raghavvs/Autonomous-Landing-of-Model-Rockets/README.md

# Autonomous-Landing-of-Model-Rockets
In this this project we attempt to land a model rocket propulsively. It is a work in progress and we'll keep this repo updated.
