raghavvs/Autonomous-Landing-of-Model-Rockets/Rocket Design/Properties.pdf

Rocket_Assembly_New_3 v8

Component Instances (1)
Area 6.253E+05 mm^2
Density 8.742E-04 g / mm^3 Mass 764.61 g
Volume | 8.746E+05 mm^3
Physical Material | (Various)

Bounding Box
Length | 234.60 mm
Width 863.863 mm
Height 234.60 mm
World X,Y,Z 0.00 mm, 0.00 mm, 0.00 mm
Center of Mass 0.092 mm, 325.495 mm, 0.056 mm

Moment of Inertia at Center of Mass (g mm^2)
Ixx = 4.811E+07
Ixy = 1.613E+04
Ixz = 311.913
Iyx = 1.613E+04
Iyy = 1.595E+06
Iyz = 6569.055
Izx = 311.913
Izy = 6569.055
Izz = 4.814E+07

Moment of Inertia at Origin (g mm^2) Ixx = 1.291E+08
Ixy = -6726.793
Ixz = 307.956
Iyx = -6726.793
Iyy = 1.595E+06
Iyz = -7452.45
Izx = 307.956
Izy = -7452.45
Izz = 1.291E+08
