raghavvs/Autonomous-Landing-of-Model-Rockets/Autonomous Precision Landing of Model Rockets_Final_compressed_final.pdf

## DAYANANDA SAGAR COLLEGE OF ENGINEERING DEPARTMENT OF MECHANICAL ENGINEERING

(Accredited by NBA)
Accredited by National Assessment & Accreditation Council (NAAC) with ‘A’ Grade AICTE Approved, an Autonomous Institute Affiliated to VTU, Belagavi Shavige Malleshwara Hills, Kumaraswamy Layout, Bengaluru-560078

## A Project Report on

# AUTONOMOUS PRECISION LANDING OF MODEL ROCKETS

## Submitted in partial fulfillment for the award of degree of

## BACHELOR OF ENGINEERING

IN

## MECHANICAL ENGINEERING

## Submitted by

## 1DS17ME093 Raghavendra N S 1DS17ME124 Sohail Nadaf 1DS17ME131 Tushar V Kulkarni 1DS17ME145 Vivek S Srinivas

### Under the guidance of

# Sanketh S

## Assistant Professor Department of Mechanical Engineering Dayananda Sagar College of Engineering, Bengaluru S M Hills, Kumaraswamy Layout, Bengaluru 560078

2020-21

Autonomous Precision Landing of Model Rockets

# DAYANANDA SAGAR COLLEGE OF ENGINEERING

## DEPARTMENT OF MECHANICAL ENGINEERING

(Accredited by NBA)
Accredited by National Assessment & Accreditation Council (NAAC) with ‘A’ Grade
AICTE Approved, an Autonomous Institute Affiliated to VTU, Belagavi) Shavige Malleshwara Hills, Kumaraswamy Layout, Bengaluru-560078

# Certificate

Certified that the project report entitled ‘Autonomous Precision Landing of Model Rockets’ is a bonafide work carried out by Raghavendra N S, Sohail Nadaf, Tushar V Kulkarni, Vivek S Srinivas, bearing USN: 1DS17ME093, 1DS17ME124, 1DS17ME131,

### 1DS17ME145, under the guidance of Prof. Sanketh S, Assistant Professor, Department of

### Mechanical Engineering, Dayananda Sagar College of Engineering, Bengaluru, in partial

### fulfilment for the award of Bachelor of Engineering in Mechanical Engineering of the

Visvesvaraya Technological University, Belagavi.

Sanketh S | Dr. R. Keshavamurthy
Assistant Professor Dayananda Sagar College of Engineering Bengaluru | Professor & Head, Dept. of Mech. Engg
| Dayananda Sagar College of Engineering
| Bengaluru

### Dr. C.P.S. Prakash

### Principal

### Dayananda Sagar College of Engineering

### Bengaluru

### External Viva-Voce

Sl. No. | Name of the Examiner | Signature with date
1
2
Department of Mechanical Engineering | ii | Dayananda Sagar College of Engineering

# DECLARATION

### We, Raghavendra N S (1DS17ME093), Sohail Nadaf (1DS17ME124), Tushar V Kulkarni

### (1DS17ME131), Vivek S Srinivas (1DS17ME145) hereby declare that the entire work

### embodied in the project report entitled ‘Autonomous Precision Landing of Model Rockets’

has been independently carried out by Batch 48 under the guidance of Prof. Sanketh S,

### Assistant Professor, Department of Mechanical Engineering, Dayananda Sagar College of

Engineering, Bengaluru, in partial fulfilment of the requirements for the award of Bachelor Degree in Mechanical Engineering of Visvesvaraya Technological University, Belagavi.

I further declare that I have not submitted this report either in part or in full to any other university for the award of any degree.

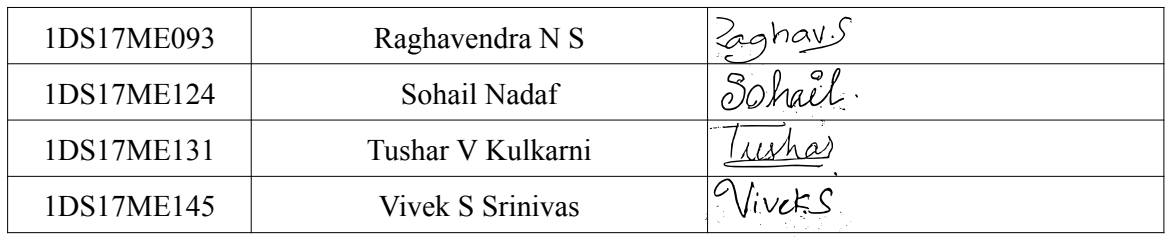
[picture p1: figure]
Raghavendra N S; Sohail Nadaf; Tushar V Kulkarni; Vivek S Srinivas

### Place: Bengaluru

### Date: 10-May-2021

Department of Mechanical Engineering | iii | Dayananda Sagar College of Engineering

# ABSTRACT

### This project aims to build a model rocket that can land vertically. By establishing an

automatic control system, we contrive to pull out any perturbations and disturbances ensuring active control. Thrust Vector Control (TVC) is the technique used for attitude (pitch and yaw) control, this gimbal mount allows the rocket to be actively stabilized and is the key component to allow the rocket to land vertically.

A closedloop feedback control system consisting of a Proportional Integral Derivative (PID)

### controller is employed to maneuver the rocket, additional components such as the Kalman

### Filter will be used to eliminate noise and disturbances from sensory feedback. A flight

computer is utilized to monitor the rocket, this includes data logging, stabilization, prediction,

### and state indication. The rocket is powered by a solid propellant motor serving as the

propulsion system.

### The rocket body and its components are designed considering the principles of Design for

### Assembly (DFA) and Design for Manufacturing (DFM), using Computer-Aided Design

### (CAD) software and analyzed using Finite Element Method (FEM) solvers. Computational

### Fluid Dynamics (CFD) is applied to visualize the flow around the rocket airframe and to

evaluate the design of passive fins.

Department of Mechanical Engineering | iv | Dayananda Sagar College of Engineering

# ACKNOWLEDGEMENT

We have taken efforts in this work. However, it would not have been possible without the kind support and help of many individuals and organizations. We would like to extend my sincere thanks to all of them.

### We express our deep sense of gratitude and indebtedness to Prof. Sanketh S, Assistant

### Professor, Department of Mechanical Engineering, for his valuable guidance, continuous

assistance in the critical appraisal of the thesis.

### We express our sincere thanks to Dr. R. Keshavamurthy, Professor and HOD, Department of

Mechanical Engineering, for providing the facilities required for the completion of this project work.

It is with great pleasure, we extend our gratitude and thanks to Dr. C P S Prakash, Principal, Dayananda Sagar College of Engineering, for his encouragement throughout the project.

Department of Mechanical Engineering | v | Dayananda Sagar College of Engineering

## Contents

List of Tables | x
List of Figures | x
List of Acronyms | x
1 Executive Summary | 1
2 Management Summary | 3
3 Conceptual Design | 6
4 Airframe | 8
5 Propulsion | 25
Department of Mechanical Engineering | vi | Dayananda Sagar College of Engineering

6 Dynamic Flight Analysis | 27
7 Thrust Vector Control | 41
8 Dynamics | 43
Department of Mechanical Engineering | vii | Dayananda Sagar College of Engineering

9 Modelling and Simulation | 61
10 Flight Computer | 65
11 Manufacturing | 75
12 Conclusions | 79
13 References | 81
14 Appendix | 83
Department of Mechanical Engineering | viii | Dayananda Sagar College of Engineering

15 ANNEXURE | 109
Department of Mechanical Engineering | ix | Dayananda Sagar College of Engineering

## List of Tables

1 | Cost breakdown | | 5
2 | Chemical Propulsion Vs Electric Propulsion | | 8
3 | Solid Propellant Vs Liquid Propellant | | 8
4 | Cardboard Material Properties | | 9
5 | Airframe Specifications | 10
6 | Polyactic Acid (PLA) Material Properties | 11
7 | Landing Leg Specifications | 11
8 | Landing Leg Strut Specifications | 12
9 | Landing Leg Circular Frame Specifications | 12
10 Fins Specifications | 13
11 Weight Distribution | 15
12 Overall Specifications | 15
13 Airframe Structural Analysis Results | 17
14 Modal Frequencies of Airframe | 19
15 Fins Structural Analysis Results | 21
16 Landing Leg Structural Analysis Results | 23
17 Landing Leg Strut Structural Analysis Results | 24
18 Bulkhead Structural Analysis Results | 25
19 F-15 Motor Specications | 26
20 Moment Table | 28
21 Flight Dynamics Parameters | 32
22 Input Parameters for Drag Analysis | 37
23 Drag Analysis Results | 38
24 Design I Specifications | 43
25 Design II Specifications | 43
26 Properties used in simulation | 61
27 Components Specifications | 70
Department of Mechanical Engineering | x | Dayananda Sagar College of Engineering

## List of Figures

1 | Team Organization | | 3
2 | Gantt Chart | | 4
3 | Risk Identification | | 5
4 | Cost Distribution | | 6
5 | Methodology: Design Phase | | 6
6 | Methodology: Manufacturing Phase | | 7
7 | Rocket Airframe | | 9
8 | Landing Legs Assembly Closed Form | 10
9 | Landing Legs Assembly Open Form | 10
10 Landing Legs Assembly Side View | 11
11 Fins Assembly Render | 13
12 Rocket Part Description | 14
13 Rocket Assembly Render | 14
14 Airframe von Mises Stress | 16
15 Airframe Displacement | 16
16 Airframe Mode 1 Shape | 17
17 Airframe Mode 2 Shape | 18
18 Airframe Mode 3 Shape | 18
19 Fins von Mises Stress | 19
20 Fins Displacement | 20
21 Fins Strain | 20
22 Fins Mode 8 Shape | 21
23 Landing Leg von Mises Stress | 22
24 Landing Leg Displacement | 22
25 Landing Leg Strut von Mises Stress | 23
26 Landing Leg Strut Displacement | 23
27 Bulkhead von Mises Stress | 24
28 Bulkhead Displacement | 24
29 F-15 Motor Thrust Curve | 26
30 OpenRocket: Simulation | 27
31 Forces on Rocket | 27
32 OpenRocket: Centre of Pressure | 29
33 C.G and C.P Mark | 29
34 Rocket Axis Orientation | 30
35 Aerodynamic Drag Representation | 33
Department of Mechanical Engineering | xi | Dayananda Sagar College of Engineering

36 Cf Vs Velocity | 33
37 Cfc Vs Velocity | 33
38 CDLT Vs Velocity | 34
39 CDBT Vs Velocity | 34
40 CDfT Vs Velocity | 34

41 CDt

T Vs Velocity | 34
42 CDTT Vs Velocity | 34
43 CDBP Vs Velocity | 35
44 CDBB Vs Velocity | 35
45 CfB Vs Velocity | 35
46 CDTB Vs Velocity | 35
47 CD Vs Velocity | 36
48 CD Vs Reynolds Number | 36
49 Component Drag Vs Velocity | 36
50 Component Drag Distribution | 36
51 Velocity Field | 40
52 Pressure Field | 40
53 Gimbaled TVC | 41
54 Design I | 42
55 Design II | 42
56 Inner Product | 44
57 Vector Product | 45
58 P! being expressed in Fr and F1 | 46
59 Rodrigues’ Rotation | 47
60 Fv to F1 | 48
61 F1 to F2 | 49
62 F2 to Fb | 49
63 Quaternions | 54
64 Rigid body hurtling through space | 55
65 Rotation and Translation | 56
66 Simulink Blocks | 60
67 Basic Flight Simulation | 62
68 Results | 62
69 3 DOF Flight Simulation | 63
70 Actuator Subsystem | 63
71 Trajectory | 64
72 Acceleration | 64
Department of Mechanical Engineering | xii | Dayananda Sagar College of Engineering

73 Microcontroller: Teensy 3.2 | 65
74 IMU: MPU6050 Module | 66
75 Altimeter: BMP180 Module | 66
76 nRF24l01+ Transceiver module | 67
77 Voltage Regulator | 67
78 Trigger Channels | 68
79 Metal Gear Servo Motor | 68
80 LiPO Battery | 69
81 Flight Computer 1 | 69
82 Flight Computer 2 | 70
83 Schematics | 71
84 Printed Circuit Board | 72
85 Block Diagram | 73
86 Flow Chart | 74
87 Processing via Python | 75
88 FDM Printer: Ender 3 | 76
89 Airframe | 77
90 Fins | 78
91 Landing Leg Assembly Closed Form | 78
92 Landing Leg Assembly Open Form | 79
93 Thrust Vector Control | 79
Department of Mechanical Engineering | xiii | Dayananda Sagar College of Engineering

## List of Acronyms

α | Angle of Attack
ρ | Density
c | Chord
Cl | Sectional Lift Coefficient
CD | Coefficient of Drag
CFD | Computational Fluid Dynamics
M∞ | Freestream Mach Number

D Drag

L Lift

rle | Leading Edge Radius
DOF | Degrees of Freedom
CG | Center of Gravity
TVC | Thrust Vector Control
NED | North-East-Down
FEM | Finite Element Method
FVM | Finite Volume Method
RANS | Reynolds Averages Navier Stokes
LES | Large Eddy Simulation
DNS | Direct Numerical Simulation
FFF | Fused Filament Fabrication
FDM | Fused Deposition Modelling
PLA | Polylactic Acid
ABS | Acrylonitrile Butadiene Styrene
PETG | Polyethylene Terephthalate Glycol
TPU | Thermoplastic Polyurethane
DFA | Design for Assembly
DFM | Design for Manufacturing
CAD | Computer-Aided Design
FEM | Finite Element Method
CFD | Computational Fluid Dynamics
IMU | Inertial Measurement Unit
AHRS | Attitude Heading Reference System
Department of Mechanical Engineering | xiv | Dayananda Sagar College of Engineering

## 1 Executive Summary

Traditionally, payloads have been delivered into space using rockets, upon running out of fuel these rocket boosters

are expended and either burn up in the atmosphere or crash into the ocean. This is extremely wasteful and is

economically unviable. Reusing launch vehicles just like airplanes will lead to a reduction of the cost of access to

space by as much as a factor of a hundred. In the past few years, companies like SpaceX and Blue Origin have

successfully reused a launch vehicle.

Our project proposes to bridge this gap and contribute to the increasing need for small scale launch vehicles. The

goal of this project is to build a fully reusable and autonomously landing model rocket. This involves developing

the hardware, software, simulations, and procedures necessary to propulsively land a small scale rocket with the

capability of reuse.

Another hurdle we plan to tackle is to propulsively land using a solid propellant motor that doesn’t possess throttle

control, unlike largescale rockets that use a liquid propellant engine that could use throttle control. Our project

analysis indicates that the successful development of this system shows significant potential to save costs for

smaller launch vehicles by enabling them to propulsively land and be reused. For report writing, the team used

LaTeX software.

### 1.1 Objectives

- Building an aerodynamic rocket body and fins to achieve maximum passive stability.
- Developing a Thrust Vector Control (TVC) system for active attitude control.
- Integrating a Flight computer for Data logging and various other operations.
- Developing Landing legs to withstand the impact and ensuring the safety of components.
- Modelling and Simulation of rocket dynamics using MATLAB & Simulink.
- Testing and validation of designed components.

### 1.2 Literature Review

The concept of retrieving a launch vehicle/rocket after successful execution of its launching stages is an

inherently challenging task owing to the large number of uncertainties in the upper atmosphere. These

uncertainties coupled with the scale of costs involved with space missions necessitate the implementation of

model rockets to realize the behaviour of control systems which are used in precision landing of the rocket. In

this report we present an autonomous precision landing control system, along with the necessary dynamics and

simulations required to support this claim. As this project involves application of different domains like control

systems, spacecraft dynamics and controls, aerodynamic stability, MEMS, the literature survey conducted is

modular, with an emphasis on control systems and dynamics.

Department of Mechanical Engineering | 1 | Dayananda Sagar College of Engineering

- M. Haw, A8-3 Model rocket impulse measurement, Science One Research Projects (Undergraduate Science

Program), University of British Columbia, British Columbia, Canada, May 2009.

This paper depicts the measurement of thrust from the model rocket engine in the form of impulse. It

also gives an emphasis on the measurement of impulse from the rocket engine as it will majorly affect the

trajectory of the descending model rocket. The methodology includes the measurement of thrust as a function

of time and extracting impulse readings using finite difference approximations.

- R. Ferrante, A Robust Control Approach for Rocket Landing, M.S. thesis, Artificial Intelligence, School of

Informatics, University of Edinburgh, Scotland, 2017.

This M.S. thesis provides a concise description of control techniques and simulation environments for

modelling a rocket. Although the thesis involves actual scale, it does very well apply to model rockets with

suitable assumptions.

- L. Blackmore Autonomous precision landing of space rockets, Frontiers of Engineering: Reports on Leading-

Edge Engineering from the Symposium 2016.

The paper discusses the importance of reusing space rockets and its challenges.

- F. Kehl, A. M. Mehta, K. S. J. Pister, An Attitude Controller for Small Scale Rockets, Springer Tracts in

Advanced Robotics, Jan 2015.

In this paper, the hardware testing and experimental tests were conducted along with a depiction of

implementation of PID control techniques.

- Penn, Kim & Slaton, William, Measuring Model Rocket Engine Thrust Curves, The Physics Teacher, 2010.

The paper provides a methodology for solid propellant model rocket engine thrust curves which is used to

determine the engine ignition altitude.

- Aliyu Bhar Kisabo and Aliyu Funmilayo Adebimpe,State-Space Modeling of a Rocket for Optimal Control

System Design, Centre for Space Transport and Propulsion (CSTP), 2010.

This paper delineates the basic equations defining the airframe dynamics of a typical six degrees of freedom

(6DoFs) are nonlinear and coupled. It also presents a novelapproach to linearization of 6DoF equations in

a general form.

- Florian Kehl, Ankur M. Mehta and Kristofer S. J. Pister An Attitude Controller for Small Scale Rockets,

Springer Tracts in Advanced Robotics, 2015.

This paper comprises of minirocket design, adaptation for minirocket design, guidance control system,

hardware testing and experimental results such as, sensor validation and attitude control validation.

- Mark D. Stevenson and Jeffrey V. Zweber, Multidisciplinary Conceptual Vehicle Modelling, American

Institute for Aeronautics and Astronautics (AIAA), 2001.

This paper narrates the discipline interaction, vehicle geometry, rocket engine design code, weight

analysis, aerodynamic analysis, trajectory analysis, trade studies and thrusttoweight optimization.

Department of Mechanical Engineering | 2 | Dayananda Sagar College of Engineering

- B. Stevens and F. Lewis, Aircraft Control and Simulation. Wiley, 2003.

This textbook covers flight control systems, flight dynamics, aircraft modeling, and flight simulation from

both classical design and modern perspectives, as well as two new chapters on the modeling, simulation,

and adaptive control of unmanned aerial vehicles.

- S. Niskanen, “Openrocket technical documentation,” Development of an Open Source model rocket

simulation software.

The thesis is used as the basis of this technical documentation, which is updated to account for later

development in the software. Discussed the development and documentation for relatively easy, yet

reasonably accurate methods for the calculation of the fundamental aerodynamic properties of model.

Implementation of a crossplatform, open source model rocket design and simulation software.

- P. Kuentzmann, “Introduction to Solid Rocket Propulsion,” Office National d’Etudes et de Recherches

Aérospatiales, 2000.

This paper describes the fundamentals of solid rocket propulsion (SRM) from the elementary analysis of

rocket operation. It also contains a short review of internal aerodynamics of SRM and the basic formula to

predict the steadystate operation pressure.

## 2 Management Summary

### 2.1 Team Organization

The team comprised of four members and the responsibilities were equally distributed.

- Airframe & Propulsion Research, Sizing, Design, CFD & Optimization, Selection of Propulsion System
- Modelling & Simulation Research, Dynamics & Control, Analysis using MATLAB & Simulink
- Thrust Vector Control Research, Fabrication, Testing & Optimization
- Flight Computer Research, Flight Computer Design, PCB Design, Testing

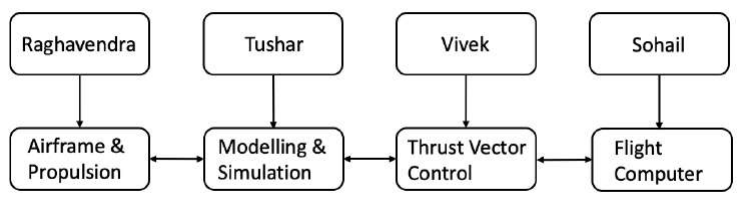
[picture p2: figure]

Figure 1: Team Organization

Department of Mechanical Engineering | 3 | Dayananda Sagar College of Engineering

### 2.2 Milestone Chart

The Gantt chart was implemented to plan the workflow and to keep a track of progress. The blue bar shows the

planned days and the grey bar shows the actual days. From the chart it is evident that testing and procurement of

materials took longer than anticipated.

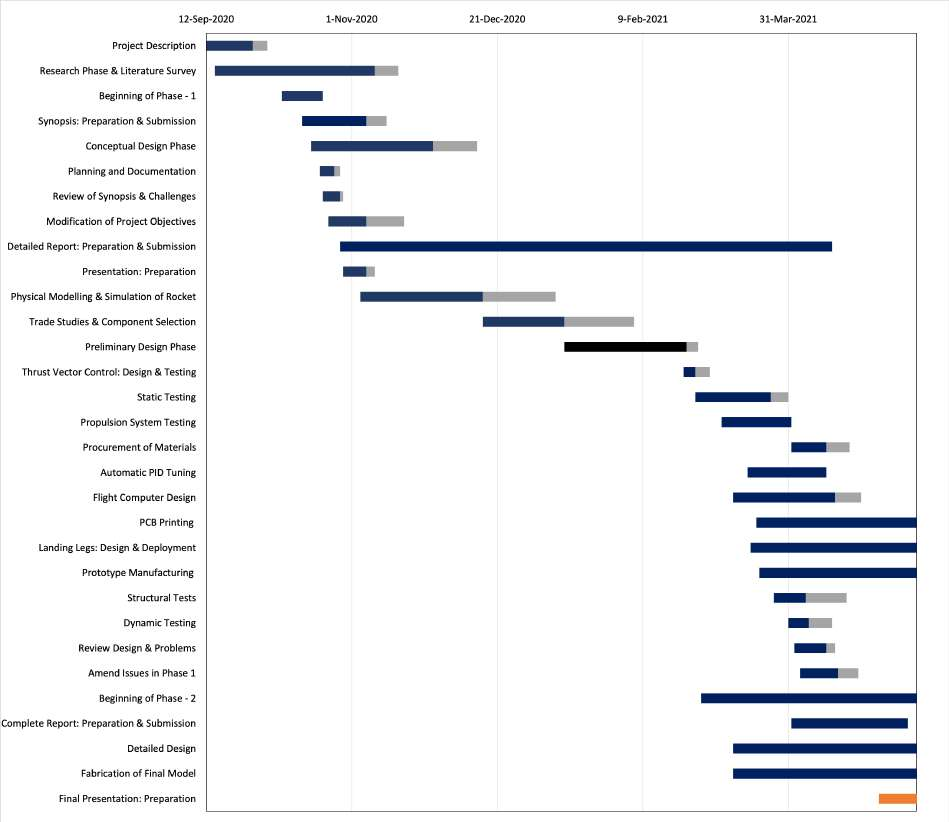
[picture p3: figure]

Figure 2: Gantt Chart

### 2.3 Risk Analysis

A risk assessment chart is depicted below and it helps in understanding and managing the risks involved. It is

apparent from the chart that both the likelihood and consequences of tipping over during landing is likely and the

consequences are high.

Department of Mechanical Engineering | 4 | Dayananda Sagar College of Engineering

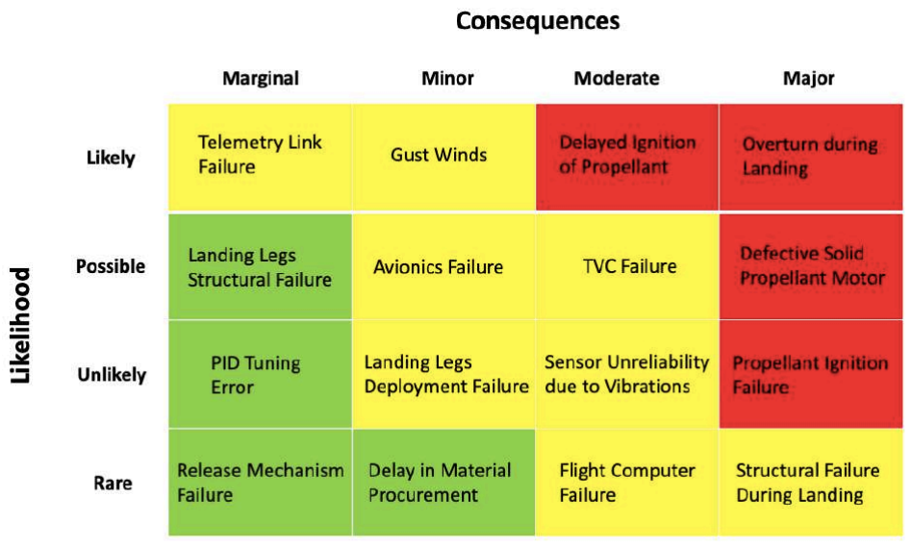
[picture p4: figure]

Figure 3: Risk Identification

### 2.4 Budget Details

The team had a budget of Rs. 25,000 for the entire project. We managed to stay under budget, the team’s total

expenses came up to be Rs. 21,200. Expenditure towards avionics accounted for majority of team’s total budget.

Sl. No. | Description | Cost (in Rs.)
1 | Avionics | 9700
2 | PLA Material | 1200
3 | Testing Equipment | 5200
4 | Body | 600
5 | Miscellaneous | 4500
6 | Total | 21200

Table 1: Cost breakdown

Department of Mechanical Engineering | 5 | Dayananda Sagar College of Engineering

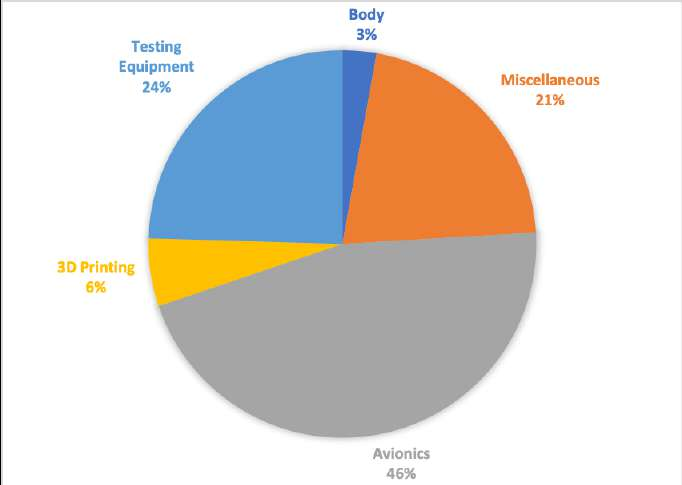
[picture p5: figure]

Figure 4: Cost Distribution

## 3 Conceptual Design

### 3.1 Overall Methodology

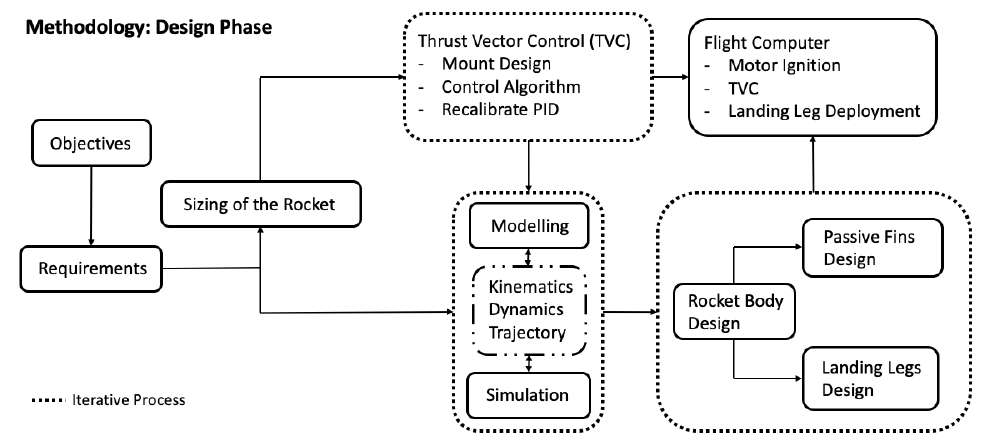
[picture p6: figure]

Figure 5: Methodology: Design Phase

We began by clearly defining the project’s core objectives, which was followed by the description of requirements,

which led to the rocket’s sizing. TVC mount was created with the help of computeraided design (CAD) software.

Iterations were carried out until the desired product was achieved. Simultaneously, MATLAB and Simulink were

used to model and simulate the rocket dynamics and trajectory. The rocket body, fins, and landing legs were then

designed. The shape of fins was analysed using computational fluid dynamics (CFD). Various tasks, such as TVC,

motor ignition, and landing leg deployment, were programmed into the flight computer. Lastly, the rocket’s flight

Department of Mechanical Engineering | 6 | Dayananda Sagar College of Engineering

was simulated to ascertain PID gains.

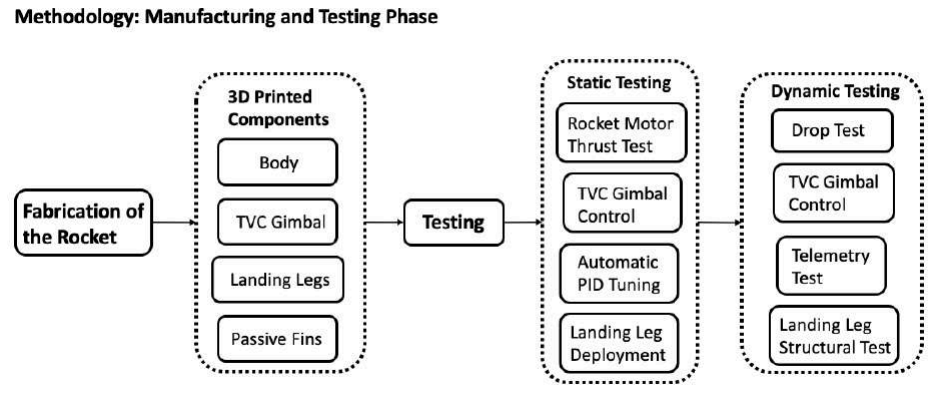
[picture p7: figure]

Figure 6: Methodology: Manufacturing Phase

The manufacturing and testing phase were carried out after conducting all the necessary computer simulations,

design finalization and CFD analyses. 3D printing was used to fabricate the landing legs, fins and thrust vector

control. The necessary components for testing as well as some internal parts for the rocket body were printed using

a 3D printer. The manufacturing phase was followed by the testing phase, which began with static tests. First, a

static thrust test of the rocket motor, a TVC gimbal test, and a landing leg deployment test. Then we moved on to

dynamic testing, where we performed a drop test, a telemetry test, and an impact test on the landing legs.

### 3.1.1 Trade Studies

We used a Pugh Matrix method for selection of propulsion system, beginning with choosing the type of propulsion

i.e., chemical propulsion and electric propulsion. This method of selection helped us objectively choose the kind

of propulsion while having numerous subjective and arbitrary parameters. The weightage for the parameters were

given as per the team’s objectives and priorities, and accordingly weight and cost were given the utmost importance

considering the design restriction. The reason behind considering electric propulsion in the first place was to have

more control over the throttle and have capacity to conduct frequent and a number of tests without worrying about

the flight time i.e., the endurance. This table below shows that the chemical propulsion is relatively more desirable

for our project.

Department of Mechanical Engineering | 7 | Dayananda Sagar College of Engineering

Parameters | Weight | Chemical Propulsion | Electric Propulsion
Weight | 5 | 5 | 1
Complexity | 3 | 3 | 3
Reusability | 3 | 1 | 5
Feasibility | 4 | 3 | 3
Cost | 4 | 4 | 2
Total | | 65 | 49

Table 2: Chemical Propulsion Vs Electric Propulsion

As per the kind of propellant, we considered both solid propellant and liquid propellant. The weightage for the

parameters were given as per the team’s objectives and priorities, and accordingly ability to throttle and cost were

given the utmost importance. From this table below we concluded to go with solid propellant.

Parameters | Weight | Solid Propellant | Liquid Propellant
Throttleable | 3 | 1 | 5
Complexity | 3 | 4 | 2
Reusability | 3 | 1 | 4
Feasibility | 4 | 5 | 3
Cost | 4 | 5 | 1
Total | | 58 | 49

Table 3: Solid Propellant Vs Liquid Propellant

## 4 Airframe

### 4.1 Methodology

The airframe design was dictated by two parameters, namely weight and lower bending moment to reduce the

chances of the rocket tipping over upon landing and this is imperative in achieving the team’s objectives.

For the airframe, we considered cardboard as the choice of material since it had desirable properties such as high

strength to weight ratio, low density which translates lower weight, easy to work with and economical.

The airframe diameter and length were decided upon iterative process. Parametric analysis was carried out using

fineness ratio (length to diameter ratio) and this helped us in determining the optimum ratio. The range of fineness

ratio is generally 10:1 to 20:1 [1][2][3]. The parameters that are affected by fineness ratio are:

- Skin friction drag
- Pressure drag
Department of Mechanical Engineering | 8 | Dayananda Sagar College of Engineering

- Bending moment

The chosen ratio is 10:1 which is the lowest fineness ratio since this aids in maintaining a lower overall weight

and also assists in keeping the bending moments to a minimum. The skin friction drag is reduced mainly due

to relatively lower wetted are and the pressure drag is slightly increased this is because the pressure distribution

around a body which has low fineness ratio is not ideal and this causes the increase in pressure drag. The airframe

houses the propulsion system, thrust vector control system and electronics. Externally, the fins and landing legs

are attached to the airframe as well.

### 4.1.1 Airframe Mechanical Design

The airframe design and modelling was accomplished on Autodesk Fusion 360. As for the design approach, the

team was limited in terms of varying the shell thickness of the airframe due to unavailability of cardboard tubes

which was the material of choice for the airframe. The airframe’s diameter was chosen based on the propellent’s

diameter and thrust vector control system’s outer gimbal diameter apart from fineness ratio. Consequently the

length was determined.

Figure 7: Rocket Airframe

The material properties of rocket airframe tube i.e., cardboard is presented in the table below. A noteworthy

property of cardboard is its endurance, high strength to weight ratio, low impact on sudden impulsive forces and

also substantially economical.

Sl. No. | Description | Value
1 | Density | 195 kg/m³
2 | Poisson’s Ratio | 0.34
3 | Elasticity Modulus | 2194 MPa
4 | Shear Modulus | 565 MPa

Table 4: Cardboard Material Properties

Department of Mechanical Engineering | 9 | Dayananda Sagar College of Engineering

Sl. No. | Parameters | Values
1 | Length | 0.762m
2 | Outer Diameter | 0.076m
3 | Inner Diameter | 0.073m
4 | Thickness | 0.003m
5 | Fineness Ratio | 10

Table 5: Airframe Specifications

### 4.2 Landing Legs

### 4.2.1 Design

The landing leg design was mainly inspired from SpaceX’s Falcon 9 Rocket. The team used a open source design

from K-9 landing leg system as a basis and we further modified the design to optimize for weight and strength. The

derived design helped the team to accelerate the process and arrive at the final design with minimum iterations.

The choice of material for this subsystem was Polyactic Acid (PLA) largely since the team had an easy access to

a 3D printer and it was economical too. The landing leg subsystem consists of four landing legs, four struts to

support the legs upon landing and a circular frame which houses all these. This circular frame is directly attached

to the airframe with the help of screws. The figures below show both the open and closed form of the landing legs.

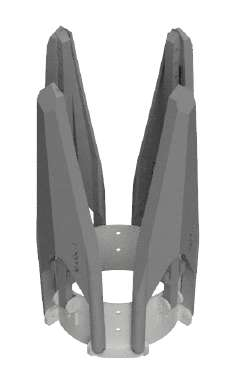
[picture p8: figure]

Figure 8: Landing Legs Assembly Closed Form

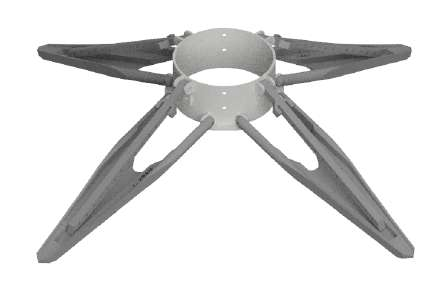
[picture p9: figure]

Figure 9: Landing Legs Assembly Open Form

In the figure below, the side view of the landing leg is shown, the landing legs are in open configuration and the opening angle for the leg is 109.4o and for the strut it is 115.4o.

Department of Mechanical Engineering | 10 | Dayananda Sagar College of Engineering

Figure 10: Landing Legs Assembly Side View

The choice of materials as previously mentioned is dictated by strength, weight and cost. Hence the team

decided to move forward with PLA. PLA has significantly better elasticity and it is not as brittle as other alternatives

such as ABS. Flexural strength of the material is also high which helps upon on impact on landing. The material

properties of PLA are presented in the table below.

Sl. No. | Description | Value
1 | Density | 1250 kg/m³
2 | Poisson’s Ratio | 0.34
3 | Elasticity Modulus | 3500 MPa
4 | Shear Modulus | 1287 MPa
1 | Melting Temperature | 170oC
2 | Injection Molding Temperature | 240oC
3 | Tensile Strength | 66 MPa
4 | Flexural Strength | 110 MPa

Table 6: Polyactic Acid (PLA) Material Properties

Sl. No. | Parameters | Values
1 | Length | 0.195m
2 | Root Width | 0.45m
3 | Tip Width | 0.015m
4 | Thickness | 0.01m
5 | Taper Ratio | 30
6 | Opening Angle | 109.4o

Table 7: Landing Leg Specifications

Department of Mechanical Engineering | 11 | Dayananda Sagar College of Engineering

Sl. No. | Parameters | Values
1 | Length | 0.165m
2 | Root Width | 0.009m
3 | Tip Width | 0.005m
4 | Thickness | 0.01m
6 | Opening Angle | 115.4o

Table 8: Landing Leg Strut Specifications

Sl. No. | Parameters | Values
1 | Length | 0.4m
2 | Outer Diameter | 0.079m
3 | Inner Diameter | 0.076m
4 | Thickness | 0.003m

Table 9: Landing Leg Circular Frame Specifications

### 4.3 Passive Fins

The stability and control of the rocket is determined by the fins’s reference area, wetted area, airfoil, thickness,

number of fins and position of the fins. Usually rocket’s fins are usually placed in the bottom of the body around the

propulsion system whereas in our project we only focused on landing the rocket and hence the fins were positioned

at the top of the rocket and this helps to head the TVC and propulsion system into the wind. These fins have a

passive control during the descent of the rocket and the team decided not to go with active control of the fins as

this could increase the complexity of control system design as well as the dynamics of flight.

### 4.3.1 Design

For the design of fins the team went for a flat plate design and discarded the use of any airfoils for the sake of

simplicity and also upon analysis it deemed unnecessary. The ratio of fin chord to diameter ratio and fin span to

diameter ratio is 2:1 and 1:1 respectively [1]. This was considered as a design criteria and we modelled the fins

using Autodesk Fusion 360 software. The team again chose to use PLA as the material for fins but the weight of

the fins went beyond the restricted limit, so weight reduction was carried out and it was layered with MonoKote

to cover the cutouts. The fins were attached with a circular ring and the circular ring is attached to the airframe with screws. The range for sweep angle is between 45 to 70 degrees [1], the sweep angle the team chose was 45o

as the flight was in subsonic region.

Department of Mechanical Engineering | 12 | Dayananda Sagar College of Engineering

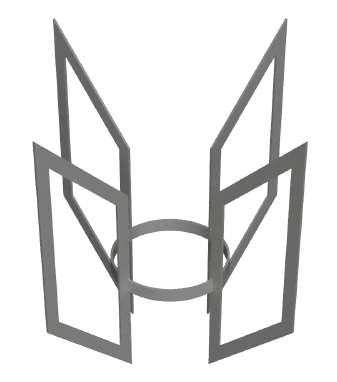
[picture p10: figure]

Figure 11: Fins Assembly Render

Sl. No. | Parameters | Values
1 | Chord | 0.152m
2 | Span | 0.076m
3 | Thickness | 0.003m
4 | Sweep Angle | 45o
5 | Chord to Diameter Ratio | 2:1
6 | Span to Diameter Ratio | 1:1
6 | Number of Fins | 4

Table 10: Fins Specifications

### 4.4 Assembly

The rocket’s main parts include fins, bulkheads, flight computer, airframe, landing legs, firewall, propellant and

thrust vector control. The picture below depicts all the components and a render of the assembled rocket. For the

rocket’s assembly the team decided to use temporary joints instead of permanent joints so as to increase modularity

and ease of replacement of parts in case of damage. For assembly, screws were used for attaching fins, TVC,

bulkheads and landing legs.

Department of Mechanical Engineering | 13 | Dayananda Sagar College of Engineering

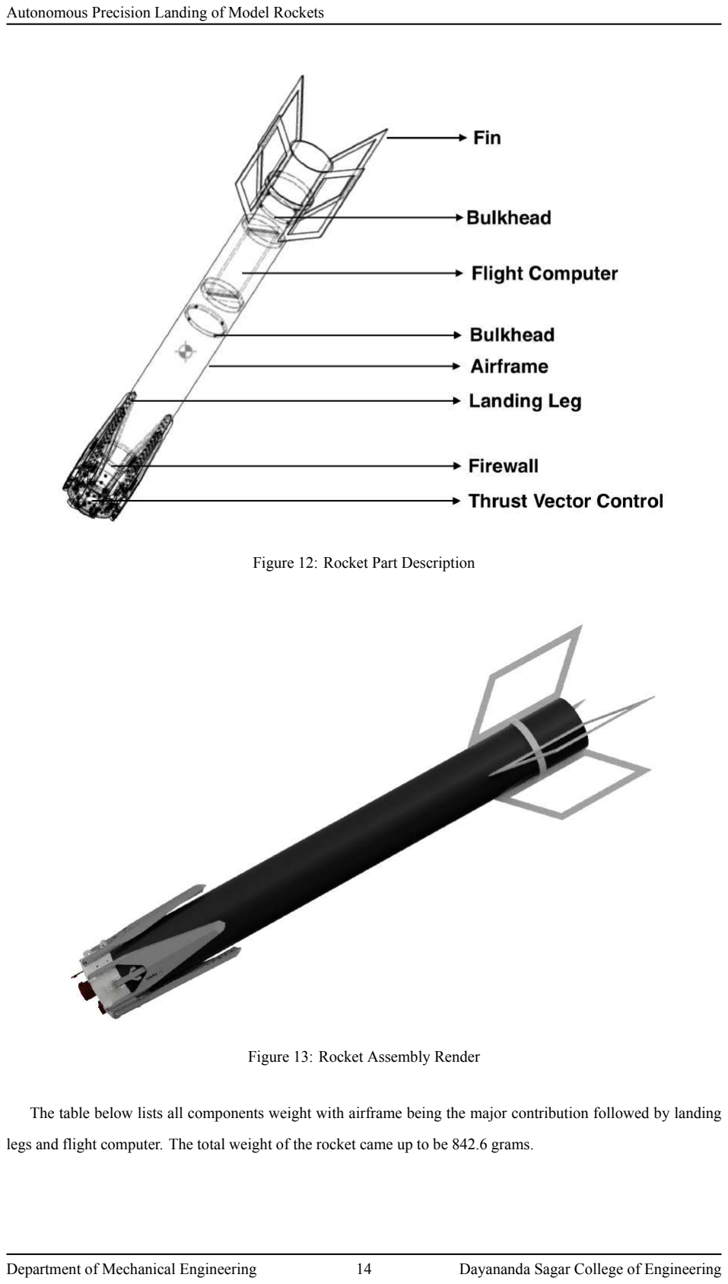
[picture p11: page 28]

Figure 12: Rocket Part Description

Figure 13: Rocket Assembly Render

The table below lists all components weight with airframe being the major contribution followed by landing

legs and flight computer. The total weight of the rocket came up to be 842.6 grams.

Department of Mechanical Engineering | 14 | Dayananda Sagar College of Engineering

Sl. No. | Components | Values (in grams)
1 | Airframe | 370
2 | Fins | 55.6
3 | Landing Legs | 214.5
4 | Propulsion | 50
5 | Thrust Vector Control | 52.5
6 | Flight Computer | 100
7 | Total Weight | 842.6

Table 11: Weight Distribution

Sl. No. | Parameters | Values
1 | Length | 0.835m
2 | Width | 0.381m
3 | Weight | 842.6g

Table 12: Overall Specifications

### 4.5 Analysis

### 4.5.1 Airframe Structural Analysis

The airframe takes in notable amount of stress during descent phase, apart from the force due to its weight a landing

impact load of five times its weight is applied on the airframe. The stresses on the airframe also includes upward

thrust force from the propulsion system which is transferred through the thrust vector control system. Autodesk

Fusion 360 software was used for both modelling and analysis using finite element method. In the Figure 14 below

von Mises stress analysis is carried out and the results are tabulated. The applied force is 50N on the rim of the

airframe which is a point force, the stresses and the displacement due to stress is minimal and within the factor of

safety and this does not lead to bending or yielding of airframe.

Department of Mechanical Engineering | 15 | Dayananda Sagar College of Engineering

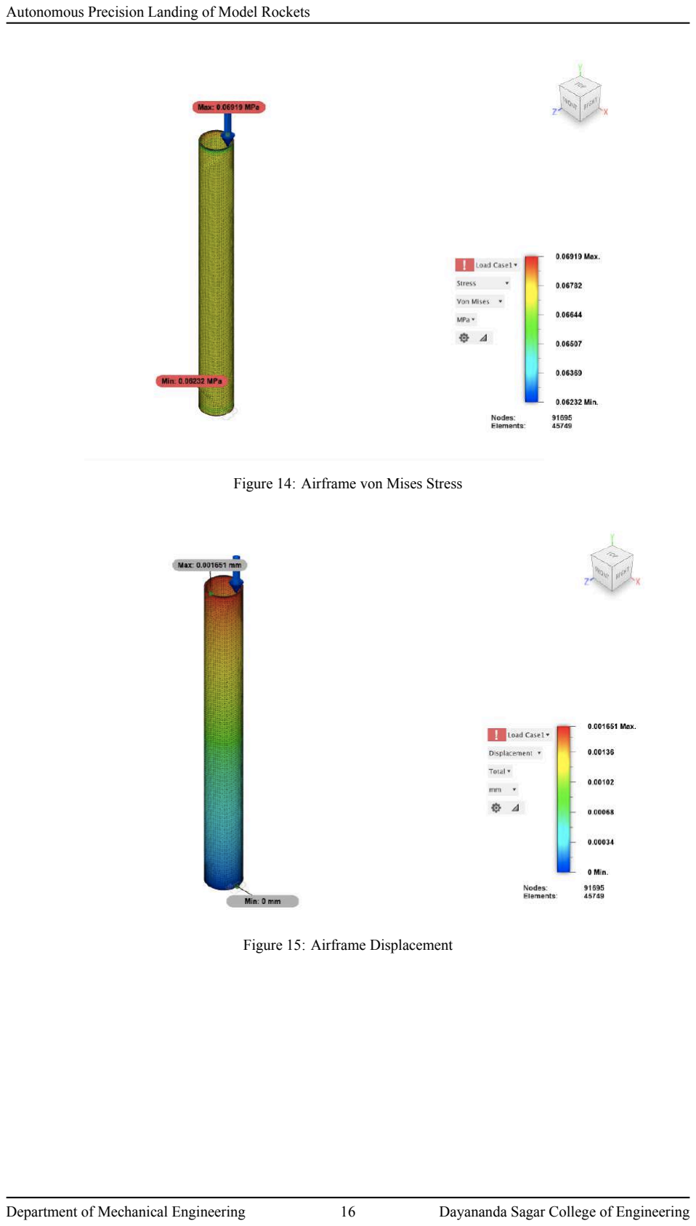
[picture p12: page 30]

Figure 14: Airframe von Mises Stress

Figure 15: Airframe Displacement

Department of Mechanical Engineering | 16 | Dayananda Sagar College of Engineering

Sl. No. | Parameters | Values
1 | Applied Force | 50N
2 | Maximum Stress | 0.069MPa
3 | Minimum Stress | 0.063MPa
4 | Maximum Displacement | 0.002mm
5 | Minimum Displacement | 0mm
6 | Mesh Size | 1mm
7 | Nodes | 91695
8 | Elements | 45749

Table 13: Airframe Structural Analysis Results

### 4.5.2 Airframe Modal Frequency Analysis

Modal frequency analysis was conducted to determine the natural frequency of the airframe. This was considered

paramount since we aimed to increase the natural frequency of the airframe to minimize flutter by preventing

the occurrence of resonance. The potential of resonance can lead to colossal damage to the airframe, hence this

analysis was helpful in determining the eigenfrequencies and its respective eigenmodes. The natural frequencies

and the mode shapes are tabulated.

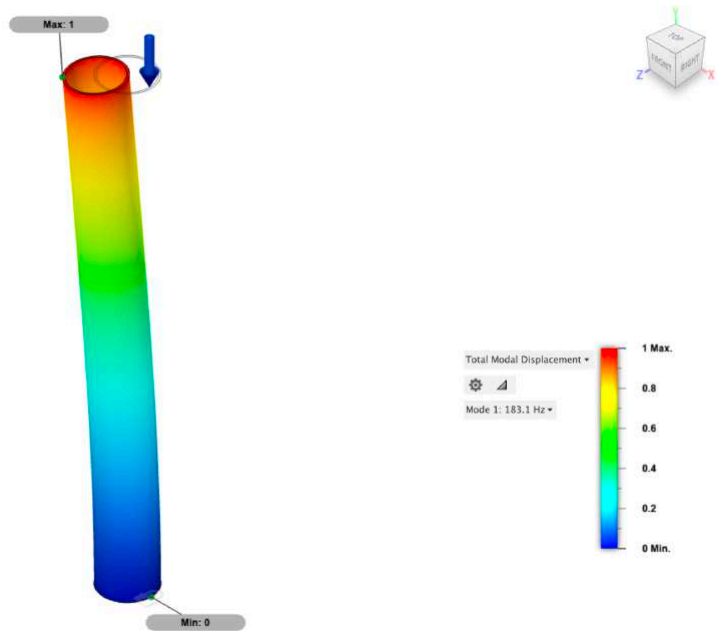
[picture p13: figure]

Figure 16: Airframe Mode 1 Shape

Department of Mechanical Engineering | 17 | Dayananda Sagar College of Engineering

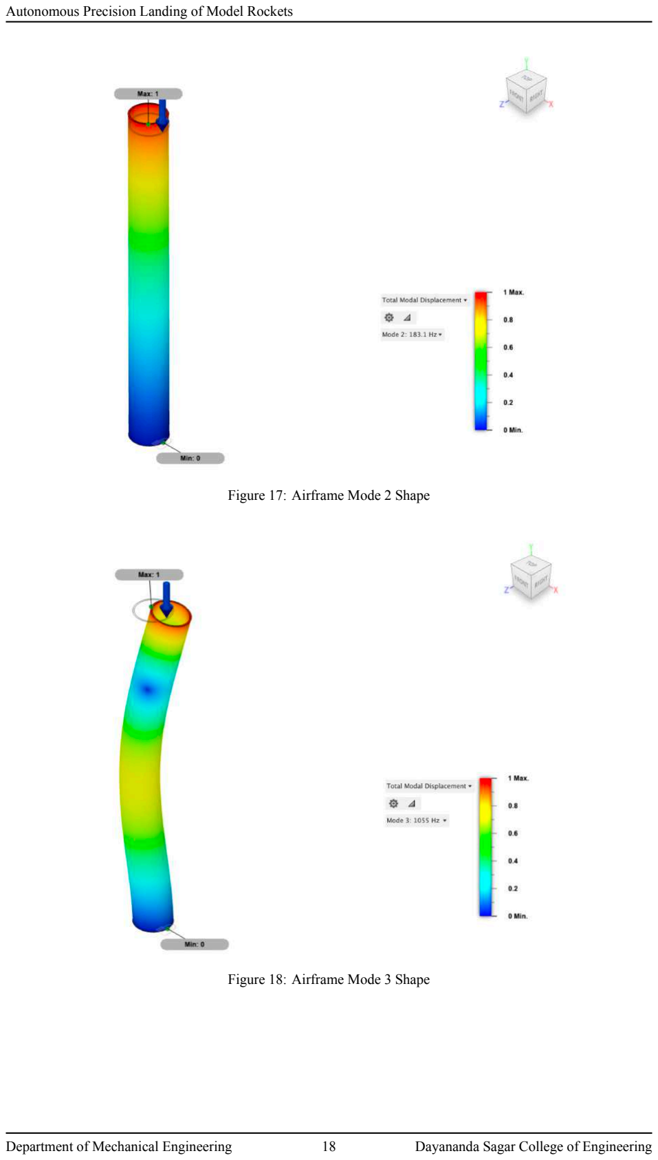
[picture p14: page 32]

Figure 17: Airframe Mode 2 Shape

Figure 18: Airframe Mode 3 Shape

Department of Mechanical Engineering | 18 | Dayananda Sagar College of Engineering

Sl. No. | Mode Shape | Natural Frequency (in Hz)
1 | Mode 1 | 183.1
2 | Mode 2 | 645.7
3 | Mode 3 | 1055

Table 14: Modal Frequencies of Airframe

### 4.5.3 Fins Structural Analysis

The fins undergo immense flutter during descent phase and since they play a crucial role in enabling passive

stability so as to maintain upright position, following through with static structural analysis was integral. The

joints strength, flutter analysis, deformation, maximum and minimum stresses and strain, and the displacement

due to stress were the parameters that were evaluated. A uniformly applied force of 10N was applied on the each

of the four fins and from the von Misses stress analysis it is evident that the stress was mostly concentrated at the

joint of fin ring and the fins while the displacement of the fins was at the far end of the fin. All the parameters and

their are tabulated below.

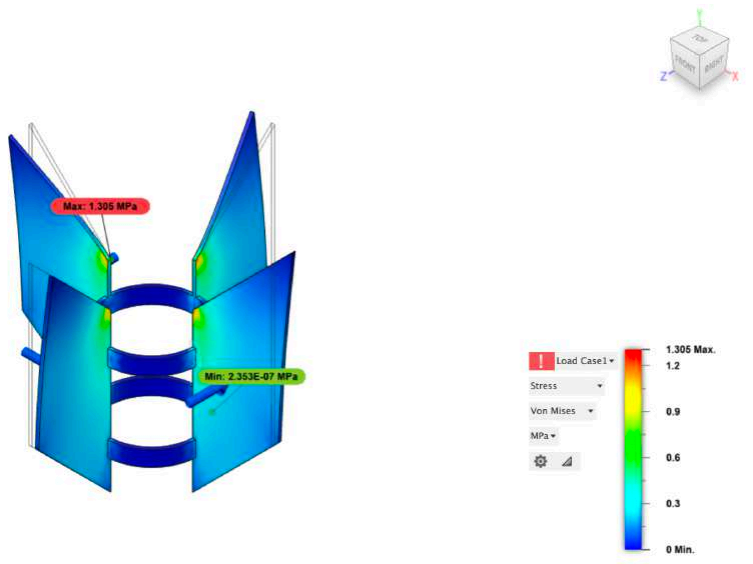
[picture p15: figure]

Figure 19: Fins von Mises Stress

Department of Mechanical Engineering | 19 | Dayananda Sagar College of Engineering

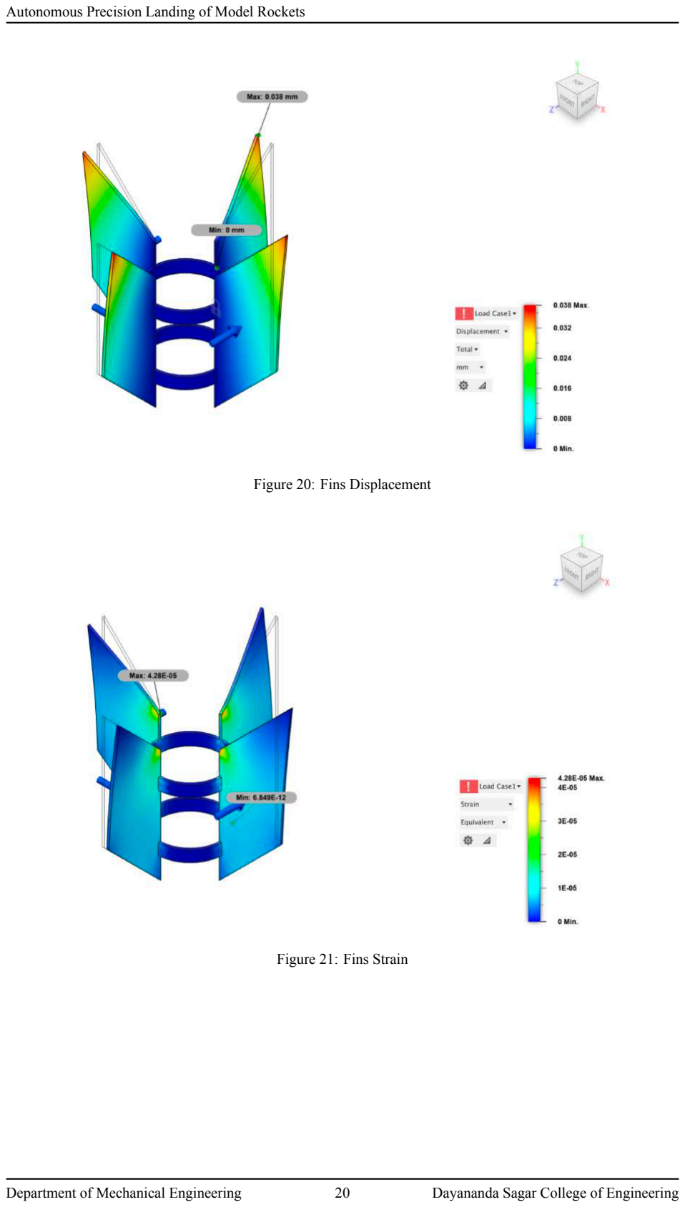
[picture p16: page 34]

Figure 20: Fins Displacement

Figure 21: Fins Strain

Department of Mechanical Engineering | 20 | Dayananda Sagar College of Engineering

Sl. No. | Parameters | Values
1 | Applied Force | 10N
2 | Maximum Stress | 1.305MPa
3 | Minimum Stress | 2.35e-07MPa
4 | Maximum Displacement | 0.038mm
5 | Minimum Displacement | 0mm
6 | Maximum Strain | 4.28e-05
7 | Minimum Strain | 6.84e-12
8 | Mesh Size | 1mm

Table 15: Fins Structural Analysis Results

### 4.5.4 Fins Modal Frequency Analysis

Modal frequency analysis was conducted to determine the natural frequency of the fins. This was considered

paramount since we aimed to increase the natural frequency of the fins to minimize flutter by preventing the

occurrence of resonance. The potential of resonance can lead to colossal damage to the fins and fins play a huge

role in maintaining the stability of the flight during descent, hence this analysis was helpful in determining the

eigenfrequencies and its respective eigenmodes. The natural frequency of fins in mode 8 is 1216Hz.

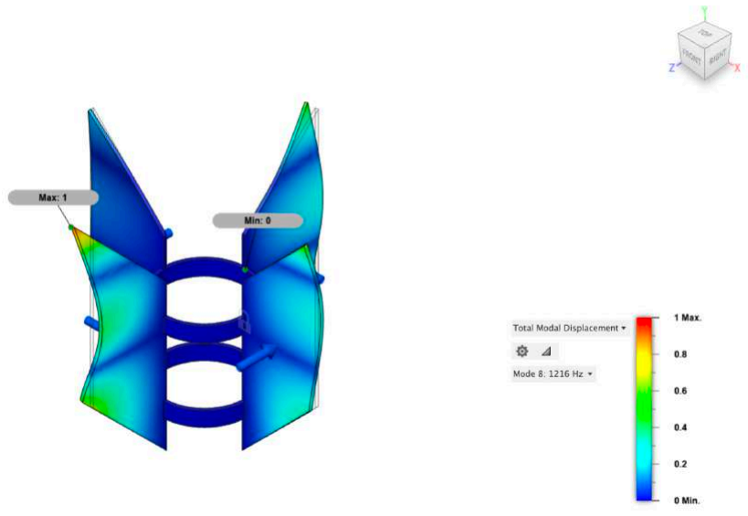
[picture p17: figure]

Figure 22: Fins Mode 8 Shape

Department of Mechanical Engineering | 21 | Dayananda Sagar College of Engineering

### 4.5.5 Landing Legs Structural Analysis

The landing legs is the only component that is going to experience imminent stress from the impact due to landing.

The stresses from landing legs is transferred to the struts which help them stay in that position. The stresses from

the struts are transmitted to the circular frame and then to the airframe. The analysis of von Mises stress on landing

legs showed significant stress at the joint of landing leg to the circular frame and minimum stress at the point of

contact with the ground. For this analysis an impact force of 50N was applied which is five times the weight of the

entire rocket and upon analysis, the landing legs can sustain the stresses without leading to breaking or yielding of

the material. The results from the analysis are tabulated below.

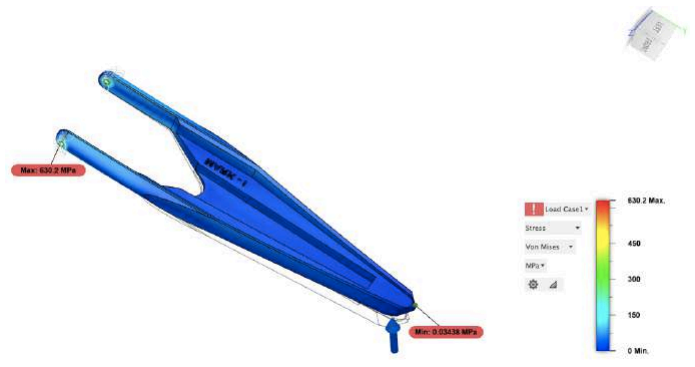
[picture p18: figure]

Figure 23: Landing Leg von Mises Stress

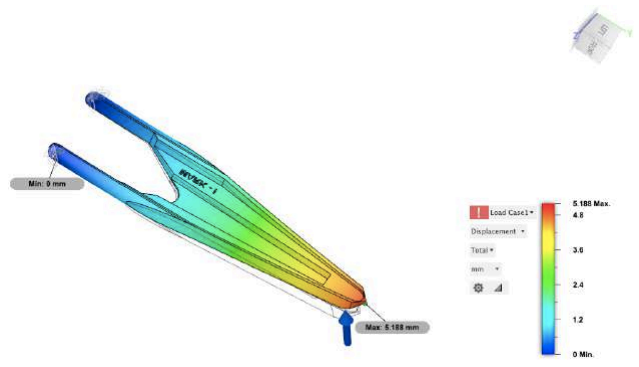
[picture p19: figure]

Figure 24: Landing Leg Displacement

Department of Mechanical Engineering | 22 | Dayananda Sagar College of Engineering

Sl. No. | Parameters | Values
1 | Applied Force | 50N
2 | Maximum Stress | 630.2MPa
3 | Minimum Stress | 0.034MPa
4 | Maximum Displacement | 5.188mm
5 | Minimum Displacement | 0mm
6 | Mesh Size | 1mm

Table 16: Landing Leg Structural Analysis Results

Similar to landing legs static structural analysis, we carried out a structural analysis on the landing leg strut

and the results too were quite similar. The applied force was 50N at the contact point and maximum stress was

experienced at the joint of the strut with the circular frame. The results from the analysis are tabulated below.

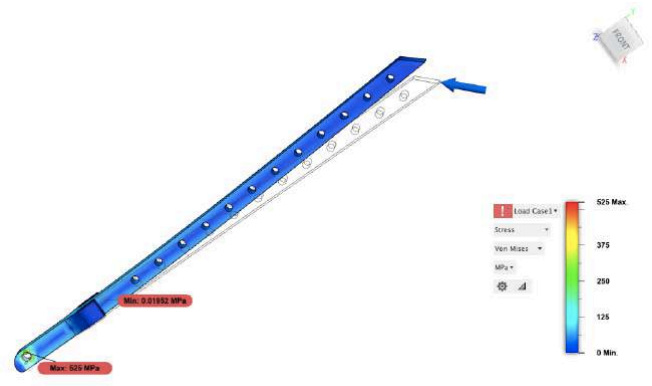
[picture p20: figure]

Figure 25: Landing Leg Strut von Mises Stress

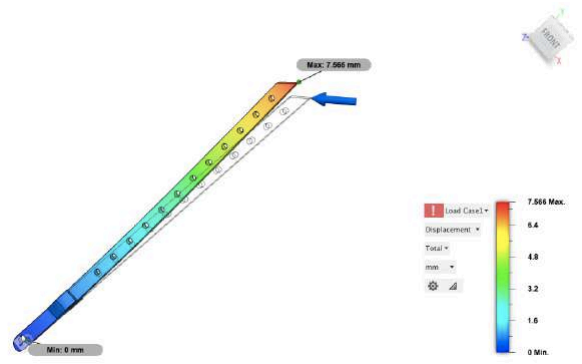
[picture p21: figure]

Figure 26: Landing Leg Strut Displacement

Department of Mechanical Engineering | 23 | Dayananda Sagar College of Engineering

Sl. No. | Parameters | Values
1 | Applied Force | 50N
2 | Maximum Stress | 525MPa
3 | Minimum Stress | 0.019MPa
4 | Maximum Displacement | 7.566mm
5 | Minimum Displacement | 0mm
6 | Mesh Size | 1mm

Table 17: Landing Leg Strut Structural Analysis Results

### 4.5.6 Bulkhead Structural Analysis

The bulkhead analysis was conducted to make sure that PLA material could withstand the forces due to impact from

landing. The bulkhead is also used a firewall as it is placed right above the propulsion and the TVC system. An

uniformly distributed force of 10N is applied to the circumference of the bulkhead. The results from the analysis

are tabulated below.

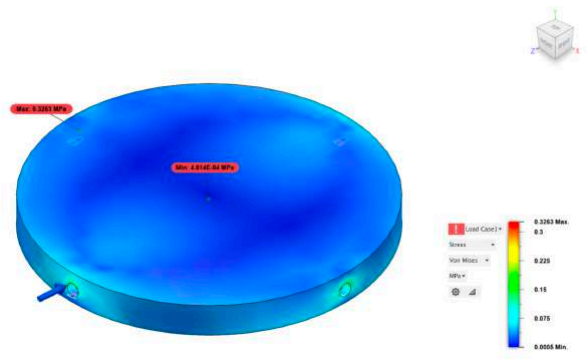
[picture p22: figure]

Figure 27: Bulkhead von Mises Stress

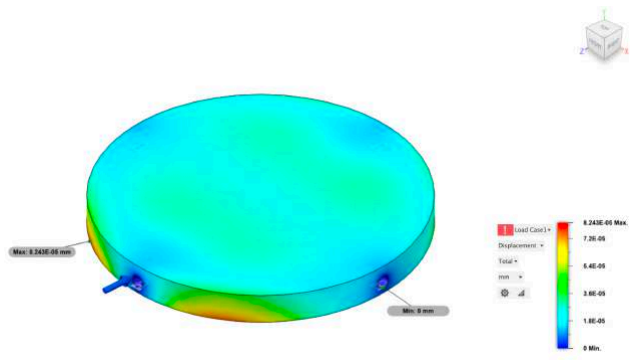
[picture p23: figure]

Figure 28: Bulkhead Displacement

Department of Mechanical Engineering | 24 | Dayananda Sagar College of Engineering

Sl. No. | Parameters | Values
1 | Applied Force | 10N
2 | Maximum Stress | 0.326MPa
3 | Minimum Stress | 4.81e-07MPa
4 | Maximum Displacement | 8.24e-05mm
5 | Minimum Displacement | 0mm
6 | Mesh Size | 1mm

Table 18: Bulkhead Structural Analysis Results

## 5 Propulsion

### 5.1 Methodology

The propulsion system was decided upon conducting trade study analysis and solid propellant was chosen. The

primary purpose of propulsion system with respect to our project objectives is to reduce the velocity and

acceleration during descent phase of the rocket, especially the velocity of the rocket right before touch down

should be decreased to almost zero. To achieve this, the team decided to look through numerous classes of solid

propellent and we chose class F motor i.e., F-15. This was decided after running various simulations on

OpenRocket and Simulink to test if the average thrust, maximum thrust and the burn time is sufficient to reach

the almost zero velocity at touch down. This is required for a successful and smooth landing without tipping

over. Further, the propellant’s thrust curve is studied and analyzed to understand its characteristics, and this is

imperative to figure out the altitude for reigniting the motor.

### 5.1.1 Solid Rocket Motor Specifications

The solid rocket motors were compared on Estes and on National Rocketry Association website and the

specification are tabulated below [4].

Department of Mechanical Engineering | 25 | Dayananda Sagar College of Engineering

Sl. No. | Parameters | Values
1 | Length | 114mm
2 | Diameter | 29mm
3 | Estimated Weight | 101.8g
4 | Total Impulse | 46.61N
5 | Time Delay | 4 seconds
6 | Maximum Thrust | 25.26N
7 | Average Thrust | 14.5N
8 | Initial Thrust | 14.3N
9 | Thrust Duration | 3.45 seconds
10 | Initial Weight | 101.5g
11 | Propellant Weight | 60g
12 | Burn Time | 3.5 seconds
13 | Propellant | Black Powder
14 | Manufacturer | Estes Industries

Table 19: F-15 Motor Specications

### 5.1.2 Motor Performance Analysis

The solid rocket motors were compared on Estes and on National Rocketry Association website and the thrust

curve of the chosen motor and its simulation on OpenRocket is shown below [5].

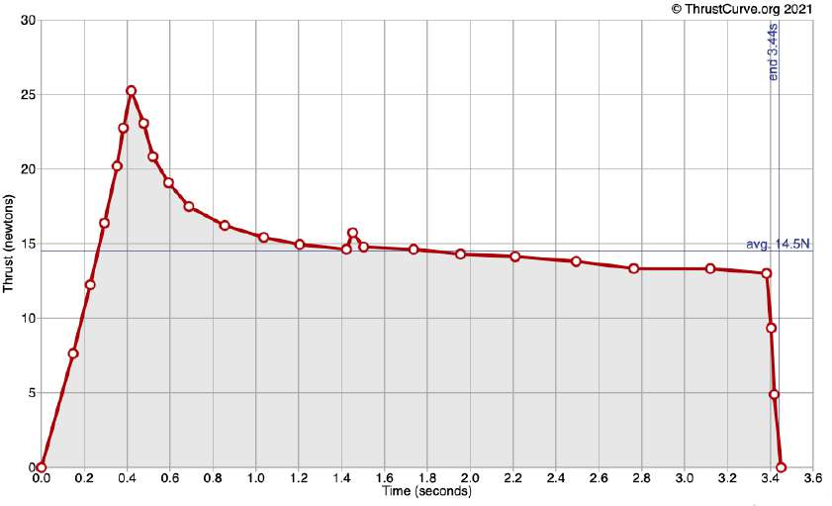
[picture p24: figure]

Figure 29: F-15 Motor Thrust Curve

Department of Mechanical Engineering | 26 | Dayananda Sagar College of Engineering

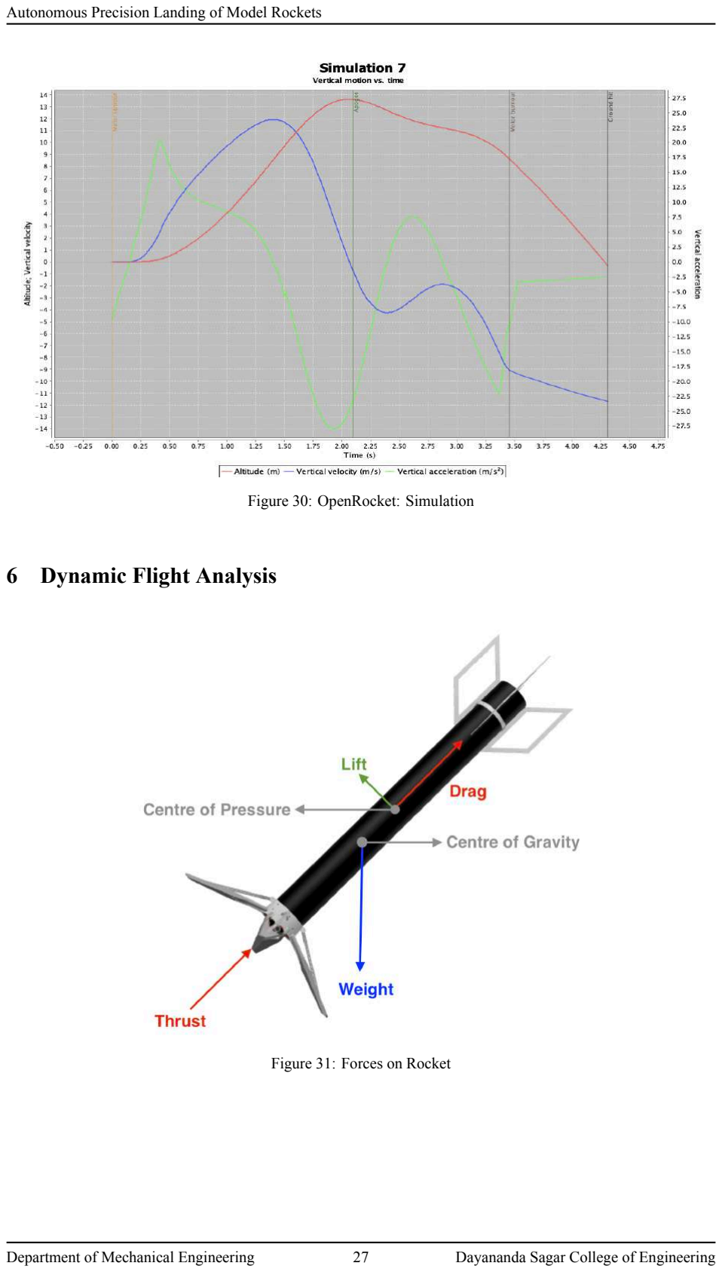
[picture p25: page 41]

Figure 30: OpenRocket: Simulation

## 6 Dynamic Flight Analysis

Figure 31: Forces on Rocket

Department of Mechanical Engineering | 27 | Dayananda Sagar College of Engineering

### 6.1 Stability Characteristics

The stability characteristics of the rocket is determined mainly by the location of centre of gravity and centre of

pressure. The location of the centre of gravity of the rocket is governed by the weight and the arm length of each

and every component that the rocket houses. The location of the centre of pressure of the rocket is dictated by the

each component’s reference area and the location the component from a reference line, here the reference line is

assumed to be the end of thrust vector control system. The location of the centre of gravity of the rocket is evaluated

by both analytical and through the help of CAD modelling using Autodesk Fusion 360 software. The location of

the centre of pressure of the rocket is estimated by both analytical and through the help of an open source software

known an OpenRocket. Since we are dealing with model rockets, the team decided to use approximated equation

for determining the centre of pressure for analytical calculation which considered landing legs whilst with the

software the landing legs area could not accurately represented due limitations of the software. The table below

provides a detailed breakdown of individual component weight and its respective arm length. The equations used

for determining the centre of gravity and centre of pressure are mentioned below [6][7].

cgW = dnwn + drwr + dbwb + dewe + dfwf | (1)
cpA = dnan + dbab + df af | (2)
Component | Weight (in grams) | Arm Length (in metres)
Airframe | 370 | 0.381
Fins | 55.6 | 0.735
Landing Legs | 214.5 | 0.115
Propulsion | 50 | 0.038
Thrust Vector Control | 52.5 | 0.038
Flight Computer | 100 | 0.723
X_CG | 842.6 | 0.297

Table 20: Moment Table

Department of Mechanical Engineering | 28 | Dayananda Sagar College of Engineering

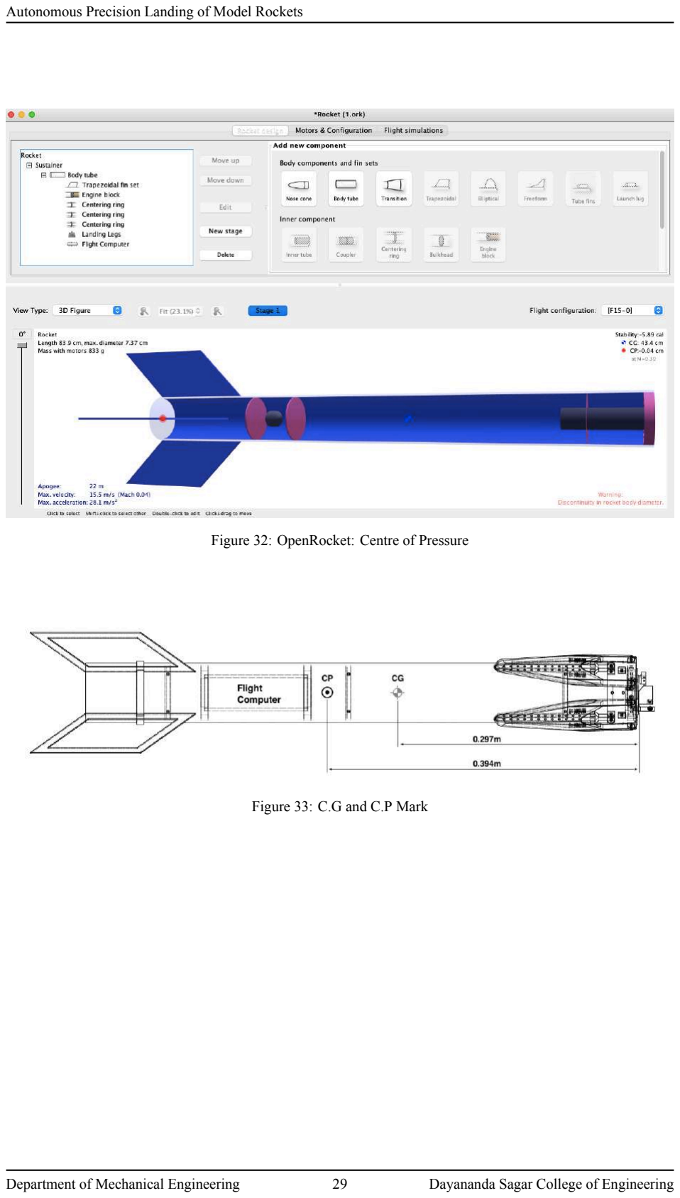
[picture p26: page 43]

Figure 32: OpenRocket: Centre of Pressure

Figure 33: C.G and C.P Mark

Department of Mechanical Engineering | 29 | Dayananda Sagar College of Engineering

### 6.2 Dynamic Analysis

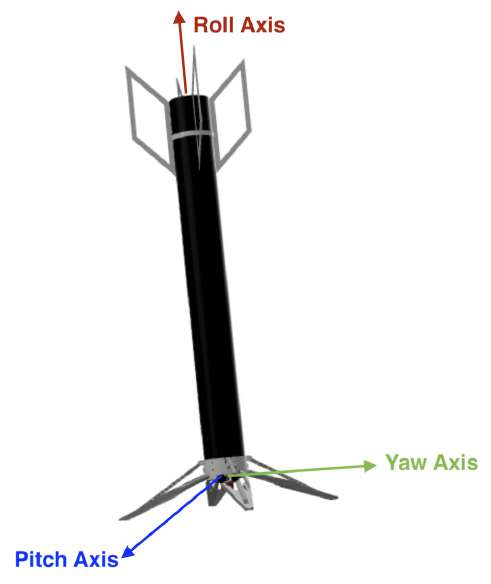
[picture p27: figure]

Figure 34: Rocket Axis Orientation

### 6.2.1 Corrective Moment Coefficient

Corrective moment coefficient is used to determine the corrective force that the rocket creates in response to a

disturbance in flight. The larger the value, the more force the rocket creates and the quicker it will react to a

disturbance. The corrective moment coefficient is used to determine how quickly and with how much force the

rocket reacts to a disturbance in flight. A high corrective moment coefficient value means that the rocket will

produce forces to counter the disturbing force, such as a gust of wind [1][8]. The team’s main objective being to

land the rocket vertically, making sure that the rocket maintains vertical orientation at all times is salient. The value

of corrective moment coefficient depends on the area of fin, stability margin and velocity. Hence, we decided to

maximize the fin area and stability margin. The value for normal force coefficient is obtained from the open source

software called OpenRocket. The equation used to determine the corrective moment coefficient is mentioned below

[9].

C1 = 1
2
ρv²ArCNα[CG − CP] | (3)

where,

C1 Corrective Moment Coefficient

Ar Reference area (maximum frontal area)

CNα Normal Force Coefficient

Department of Mechanical Engineering | 30 | Dayananda Sagar College of Engineering

### 6.2.2 Damping Moment Coefficient

The damping moment coefficient is what determines how far the rocket will be deflected, and how fast the

oscillations die down to zero. The damping moment coefficient is made up of two components, one of which is

aerodynamic in origin, and the other is propulsive. They are simply added together to get the total damping

moment coefficient. The propulsive damping moment coefficient is the gases coming out of the nozzle seem to

make the whole rocket harder to turn. This is similar to increasing the moment of inertia of the rocket. Each

external component of the rocket such as fins, landing legs and airframe add to the overall damping of the rocket.

And like the moment of inertia and corrective moment coefficient, the location of each of these parts in relation

to the CG affects their values. But when compared to the aerodynamic damping moment coefficient the

propulsive damping moment coefficient is relatively insignificant especially when it comes to scaleddown

rockets. The equation used to determine the damping moment coefficient is mentioned below [1][10].

C2 = C2A + C2R | (4)

where,

C2 = Damping Moment Coefficient

A2A = Aerodynamic Damping Moment Coefficient

C2R = Propulsive Damping Moment Coefficient

C2R = m˙ [Lne − CG]

2 | (5)

where,

C2 = Propulsive Damping Moment Coefficient

m˙ = rate of mass expulsion from the nozzle, grams/second

Lne = Distance the nozzle is from the tip of the nose cone

C2 A = ρVAr
2

!"
CNαcomponent [CPcomponent − CG]

2

(6)

where,

C2A = Aerodynamic Damping Moment Coefficient

Ar = Reference Area

CNα(component) = Normal Force coefficient of the individual component

CPcomponent = Distance from the nose tip to the CP of the component

Department of Mechanical Engineering | 31 | Dayananda Sagar College of Engineering

### 6.2.3 Damping Ratio

The damping ratio is a dimensionless number, and it is independent of the speed of the rocket. The damping

ratio is computed after we have found the longitudinal moment of inertia, corrective moment coefficient, and the

damping moment coefficient. The system is found to be underdamped as desired. Since the damping ratio is less

than i.e., underdamped the rocket oscillates back and forth and the frequency of the vibration dies out slowly. The

parameters that affects the damping ratio are fin area, moving the fin away from centre of gravity, sweep aft fins,

the rocket’s weight and length. The equation used to determine the damping ratio is mentioned below [1][11].

ζ = C2
2
| √C1lL

(7)

where,

C1 = Corrective Moment Coefficient

C2 = Damping Moment Coefficient

IL = Longitudinal Moment of Inertia

IR = Radial Moment of Inertia

ω = Natural Frequency

ζ = Damping Ratio

Sl. No. | Parameters | Values
1 | Centre of Gravity | 0.297m
2 | Centre of Pressure | 0.394m
3 | Static Margin | 1.27
4 | Normal Force Coefficient | 10.3
5 | Corrective Moment Coefficient | 0.145
6 | Damping Moment Coefficient | 9.87 x 10⁴
6 | Damping Ratio | 0.004
7 | Natural Frequency | 1.288 Hz
8 | Longitudinal Moment of Inertia | 0.09 kgm²

Table 21: Flight Dynamics Parameters

### 6.3 Aerodynamic Drag Analysis

Aerodynamic modelling and analysis is imperative to understand the effects on the dynamics of the rocket. The

team approached the aerodynamics analysis in an unconventional manner, instead of optimizing the design for

reducing the drag force, we focused on increasing the drag force whilst keeping weight and other parameters in

check. The figure below represents the different types of drag on the rocket including body drag, tail drag, fin drag

Department of Mechanical Engineering | 32 | Dayananda Sagar College of Engineering

and base drag. The pressure drag generated by the body is almost nonexistent, nevertheless the team evaluated its

value. The total drag coefficient is the sum of base drag coefficient and pressure drag coefficient [12].

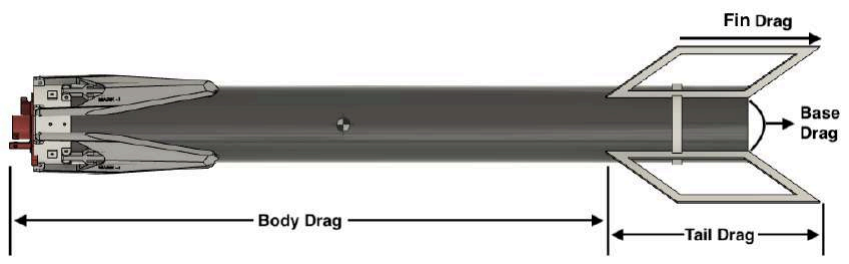
[picture p28: figure]

Figure 35: Aerodynamic Drag Representation

Figure 36 shows the variation of incompressible skin friction drag coefficient with respect to velocity. The

value of incompressible skin friction drag coefficient is primarily dependent on the Reynolds number. The

maximum value of incompressible skin friction drag coefficient is when velocity is zero, as shown in the graph.

Figure 37 shows the variation in compressible skin friction drag coefficient with respect to velocity. The value of

compressible skin friction drag coefficient is contingent on both incompressible skin friction drag coefficient and

mach number and its value is maximum when velocity is zero, as shown in the graph.

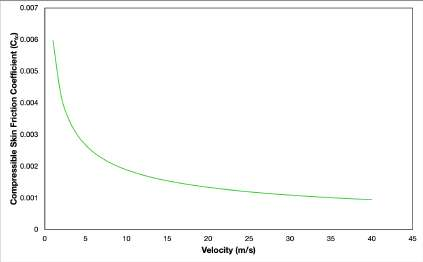
[picture p29: figure]
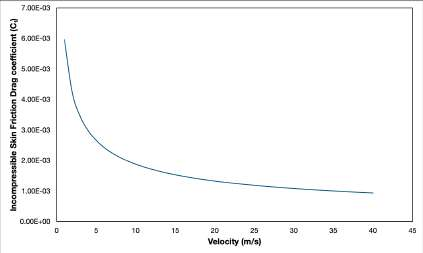
[picture p30: figure]

Figure 36: Cf Vs Velocity | Figure 37: Cfc Vs Velocity

Figure 38 shows the variation of tail leading edge drag coefficient with respect to velocity. The value of tail

leading edge drag coefficient is primarily dependent on the reference area of the fin and the number of fins, and its

maximum value is when velocity is maximum, as shown in the graph. Figure 39 shows the variation of tail trailing

edge drag coefficient with respect to velocity. The value of tail trailing edge drag coefficient is primarily dependent

on the reference area of the fin and the number of fins, and its maximum value is when velocity is maximum, as

shown in the graph.

Department of Mechanical Engineering | 33 | Dayananda Sagar College of Engineering

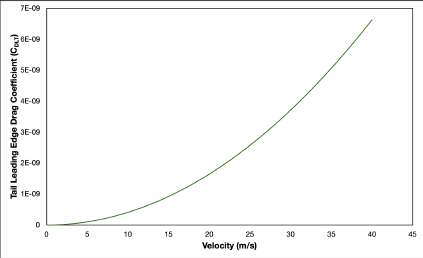
[picture p31: figure]
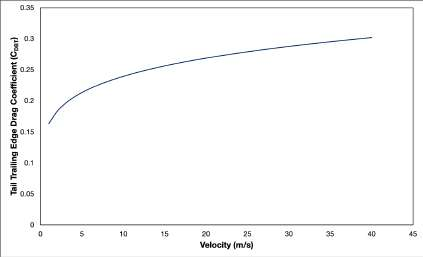
[picture p32: figure]

Figure 38: CDLT Vs Velocity | Figure 39: CDBT Vs Velocity

Figure 40 shows the variation of tail skin friction drag coefficient with respect to velocity. The value of tail

skin friction drag coefficient is primarily dependent on the reference area of the fin and the number of fins, and its

maximum value is when velocity is zero, as shown in the graph. Figure 41 shows the variation in tail thickness

drag coefficient with respect to velocity. The value of tail thickness drag coefficient is primarily dependent on the

reference area of the fin and the number of fins. In our passive fins design, the thickness is considerably low and

the its contribution to overall drag is relatively less.

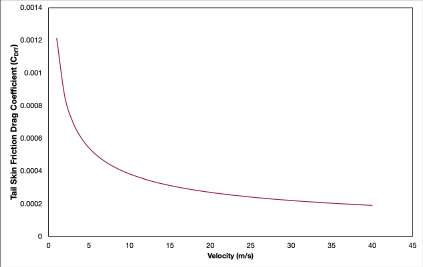
[picture p33: figure]
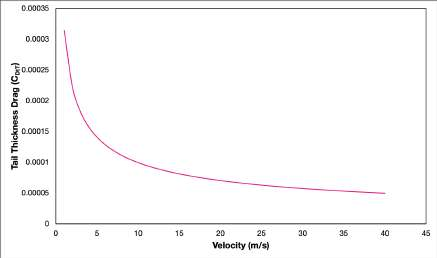
[picture p34: figure]

Figure 40: CDfT Vs Velocity | Figure 41: CDt T Vs Velocity

In Figure 42 the variation in tail drag coefficient with respect to velocity is observed. The value of tail drag

coefficient is contingent on the above component drag i.e., leading edge, trailing edge and thickness of tail, and its

value is maximum when velocity is maximum, as shown in the graph.

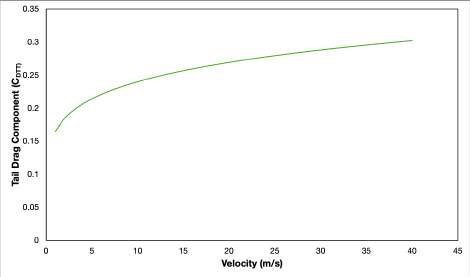
[picture p35: figure]

Figure 42: CDTT Vs Velocity

Figure 43 shows the variation of body

pressure drag coefficient with respect to

velocity. The value of body pressure

drag coefficient is primarily dependent on

the total wetted area and its maximum

value is when velocity is zero, as shown

in the graph. Figure 44 shows the

variation in body base drag coefficient

with respect to velocity. The value of

body base drag coefficient is contingent

on both incompressible skin friction drag

Department of Mechanical Engineering | 34 | Dayananda Sagar College of Engineering

coefficient and mach number and its value is maximum when velocity is maximum, as shown in the graph. The

base drag component is significantly more than pressure drag component of the body.

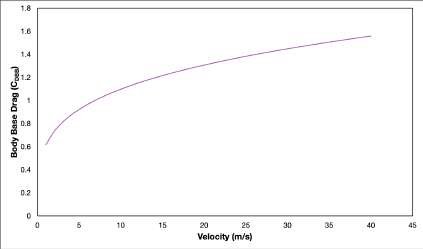
[picture p36: figure]
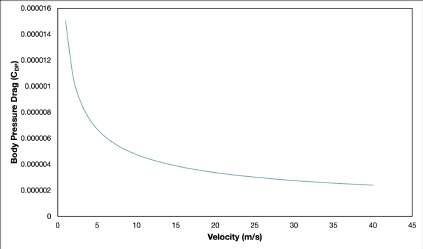
[picture p37: figure]

Figure 43: CDBP Vs Velocity | Figure 44: CDBB Vs Velocity

Figure 45 shows the variation of body incompressible skin friction drag coefficient with respect to velocity.

The value of body incompressible skin friction drag coefficient is primarily dependent on the ratio of fin root chord

to root fin trailing edge thickness and its maximum value is when velocity is zero, as shown in the graph. Figure 46

shows the variation in body component drag coefficient with respect to velocity. The value of body component

drag coefficient is contingent on both the pressure drag and base drag of the body and its value is maximum when

velocity is maximum, as shown in the graph.

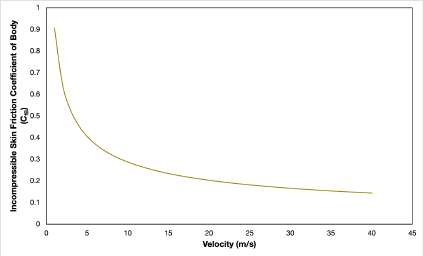
[picture p38: figure]
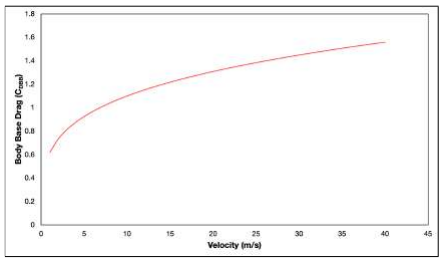
[picture p39: figure]

Figure 45: CfB Vs Velocity | Figure 46: CDTB Vs Velocity

Figure 47 shows the variation of drag coefficient with respect to velocity. The value of drag coefficient is the

sum of tail drag component and body drag component and its maximum value is when velocity is maximum i.e.,

1.86, as shown in the graph. Figure 48 shows the variation in drag coefficient with respect to Reynolds number.

The range of Reynolds number is 0 to 1.98 million during the descent phase of the rocket, the Reynolds number

progressively increases and then starts to decrease once the propellant is ignited.

Department of Mechanical Engineering | 35 | Dayananda Sagar College of Engineering

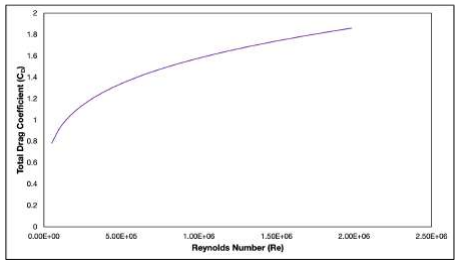
[picture p40: figure]
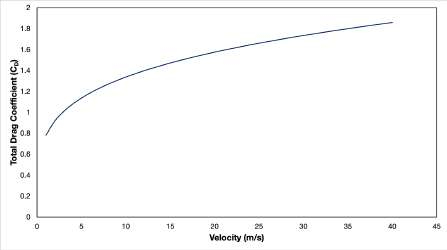
[picture p41: figure]

Figure 47: CD Vs Velocity | Figure 48: CD Vs Reynolds Number

Figure 49 shows the variation of component drag coefficient with respect to velocity. It is evident from the

graph below that the majority of drag is contributed from the body component of the rocket and followed by the

tail component. Figure 50 shows a pie chart of the distribution of the component drag.

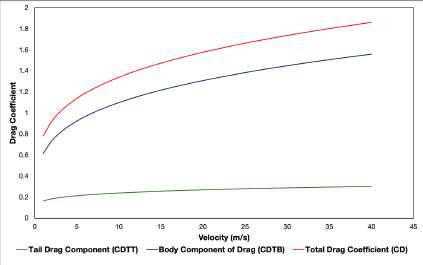
[picture p42: figure]
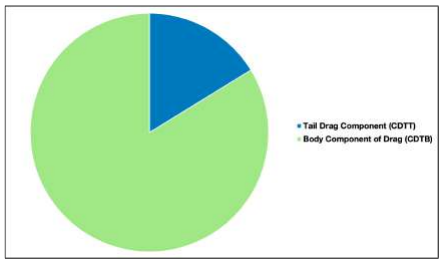
[picture p43: figure]

Figure 49: Component Drag Vs Velocity | Figure 50: Component Drag Distribution

The table below is a list of all the user inputs that is used for analytical evaluation of the aerodynamics of the

rocket body and the results from this drag analysis.

Department of Mechanical Engineering | 36 | Dayananda Sagar College of Engineering

Sl. No. | Parameters | Values
1 | Length | 0.762m
2 | Diameter | 0.076m
3 | Fin Span | 0.076m
4 | Fin Chord | 0.152m
5 | AT | 0.011m²
6 | Ar | 0.455m²
6 | AB | 0.011m²
7 | AWB | 0.191m²
8 | AW | 0.284m²
10 | Af | 0.023m²
11 | fB | 10
12 | c | 343ms-1
13 | M | 0.116
14 | N | 4
15 | AR | 0.011
16 | ρ | 1.204kgm³
17 | µ | 1.85e-05kgm-1s-1
18 | CG | 0.297m
19 | CP | 0.394m
20 | B | 0.997
21 | ΓL | 0.785
22 | cr | 0.152
23 | tr | 0.002
24 | hr | 0.002
25 | rL | 2.89e-05
26 | K1 | 11.69
27 | Kp | 1.001
28 | K2 | 4.391

Table 22: Input Parameters for Drag Analysis

Department of Mechanical Engineering | 37 | Dayananda Sagar College of Engineering

Sl. No. | Parameters | Values at 40ms-1
1 | Cf | 9.43e-04
2 | Cfc | 9.41e-04
3 | CDLT | 6.62e-09
4 | CDBT | 0.301
5 | CDfT | 1.91e-04
6 | CDt
| T | 4.95e-05
6 | CDTT | 0.302
7 | CDBP | 2.39e-06
8 | CDBB | 1.558
9 | CfB | 0.143
10 | CDTB | 1.559
11 | CD | 1.86
12 | Reynolds Number | 1.98e+6

Table 23: Drag Analysis Results

### 6.4 Computational Fluid Dynamic Analysis

Computational fluid dynamic analysis was executed on a open source software, OpenFOAM (Open Field Operation

and Manipulation). The team chose to use this software because of high degree of freedom, versatility and complete

control over the source code including but not limited to governing equations, solver and several utilities. This

software also uses finite volume method (FVM) instead of finite element method (FEM). A motorBike tutorial

from the OpenFOAM website was used as reference [13]. BlockMesh is used for defining the domain around the

airframe model. Since this is a 3D model, snappyHexMesh was used for meshing. The preprocessing part of this

includes:

- blockMesh
- snappyHexMesh
- OpenFOAM Utilities

Some of the solvers are:

- Incompressible
- Compressible
- Multiphase
- laplacianFoam
Department of Mechanical Engineering | 38 | Dayananda Sagar College of Engineering

- potentialFoam

Solvers for incompressible flow are:

- icoFOAM
- simpleFoam
- pisoFoam

The team performed a turbulent flow analysis to obtain the pressure field and velocity field of the rocket. To

run this analysis, we used Reynolds-Averaged Navier Stokes (RANS) turbulent model instead of Large Eddy

Simulation (LES) or Direct Numerical Simulation (DNS) as both of these were computationally expensive. We

used the simpleFoam solver as our analysis includes turbulent flow study. Apart from this potentialFoam solver

was used to approximate for irrotational flows. Finally the results are viewed on paraFoam.

The steps for analysis that are entered in the terminal are:

- cd $FOAM_RUN
- cd AirFrame
- blockMesh
- surfaceFeatures
- snappyHexMesh overwrite
- potentialFoam
- simpleFoam
- paraFoam
Department of Mechanical Engineering | 39 | Dayananda Sagar College of Engineering

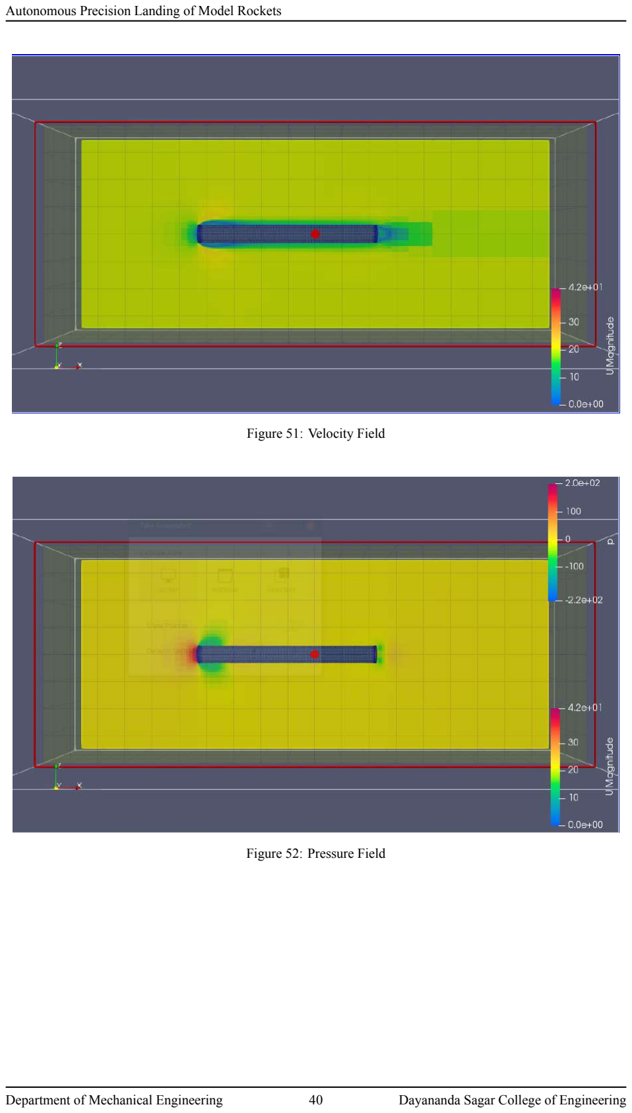
[picture p44: page 54]

Figure 51: Velocity Field

Figure 52: Pressure Field

Department of Mechanical Engineering | 40 | Dayananda Sagar College of Engineering

## 7 Thrust Vector Control

### 7.1 Thrust Vectoring

Thrust Vectoring or Thrust Vector Control (TVC) can be defined as the ability of vehicles such as rockets and

aircrafts to manipulate the direction of thrust from its motor or engine to control attitude or angular velocity. This

can be seen in rockets and ballistic missiles which achieve thrust vectoring through four basic means:

- Gimbaled Engine(s) or Nozzle(s)
- Propellant Injection
- Vernier Thrusters
- Exhaust Vanes

### 7.1.1 Gimbaled Thrust Vectoring

Gimbaled Thrust Vectoring allows for movement in two directions or axes, namely the pitch and yaw axes, thus

ensuring adequate attitude and angular velocity control. Figure 53 shows the working of this concept. The angle

between the rocket center line and the thrust line is called gimbal angle. In the first case, the thrust line and center

of gravity (CG) are aligned and we arrive at a straight line or normal configuration, with the gimbal angle being

zero. In the second case, the nozzle is titled towards the left, making a gimbal angle a with respect to the rocket

center line. As a result of this, a torque is generated about the CG which causes the rocket nose to tilt towards the

left. Lastly, when the rocket nozzle moves right, the rocket nose tilts right due to the generation of torque about

the CG.

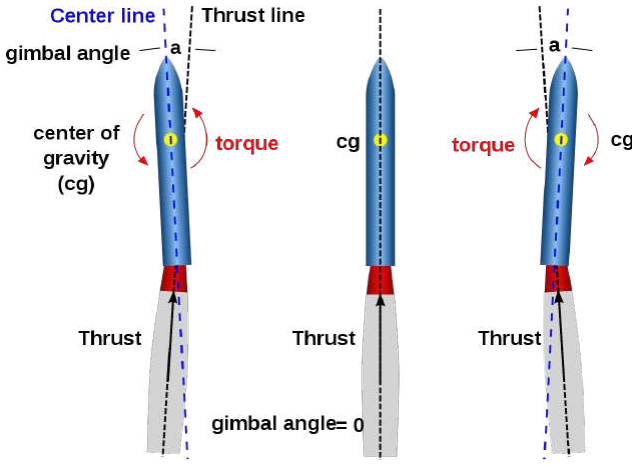
[picture p45: figure]

Figure 53: Gimbaled TVC
[14]
Department of Mechanical Engineering | 41 | Dayananda Sagar College of Engineering

### 7.2 Thrust Vector Control Design

The main objective of the TVC for the model rocket is to achieve accurate movement in the pitch and yaw axes.

After selecting the motor and airframe diameters which are 22mm and 76.2mm respectively, two TVC designs

were developed. These designs consist of three main parts namely:

- Motor Mount
- Inner Gimbal
- Outer Gimbal

To enable movement in the pitch and yaw directions, the designs incorporate the usage of servos. Both the

designs are connected to SG92r servos to check for accuracy and response in movement.

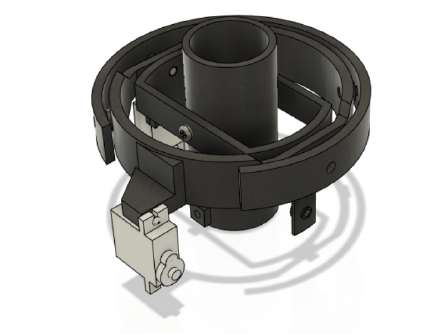
[picture p46: figure]

Figure 54: Design I

Design I [Figure 54] is a four part assembly as opposed to Design II [Figure 55] which is a three part assembly.

The only difference between the two designs is that Design I has an outer holder which serves as an attachment to

the rocket airframe.

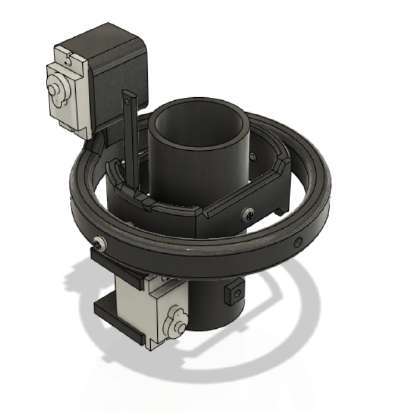
[picture p47: figure]

Figure 55: Design II

Department of Mechanical Engineering | 42 | Dayananda Sagar College of Engineering

### 7.3 TVC Dimensions

### 7.3.1 Design I:

Sl. No. | Part | Inner Diameter (mm) | Outer Diameter (mm)
1 | Motor Mount | 22.5 | 28
2 | Inner Gimbal | 45 | 50
3 | Outer Gimbal | 54 | 60
4 | Holder | 67 | 73

Table 24: Design I Specifications

### 7.3.2 Design II:

Sl. No. | Part | Inner Diameter (mm) | Outer Diameter (mm)
1 | Motor Mount | 22.5 | 28
2 | Inner Gimbal | 45 | 52
3 | Outer Gimbal | 61 | 73

Table 25: Design II Specifications

Both designs make use of M3 screws. Platforms to accommodate the servos were designed after thorough

measurement of the SG92r servos. The servo arms with the push rods are to be aligned with the linkage stoppers

present in the motor mount and inner gimbal. This will allow smooth gimbal movement and the design is made

accordingly.

## 8 Dynamics

Dynamics is a subdivision of mechanics dealing with the motion of materials or objects in time, in relation to the

physical factors that affect this motion like force, momentum, mass, and energy. Dynamics is further subdivided

into kinematics, where motion is considered (with respect to position, velocity and acceleration) without regard to

its causes, and kinetics which deals with the effects of forces and torques on the motion of a moving body.

Before we delve into the dynamics behind the working of a model rocket, we will first introduce the concepts of

scalar and vector products.

### 8.1 Scalar Products

Also known as dot product, it gives the length of projection of vector !a, onto another vector !b, multiplied by the

length of !b, as shown in Figure 56.

Department of Mechanical Engineering | 43 | Dayananda Sagar College of Engineering

!a ·!b = |!a|·|!b| cos θ | (8)

Where, θ is the angle between the two vectors !a and !b .

### 8.1.1 Inner Products Properties

!a ·!b = !b · !a | (9)

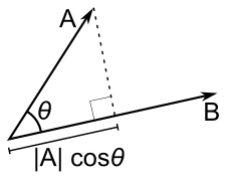
[picture p48: figure]

Figure 56: Inner Product

!c(!a +!b)=(!c · !a)+(!c ·!b) | (10)

From equations 9 and 10, we can conclude that scalar products and both commutative and distributive

respectively.

### 8.2 Vector Products

A cross product or vector product is a mathematical operation in which two vectors belonging to a three dimensional

space yields a new vector in a direction perpendicular to both the vectors. This is illustrated in Figure 57.

!a ×!b = |!a$!b|sin θ · nˆ | (11)

Here, the new vector formed as a result of the cross product between !a and !b is along the direction of nˆ.

!a = a1

î + a2ĵ + a3ˆ
k
!b = b1

î + b2ĵ + b3ˆ
k

î, ĵ, ˆ
k, are unit vectors in the x, y,z directions respectively.

### 8.2.1 Cross Product Properties

Vector products are anticommutative:

!b × !a = −!a ×!b | (12)
Department of Mechanical Engineering | 44 | Dayananda Sagar College of Engineering

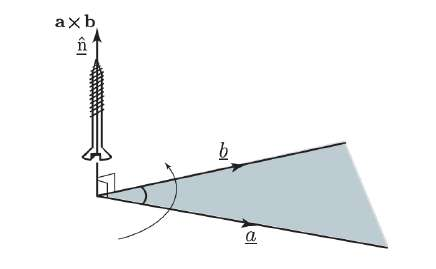
[picture p49: figure]

Figure 57: Vector Product
[15]

They are distributive over addition:

!a × (!b + !c)= !a ×!b + !a × !c | (13)

Two vectors in the same direction give a cross product of zero:

!a ×!b = !0 | (14)

Additional properties:

!a · (!b × !c)= !b(!c × !a)= !c(!a ×!b) | (15)
!a × (!b × !c)= !b(!c · !a) − !c(!a ·!b) | (16)

### 8.3 Expressing Vectors In Different Frames

Vectors can be oriented differently when seen from different perspectives. Let us consider a reference frame (Fr), which consists of P! . This P! can be expressed in terms of Fr by using !a, !b and !c along the xˆ, yˆ, zˆ directions

respectively. !a, !b and !c have magnitudes of α, β and γ respectively.

Notation: P! r, when P! is expressed in Fr.

P! r = !ar +!br + !cr | (17)

!ar =

α

0

0

!br =

0

β

0

Department of Mechanical Engineering | 45 | Dayananda Sagar College of Engineering

!cr =

0

0

γ

Therefore,

P! r =

α

β

γ

(18)

Let Fr be rotated through an angle of ψ along the z axis, such that a new frame (F1) is produced as shown in the figure below. The objective now is to express P! in F1.

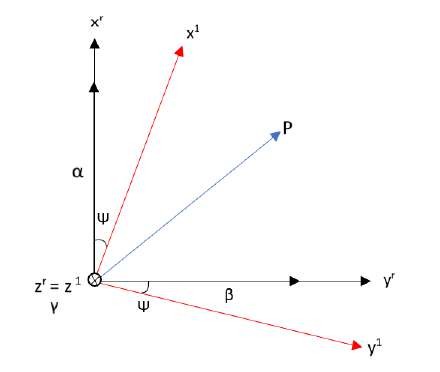
[picture p50: figure]

Figure 58: P! being expressed in Fr and F1

Notation: P! 1, where 1 is used to denote F1.

P! ¹ = !a¹ +!b¹ + !c¹ | (19)

!a1 =

α cos ψ

−α sin ψ

0

!b¹ =

β sin ψ

β cos ψ

0

!cr =

0

0

γ

Department of Mechanical Engineering | 46 | Dayananda Sagar College of Engineering

Therefore,

P! ¹ =

cos ψ sin ψ 0

− sin ψ cos ψ 0

0 | 0 | 0

α

β

γ

From equation 18,

P! ¹ =

cos ψ sin ψ 0

− sin ψ cos ψ 0

0 | 0 | 0

*
P! r

+
(20)
P! ¹ = C1/r.P! r | (21)

C1/r is the rotation/representation of P! from Fr to F1, which is called Direction Cosine Matrix (DCM).

### 8.3.1 Properties of Direction Cosine Matrix

- Orthogonal:

CT

1/r = C−1
1/r = Cr/1 | (22)
- Eigenvalues of a DCM is always 1 (λ = 1). This is because there is only rotation of the vector and no scaling

(stretching or shrinking).

### 8.4 Rodrigues’ Rotation Formula

Let us consider vector v which is rotated about a unit vector r by some angle α. Here, α is a left handed rotation.

The new vector formed is v¯. This can be seen in the figure below. The main goal is to relate v¯ as a function of v,

r, α.

v¯ = (1 − cos α)%v × r&r + cos α(v) − sin α(r × v) | (23)

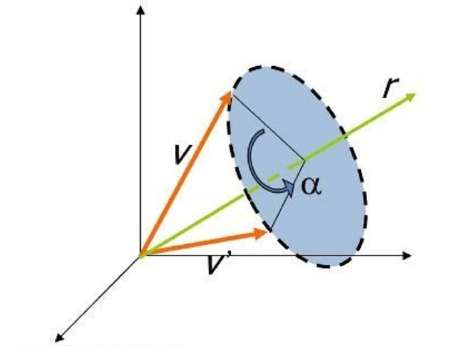
[picture p51: figure]

Figure 59: Rodrigues’ Rotation

Department of Mechanical Engineering | 47 | Dayananda Sagar College of Engineering

### 8.5 Euler Angles

Euler angles were developed first by the Swiss mathematician Leaonhard Euler, which describes the orientation

of a particular rigid body with that of a fixed coordinate system, which is also commonly known as the earth or

inertial reference frame. Euler angles are used intensively in the domains of aeronautics and engineering.

Euler angles make use of three angles which can be used to completely define the orientation of a body frame

with respect to an inertial frame. Euler angles are not unique i.e. there can be more than one sequence of Euler

angles that can be used to define an orientation. The objective is to arrive from a vehicle carried inertial frame

also called North-East-Down (NED) frame to the vehicle carried body frame.

FNED: North East Down frame or Inertial frame.

Fb: Vehicle carried body frame.

To achieve this, an Euler rotational sequence is carried out in the following specific order:

- Right hand rotation about the zv axis (also the z1 axis) through an angle ψ, Yaw Angle. (Rotation from

FNED or Fv to F1 shown in Figure 60).

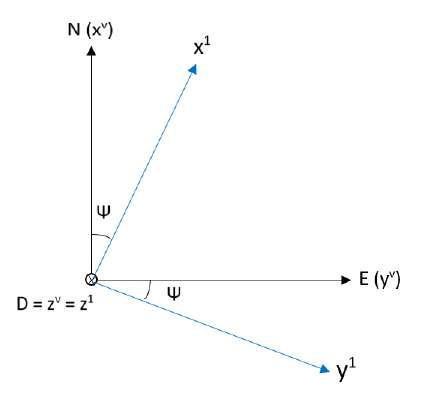
[picture p52: figure]

Figure 60: Fv to F1

- Right hand rotation about the y1 axis (also the y2 axis) through an angle θ, Pitch Angle. (Rotation from F1

to F2 shown in Figure 61)

- Right hand rotation about the x2 axis (also the xb axis) through an angle φ, Roll Angle. (Rotation from F2

to Fb shown in Figure 62)

In terms of rotational matrices:

Let us consider two frames namely, FNED / Fv and Fb. Assume that there exists a vector !u in Fv (which will be

denoted as !uv). We will now try to express this vector in the NED frame to the body frame.

This can be performed in the following three steps:

Department of Mechanical Engineering | 48 | Dayananda Sagar College of Engineering

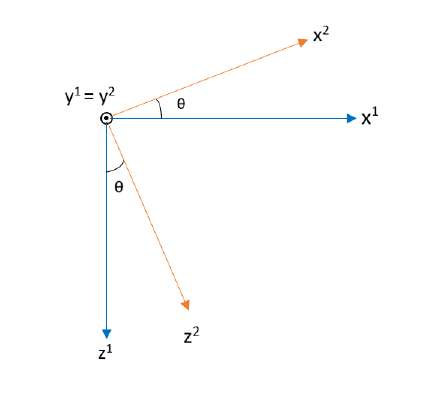
[picture p53: figure]

Figure 61: F1 to F2

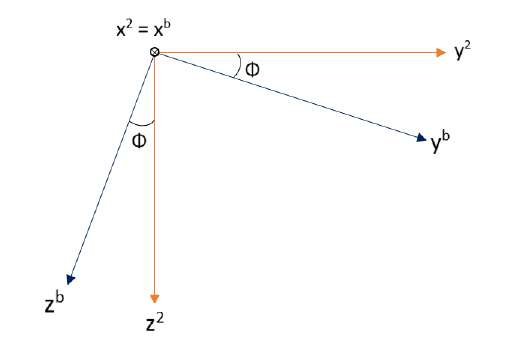
[picture p54: figure]

Figure 62: F2 to Fb

- Step 1
!u¹ = c1/v(ψ)!uv | (24)

C1/v =

cos ψ sin ψ 0

− sin ψ cos ψ 0

0 | 0 | 1

This shows the rotation of FNED or Fv about the Z-axis through an angle of ψ, resulting in a new frame F1.

- Step 2
!u² = c2/1(θ)!u¹ | (25)

C2/1 =

cos θ 0 − sin θ

0 | 1 | 0
sin θ 0 | cos θ
Department of Mechanical Engineering | 49 | Dayananda Sagar College of Engineering

This allows the rotation of F1 about the Y-axis through an angle of θ, resulting in a new frame F2.

- Step 3
!ub = cb/2(φ)!u² | (26)

C1/v =

1 | 0 | 0
0 | cos φ | sin φ

0 − sin φ cos φ

This allows the rotation of F2 about the X-axis through an angle of φ, hence arriving at the desired frame

Fb.

Adding equations (24 + 25 + 26), we arrive at:

!ub = Cb/2(φ) · c2/1(θ) · c1/v(ψ) · !uv

!ub = Cb/v(φ, θ, ψ) · !uv | (27)

Where,

Cb/v(φ, θ, ψ)= DCM =

cθ · cψ | cθ · sψ | −sθ
cψ · sθ − cφ · sψ | cφ · cψ + sθ · sφ · sψ | cθ · sφ

cφ · cψ · sθ + sφ · sψ −cψ · sφ + cφ · sθ · sψ cθ · cφ

(28)

where c Cosine, s Sine.

NOTE:

- Order of this rotation is important, starting with the rotation about Z axis then Y axis and then the X axis.
- The typical reference order or data order while mentioning Euler angles is along the lines of φ, θ, ψ (X Y

Z).

- Cb/v(φ, θ, ψ) is a Direction Cosine Matrix (DCM), and is not unique.
- Cb/v(φ, θ, ψ) when analysed for Eigenvalues, always has one row having unity as its element, implying that

only rotation is taking place on the considered vector !u (No stretching or shrinking).

Important: Recalling the concepts of Rodrigues’ Rotation and equation 23 and assuming that v = r, we shall

arrive at v¯ = v. This implies that any vector which is aligned with its axis of rotation does not change and will

possess an eigenvalue of unity.

From the eigenvector equation,

A · !x = λ · !x | (29)

Where, !x and λ is the eigenvector and eigenvalue respectively.

Department of Mechanical Engineering | 50 | Dayananda Sagar College of Engineering

This has an implication on Euler angles. When the DCM is multiplied with its eigenvector, it equals the same

eigenvector (as λ = 1). This goes to say that when the eigenvector is rotated through the DCM, it remains the same,

making it the axis of rotation.

Therefore, !x is the axis of rotation for the entire Euler sequence. So, instead of using three separate rotations

to arrive at !ub, we can arrive at !ub by a single rotation about !x. Here, !x is the eigenvector (of Cb/v(φ, θ, ψ))

corresponding to unity eigenvalue.

### 8.6 Euler Kinematical Equations

A rate gyro is used to measure the rate of angular movement which indicates the change of an angle with time,

instead of indicating direction. They are used in Inertial Measurement Units (IMUs) to measure angular change.

Let us consider the body frame of the rocket to rotate about an axis which can be called the angular velocity

vector (ω). This can be expressed as !ωb/v.

!ωb/v =

p

q

r

=

Roll rate

Pitch rate

Yaw rate

(30)

These inputs from the rate gyros are required to determine the Euler angles. A specific function which relates

the data from the IMU has to be converted into the three Euler angles.

NOTE:

- The rates of the Euler angles

φ˙

˙
θ
ψ˙

are not equal to

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
(31)

Therefore, a function which maps the inputs from the IMU to the three Euler angles has to be specified. This

entire system that takes in inputs from the IMU and maps it to the three Euler angles (this sytem also includes an

integrator) is called an Attitude Heading Reference System (AHRS).

### 8.6.1 Properties of Angular Velocity Vector ( !ωb/v):

- !ωb/v is s unique vector that relates the derivatives of a vector taken in two frames.
- Additive in nature:
!ωc/a = !ωa/b + !ωb/c | (32)
Department of Mechanical Engineering | 51 | Dayananda Sagar College of Engineering

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

φ˙

˙
θ
ψ˙

=

1 | sφtθ | cφtθ
0 | cφ | −sφ

0 sec θ · sφ sec θ · cφ

p

q

r

(37)

where c Cosine, s Sine, t Tangent.

From equation 36, we can now take in the outputs from the IMU and map it to Euler angles through the function

H(θ, φ).

Equation 37, which transforms the output of the rate gyros to the desired Euler angles is called the Euler

Kinematical Equations.

### 8.7 Quaternions

Quaternions were first introduced by an Irish mathematician William Rowan Hamilton. It is a more robust form

of attitude representation, which eliminates the singularity or gimbal lock posed by Euler angles. A quaternion is

a (4x1) vector, which can describe complex rotations.

This is shown in Figure 63.

q =

Scalar

v¯(V ector)

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
(38)

q =

cos θ/2

e¯ · sin θ/2

- (39)

Where,

θ = rotation angle or transformational angle about a unique arbitrary axis.

e¯ = normalized axis of rotation (3x1)

NOTE:

- q here denotes quaternion, not the pitch rate.
- θ here denotes the transformation angle, not the pitch angle.

### 8.7.1 Quaternion Mathematics:

- Norm:
|q| =

,
q²

s + q²

x + q²

y + q²
z
Department of Mechanical Engineering | 53 | Dayananda Sagar College of Engineering

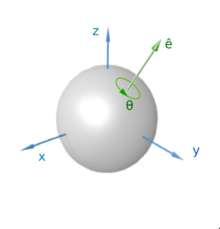
[picture p55: figure]

Figure 63: Quaternions

- Normalized quaternion:

## LQ`KHBxiBQM = q

|q|

- Conjugate:

q∗ =

qs
−qx
−qy
−qz
- Inverse:
q−1 = q∗
|q|

### 8.8 Attitude Representation using Quaternions

Objective:

It is important to be able to convert Euler angles to quaternions and vice versa. The reason is because it is

arduous to visualize quaternions as opposed to Euler angles.

Euler Angles DCM(φ,θ,ψ) | ,- | Quaternions

### 8.8.1 DCM to Quaternions

- DCM
−−−−−−→
Cb/v (3x3) | MATLAB dcm2quat | Quaternion
−−−−−−→
q (4x1)

### 8.8.2 Quaternions to DCM

- Quaternion
−−−−−−→
q (4x1) | MATLAB quat2dcm | DCM
−−−−−−→
Cb/v (3x3)

It is possible to obtain Euler angles from the DCM after conversion from quaternions.

Department of Mechanical Engineering | 54 | Dayananda Sagar College of Engineering

### 8.9 Transport Theorem

In 2D, if frame P is rotating with respect to frame O at a rate ˙ θ, then we say that the angular velocity of P with respect to O is ωP /O = ˙
θk. An illustration is shown in figure below. The following equation, known as the

‘Transport Theorem’, is a formula for the derivative of any vector r with respect to frame of reference O.
-dr

dt .

/O

=

-dr

dt .

/P

+ ωP /O × r | (40)

Transport theorem is used to switch between frames, for instance switch between inertial and body frames.

Transport theorem derivation is shown in appendix 14.7.

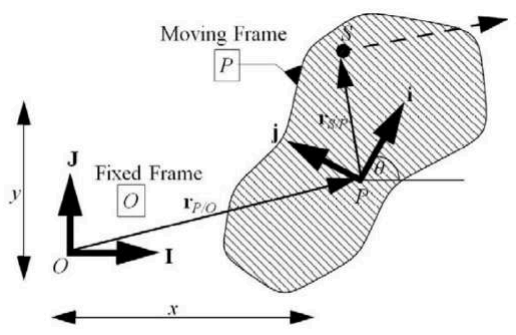
[picture p56: figure]

Figure 64: Rigid body hurtling through space [16]

### 8.10 Euler Equations

This consists of first order ODE’s describing the rotation of a rigid body using a noninertial/rotating frame of

reference with axes fixed to the body and parallel to body’s principle axes of inertia. This results in a total of

6DOF (3 translational and 3 rotational). The linear velocity, angular velocity, force and torque about the body

frame are shown in equations 41, 42, 43, 44 respectively.

## GBM2` o2HQ+Biv vb =

u

v

w

(41)

Where,

u, v, w are the components of the linear velocity vector in the x, y, z directions respectively.

## M;mH` o2HQ+Biv ω =

p

q

r

(42)

Department of Mechanical Engineering | 55 | Dayananda Sagar College of Engineering

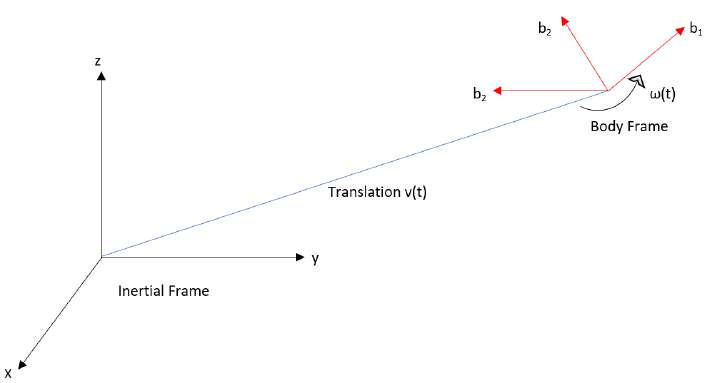
[picture p57: figure]

Figure 65: Rotation and Translation

6Q`+2 F =

Fx

Fy

Fz

(43)

## hQ`[m2 T =

L

M

N

(44)

Where,

L, M, N are the components of torque in the x, y, z directions respectively.

## LpB;iBQM *QQ`/BMi2b =

x

y

z

=

Longitudinal Position

Lateral Position

Height

(45)

vb =

u

v

w

b

= uˆb1 + vˆb2 + wˆb3 | (46)

-dv

dt .

inert

= du
dt · ˆb1 +

dv
dt ˆb2 +

dw
dt · ˆb3 + u ·

dˆb1
dt + v ·

dˆb2
dt + w ·

dˆb3
dt | (47)

First three terms in the RHS of equation 47 deal with the change in velocity with respect to body frame and the

next three terms deal with rotation of body coordinate frame with respect to inertial frame.

We arrive at,

v˙inert =˙vb +(ωb × vb) | (48)
Department of Mechanical Engineering | 56 | Dayananda Sagar College of Engineering

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

### 8.11 6 DOF and 3 DOF Algorithms

Algorithms used in Simulink 6 Degree of Freedom and 3 Degree of Freedom blocks.

8.11.1 6 Degree of Freedom Algorithms

Translational motion of the bodyfixed coordinate frame, where the applied forces [Fx Fy Fz]T are in the

bodyfixed frame, and the mass of the body m is constant.

F¯b =

Fx

Fy

Fz

= m 0
V¯b +¯ω × V¯b

1

Abb =

u˙ b

vḃ

w˙ b

= 1

m F¯b − ω¯ × V¯b

Abe = 1
m Fb

V¯b =

ub

vb

wb

, ω¯ =

p

q

r

(64)

The rotational dynamics of the bodyfixed frame, where the applied moments are [L M N]T, and the inertia tensor

I is with respect to the origin.

M¯B =

L

M

N

= Iω¯ +¯ω × (Iω¯)

I =

Ixx | −Ixy | −Ixz
−Iyx | Iyy | −Iyz
−Izx | −Izy | Izz

(65)

The relationship between the bodyfixed angular velocity vector, [ p q r ]T, and the rate of change of the Euler angles, *
φ˙ ˙

θ ψ˙

+
T, are determined by resolving the Euler rates into the bodyfixed coordinate frame. [17]

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
1(sin φ tan θ)(cos φ tan θ)

0 | cos φ | − sin φ
0 | sin φ cos θ | cos φ cos θ

p

q

r

(66)

Department of Mechanical Engineering | 59 | Dayananda Sagar College of Engineering

8.11.2 3 Degree of Freedom Algorithms

We obtain 3 DOF algorithms from 6 DOF algorithms following these assumptions:

1. No Roll i.e. φ =0. As we do not have roll control, it is a reasonable assumption.
2. No motion in Y axis i.e. v = 0, zero lateral velocity.

Zero roll angle ( φ =0) leads to decoupling of flat earth equations. Decoupling means that the equations of motion

separate into two independent sets. One set is longitudinal motion (pitching and translating in X-Z plane) and the

other set describes lateraldirectional motion (rolling, yawing and sideslipping). Decoupled equations are much

easier to handle in analytical studies. [18]

Referring to equation 56,

Fx − mg sin θ

Fy + mg sin φ cos θ

Fz + mg cos φ cos θ

= m

u˙ + qw − rv

v˙ + ru − pw

w¨ + pv − qu

(67)

Substituting φ =0 and v = 0 in equation 67 and simplifying, we get: [19]

Axb =˙u = Fx

m − qw − g sin θ, Axe = Fx m − sin θ

Azb =ẇ = Fz

m + qu + g cos θ, Aze = Fz m + cos θ

where b Body frame, e Earth frame.

q˙ = M
Iyy

˙
θ = q

(68)

### 8.11.3 Simulink 6 DOF and 3 DOF Blocks

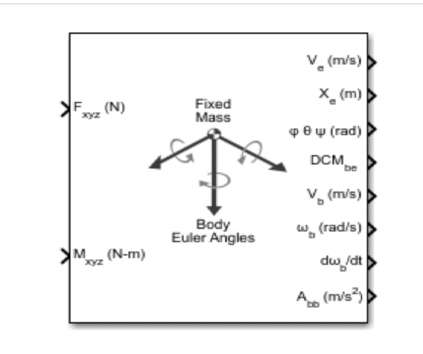
[picture p58: figure]
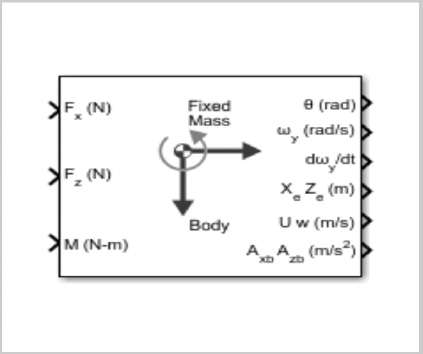
[picture p59: figure]

(a) 6 DOF Block | | (b) 3 DOF Block

Figure 66: Simulink Blocks

Department of Mechanical Engineering | 60 | Dayananda Sagar College of Engineering

## 9 Modelling and Simulation

Modelling is a technique for creating a virtual model of a physical system that involves both software and

hardware. If the model’s software components are driven by mathematical relationships, users can simulate this

virtual representation under a variety of conditions to see how it performs.

Modelling and simulation are particularly useful for testing conditions that are difficult to replicate with

hardware prototypes alone, especially early in the design process when hardware is not available. Iterating

between modelling and simulation can improve the standard of the system design early on, reducing the number

of errors detected later on. MATLAB Code Data for Simulation is shown in appendix 14.9.

Properties | Value | Units
Mass | 0.8246 | Kilogram
Moment of Inertia (YY) | 0.048 | Kilogram metre²
Moment Arm | 0.29 | Metre
Diameter of Rocket body | 0.076 | Metre
Drag Coefficient | 0.33 |
Delay | 2.5 | Seconds
Drop Height | 62 | Metre
TVC Misalignment Angle | 0.4 | Degree

Table 26: Properties used in simulation

### 9.1 Basic Flight Simulation

In this simulation, the rocket is dropped from a particular height to obtain position, velocity and acceleration graphs.

This simulation is performed to ensure the rocket reaches the ground at nearzero velocity further ensuring that

there’s minimal damage to the rocket body and landing legs. The simulation is divided into three sections namely,

Input, Calculation and Output.

Input Section: Input section consists of the thrust subsystem and rocket mass. The Lookup Table block in Simulink

allows for thrust variation with respect to time. A Transport Delay block is used to make provisions for time delay

ensuring the solid motor to ignite just before landing. Dry mass and solid propellant mass are both included in

mass block.

Calculation Section: This section consists of drag subsystem, integration, summation and division blocks. Net

force on the rocket body is calculated and acceleration is obtained. Acceleration is integrated to obtain velocity

which is further integrated to obtain the position of the rocket. Velocity obtained is used to calculate the drag force.

Output Section: A Scope block is used to visualise the position, velocity, acceleration and thrust curves.

Department of Mechanical Engineering | 61 | Dayananda Sagar College of Engineering

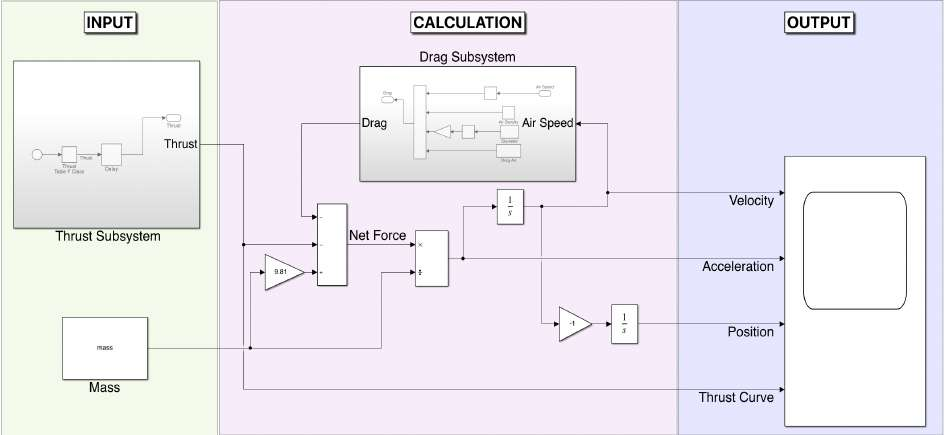
[picture p60: figure]

Figure 67: Basic Flight Simulation

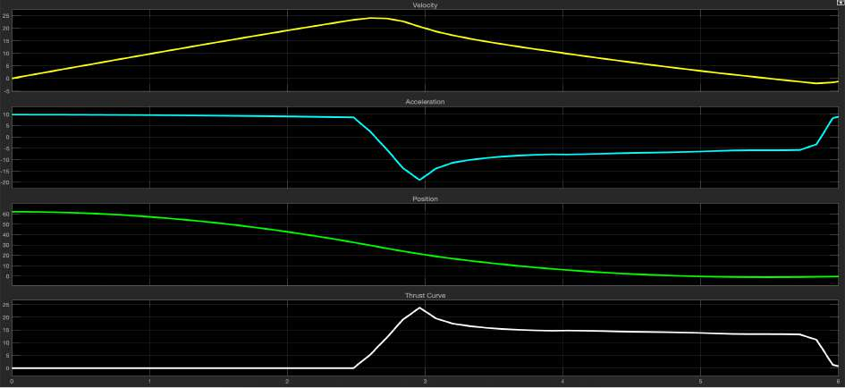
[picture p61: figure]

Figure 68: Results

Analysis and Interpretation of Results: The rocket experiences freefall as it is dropped from the drop height;

its velocity increases and reaches its maximum value until the solid motor is ignited. Upon ignition, acceleration

drops and so does the velocity until it reaches nearzero velocity at 6 seconds. Thus zero velocity is achieved close

to the ground. Thrust curve of an F-15 solid motor is also shown.

### 9.2 3 Degree of Freedom Flight Simulation

In this simulation, a closedloop feedback system is designed to control the rocket’s attitude. The simulation is

divided into three sections namely, Input, Dynamics and Control.

Input Section: Input section consists of the F-15 thrust curve which is represented by From Workspace block and

the TVC misalignment angle block (Imperfections in TVC mounting).

Dynamics Section: Dynamics section consists of the actuator subsystem and 3 DOF block 8.11.2.

Department of Mechanical Engineering | 62 | Dayananda Sagar College of Engineering

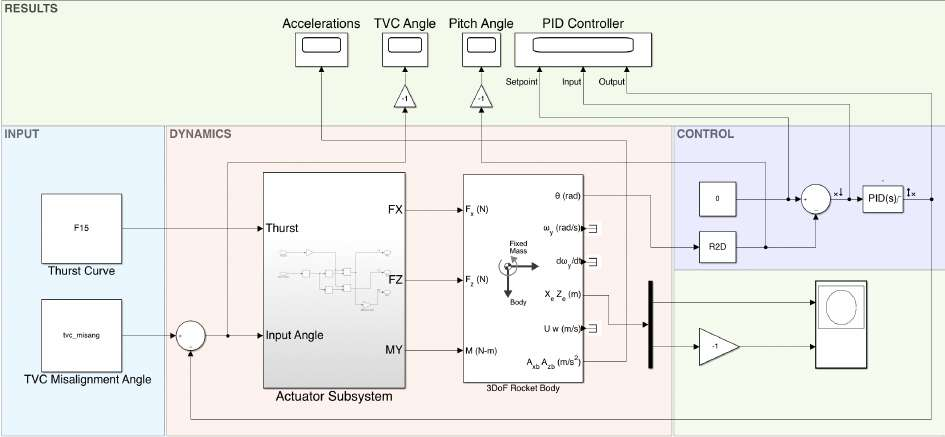
[picture p62: figure]

Figure 69: 3 DOF Flight Simulation

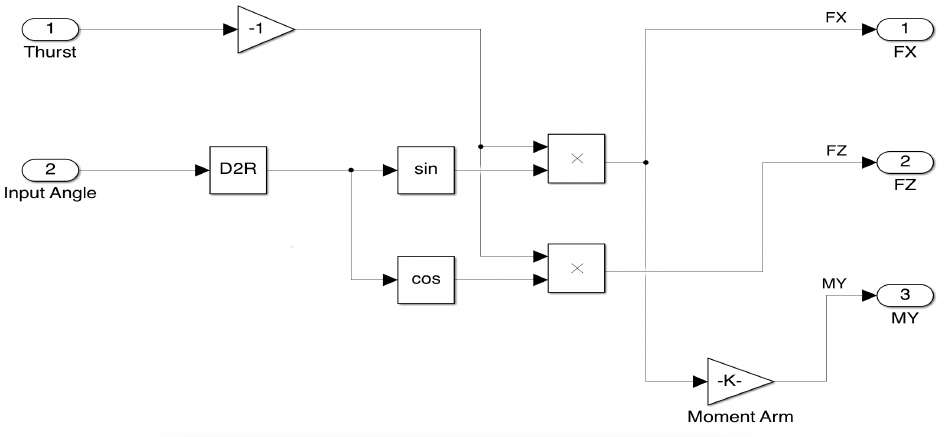
[picture p63: figure]

Figure 70: Actuator Subsystem

Actuator Subsystem:
Fx = Thrust × sin(θ)

Fz = Thrust × cos(θ)

My = Thrust × sin(θ) × Moment Arm

(69)

where θ = Input Angle, Moment Arm = Distance from CG to TVC mount location.

Control Section: The rocket’s attitude is controlled by a Proportional Integral Derivative (PID) controller. The

desired orientation of the rocket is vertical, i.e. zero degree deviation. Hence, a set point of zero is used, and the

error is the difference between the set point and the rocket angle. The PID controller constantly monitors the error

value and uses it to calculate the proportional, integral, and derivative gains. The controller then combines these

three values to produce the output. The output of the PID block is subtracted from the TVC misalignment angle

and fed to the actuator subsystem as an input. As a result, a closedloop feedback system is established.

Department of Mechanical Engineering | 63 | Dayananda Sagar College of Engineering

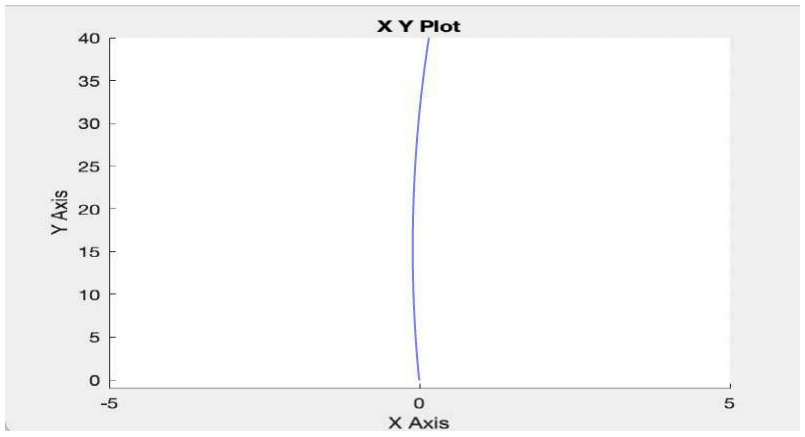
[picture p64: figure]

Figure 71: Trajectory

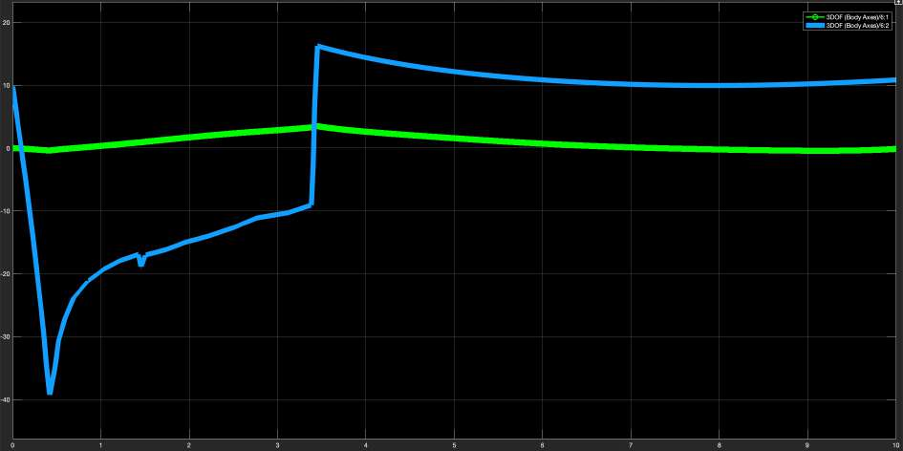
[picture p65: figure]

Figure 72: Acceleration

Analysis and Interpretation of Results: The rocket’s trajectory during the first 40 metres, when the thrust

vector control is active, that is, when the solid motor is ignited, is shown. The rocket attempts to maintain a

straight trajectory, however the deviation is caused due to the lift force acting perpendicular to the direction of

travel. The green line in the acceleration graph shows the acceleration in the lateral direction (aX). The PID

controller effectively reduces the deviation. The blue line represents the F-15 thrust curve.

Errors in the trajectory and acceleration graph can be corrected using advanced controllers such as Full State

Feedback Control. Unlike traditional controllers such as PID, Linear Quadratic Regulator (LQR) can handle cases

with param eter uncertainties and disturbances. LQR produces a good approximation for non linear systems that

occur in real world.

Department of Mechanical Engineering | 64 | Dayananda Sagar College of Engineering

## 10 Flight Computer

### 10.1 Introduction

The Flight computer is a microcontroller unit coupled with peripheral components consisting of input devices

such as sensors, potentiometer, switch etc and output devices such as relays, servos, and motors. The

microcontroller unit interfaces with the sensors and sends signals as output to control external processes such as

the triggering of the engine, the actuation of servos and the transmission of data. The interface between all

devices connected to the MicroController Unit (MCU) takes place with the help of certain communication

protocols. To name some of the protocols, we have, the Integrated Circuit (I2C) Protocol, the Serial Peripheral

Interface(SPI) Protocol etc.

The need for a Flight Computer arises from the fact that inspite of having an adequate amount of passive

stability rooting form the rocket design, the uncertainties due to numerous variables affecting the attitude of the

model rocket during the landing phase warrants the need of a controller which corrects the attitude of the system.

The project uses PID controller to provide output to the TVC which actuates the rocket motor.

For simplicity the microcontroller along with its peripherals will be referred to as Flight Computer from here

on.

### 10.2 Components

### 10.2.1 Microcontroller

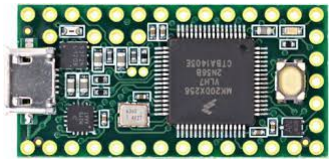
[picture p66: figure]

Figure 73: Microcontroller: Teensy 3.2

The microcontroller acts as the brain of the control system. We used a Teensy 3.2 microcontroller board owing

to its availability and versatility. With a 32 bit ARM Cortex-M4 at 72 MHz(96MHz overclocked), 256Kb Flash,

64Kb RAM and 34 pin input/output ports, Teensy 3.2 by far outperforms its rivals in the same footprint range.

Department of Mechanical Engineering | 65 | Dayananda Sagar College of Engineering

### 10.2.2 Inertial Measurement Unit (IMU)

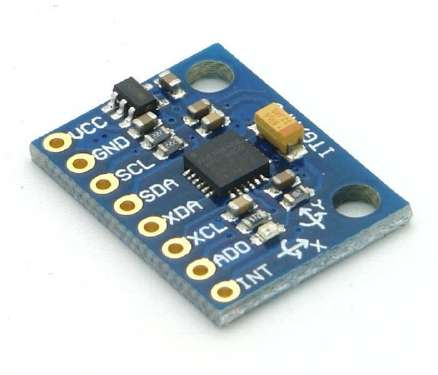
[picture p67: figure]

Figure 74: IMU: MPU6050 Module

The IMU is responsible for determining the orientation of the rocket during it time in descent. The MPU6050

sensor by Invensense does the job needed and is abundant in the market, thus we found it easy to incline towards

this particular sensor. In addition the MPU6050 has enough documentation and open source libraries to make it

easy for us to access the orientation parameters from its registers without worrying much about the inner workings

of the sensor. It interfaces with the Teensy 3.2 MCU using the I2C protocol.

### 10.2.3 Barometric Pressure Sensor (Altimeter)

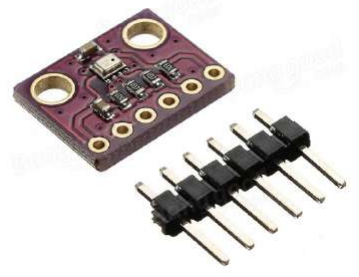
[picture p68: figure]

Figure 75: Altimeter: BMP180 Module

As our project’s performance depends on accurate measurements of altitude above the ground in order to trigger

the model rocket engine, it is crucial to select a sensor which measures altitude with appropriate accuracy. The

BMP280 by BOSCH was considered suitable as it is a barometric pressure sensor and is sensitive to slight changes

in the atmospheric pressure (accurate upto 1meter) this pressure can be used to calculate the altitude above the

ground level. The manufacturer projected sensitivity and range is + 1 hPa and -500m to +9000m.

Department of Mechanical Engineering | 66 | Dayananda Sagar College of Engineering

### 10.2.4 Transceivers

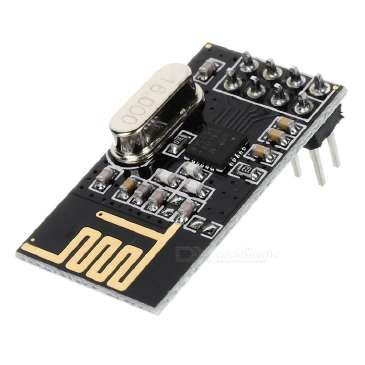
[picture p69: figure]

Figure 76: nRF24l01+ Transceiver module

Transceivers are devices which can act as a transmitter and a receiver based on the command input provided by

the microcontroller. For our project we went with a pair of nRF24L01+ modules to transmit data from the model

rocket to the ground station. The device consumes a maximum of 13.5mA at a data rate of 2Mbps. The module is

widely popular for its compatibility with microcontrollers and its ultra low power consumption.

### 10.2.5 Voltage Regulator

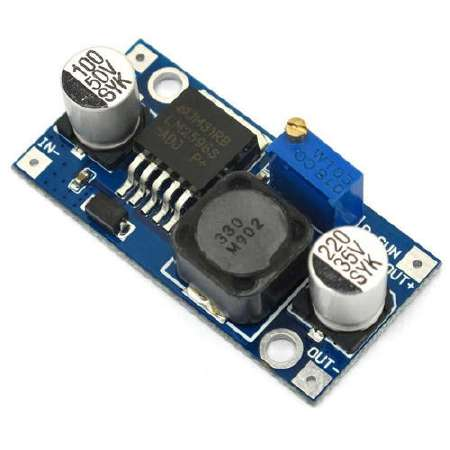
[picture p70: figure]

Figure 77: Voltage Regulator

In order to function accurately the flight computer needs a stable power supply, failing which the sensors can

malfunction and provide garbage values. This problem is eliminated by the use of a voltage regulator. We chose

the LM2596 S DC-DC Buck Convertor as it was readily available and some LM7805 linear regulators as backups,

however it is highly unlikely that the buck would fail as we would be operating well within the operating voltage

and current parameters.

Department of Mechanical Engineering | 67 | Dayananda Sagar College of Engineering

### 10.2.6 Trigger Channels

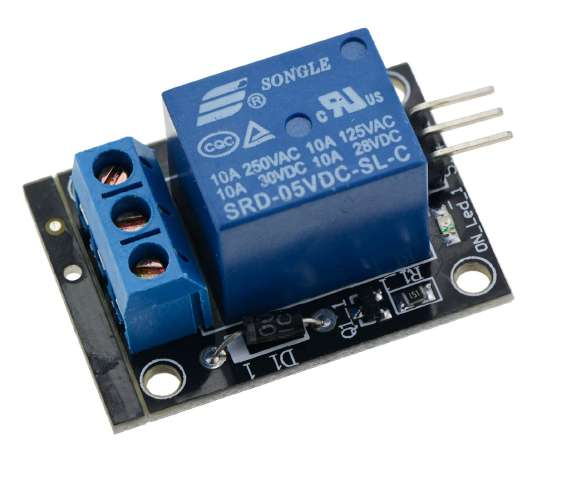
[picture p71: figure]

Figure 78: Trigger Channels

The model rocket engine is required to be ignited at the calculated altitude so as to have its burn time adjusted in

accordance with the landing. To fulfil this requirement, we used a singlechannel relay to bring about the triggering

of the model rocket engine.

### 10.2.7 Servo Motors

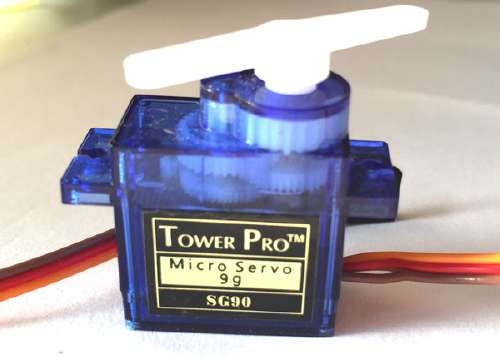
[picture p72: figure]

Figure 79: Metal Gear Servo Motor

After the sensing phase the controller gives a controlled output which in turn actuates the servo motors. These

servo motors move the TVC and as a result the vectoring of the thrust provided by the rocket engine produces an

appropriate amount of torque to restore the rocket body back to vertical. For the project we use SG90 metal gear

servos.

Department of Mechanical Engineering | 68 | Dayananda Sagar College of Engineering

### 10.2.8 Power Source

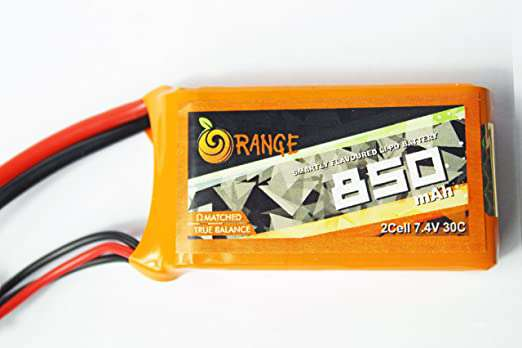
[picture p73: figure]

Figure 80: LiPO Battery

To power the onboard flight computer a Lithium Polymer (LiPo) Battery is used. The battery employed has a

capacity of 850mAh, a discharge rate of 30C, a nominal voltage of 7.4v and weighs around 53g.

### 10.3 Configuration Selection

The selection of these components was primarily based on availability. However, in terms of performance our

concern revolved around the weight of the components and in particular, the current draw. This is because the

electronic components such as sensors and the microcontroller are quite sensitive to current as they get fried in an

episode where the current overshoots the maximum value allowed by their inner circuitry. That said, these episodes

are rare and hardly any cause of concern. The following table lists the current drawn by each component in their

maximum power setting. The total current drawn is then compared with the maximum discharge capabilities of

the battery to avoid overdischarging the battery [21][22][23][24][25].

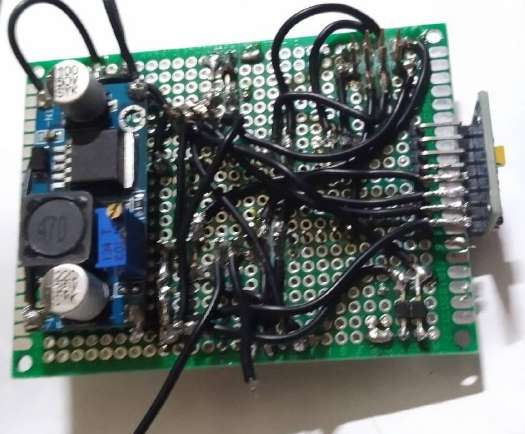
[picture p74: figure]

Figure 81: Flight Computer 1

Department of Mechanical Engineering | 69 | Dayananda Sagar College of Engineering

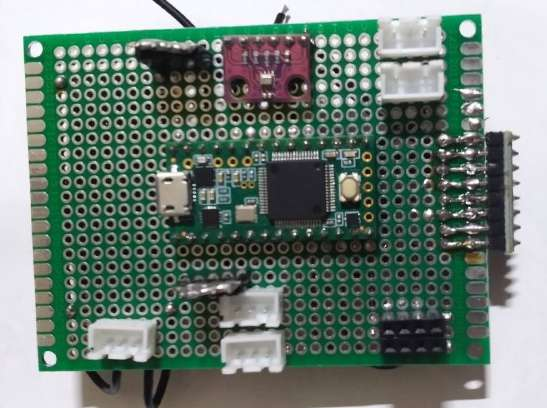
[picture p75: figure]

Figure 82: Flight Computer 2

Component | Module Name | Operating Voltage (V) | Max. Current Draw (mA)
Microcontroller | Teensy 3.2 | 3.6V 6.0V | 1100 mA
Pressure Sensor | GY-BMP280 | 3.0V 3.3V | 1.12 mA
Inertial Measurement Unit (IMU) | GY-521 MPU60050 | 3.0V 5.0V | 3.9 mA
Transceiver | nRF41|01+ | 1.9V 3.6V | 13.5 mA
Servo Motor x3 | SG90 | 3.0V 6.0V | 750 mA x3 = 2250 mA
Relay | 1 channel 5V Relay | 5.0V | 20 mA
| | | 3388.52 mA = 3.39 A

Table 27: Components Specifications

### 10.4 Schematic Diagram

The pinout diagram of each component and the interconnections between them is shown in the following

schematic.

Department of Mechanical Engineering | 70 | Dayananda Sagar College of Engineering

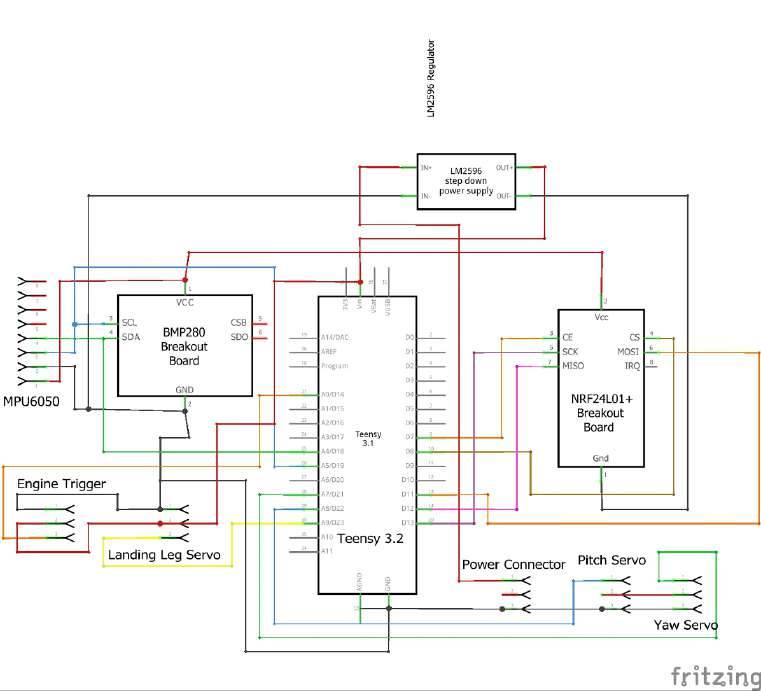
[picture p76: figure]

Figure 83: Schematics

The schematic diagram is one of the starting points for making a flight computer. It becomes easy to understand

the logic levels at which each component operates to avoid overloading the components with excess power. The

above schematic helps us understand the connections in a much simpler way. However, this information only acts

as an initial step in making a prototype of the flight computer board. This was done in an open source PCB design

software called Fritzing.

### 10.5 Printed Circuited Board Diagram

After the initial prototyping of the flight computer, we came to realize that printing a PCB is a much simpler way

of making multiple flight computers ready to being tested. This saves lot of time in testing and is much quicker to

prototype. This was also created through Fritzing version 0.9.3b.

Department of Mechanical Engineering | 71 | Dayananda Sagar College of Engineering

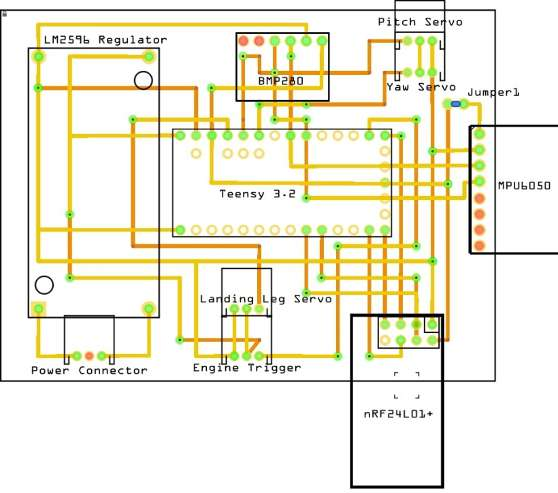
[picture p77: figure]

Figure 84: Printed Circuit Board

### 10.6 Block Diagram

The Block Diagram conveys all the superficial information about the flight computer hardware such as the

protocols followed to communicate between the component and the microcontroller (i.e. I2C, SPI, CAN, UART

etc). Furthermore, it also contains arrows representing the flow of signal to or from the microcontroller.

Department of Mechanical Engineering | 72 | Dayananda Sagar College of Engineering

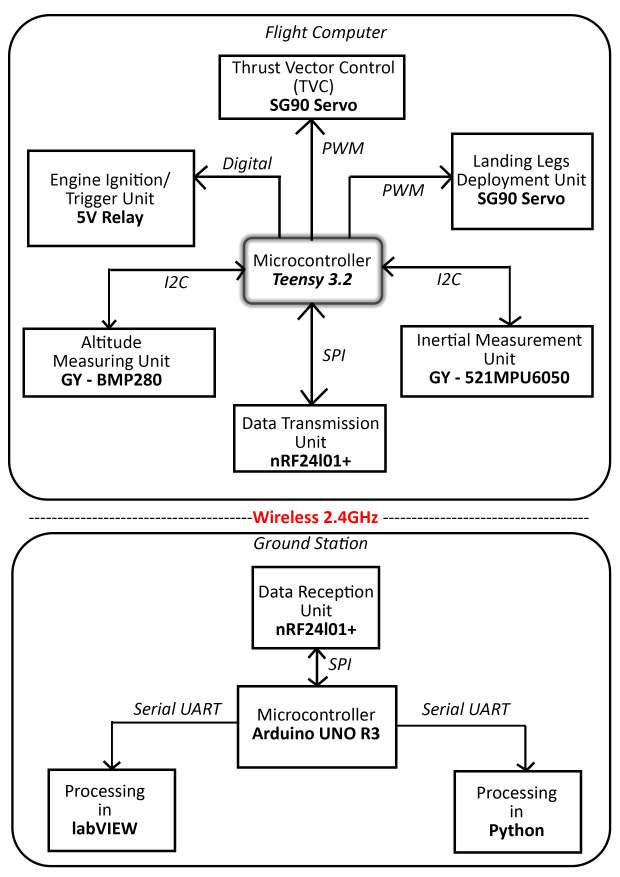
[picture p78: figure]

Figure 85: Block Diagram

### 10.7 Flow Chart

The flowcharts very well represent the control flow and the algorithm followed by the program. The following

flowchart depicts underlying logic and algorithm behind the program.

Department of Mechanical Engineering | 73 | Dayananda Sagar College of Engineering

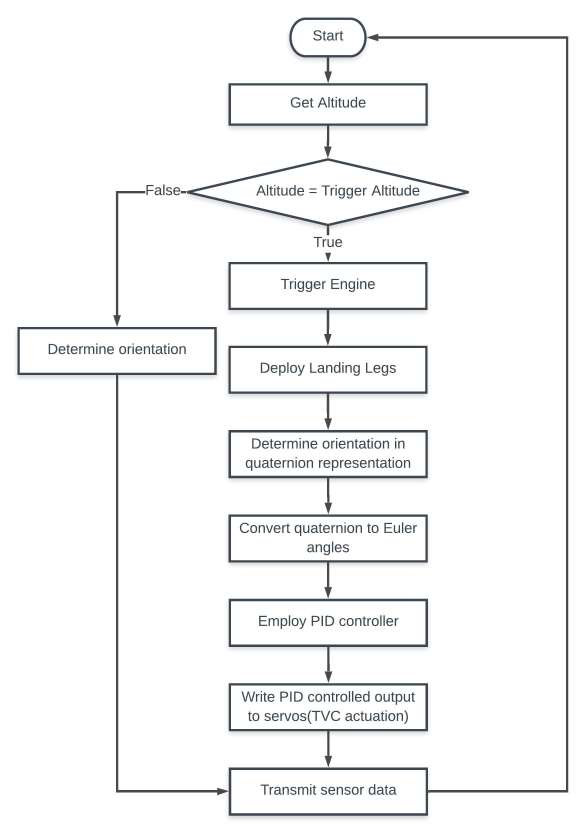
[picture p79: figure]

Figure 86: Flow Chart

### 10.8 Processing in Python

The flight computer transmits data to the ground station, where the transmitter data gets picked up by another

nRF24l01+ module and transferred to a processing environment such as python or labVIEW. For this purpose we

chose python environment and programmed it to process the orientation and altitude data sent by the flight

computer inside the model rocket, and provide a visual understanding of the realtime orientation of the rocket

during its descent. The following snippet shows a 3D representation of the model rocket and its orientation with

respect to the vertical.

The IMU sensor data transmitted by the flight computer in the form of a quaternion needs to be converted into

the parameters understood by the python environment. Thus, in order to convert a quaternion representation of

orientation to the Euler angle representation, the following operations are performed.

Department of Mechanical Engineering | 74 | Dayananda Sagar College of Engineering

φ

θ

ψ

=

atan 2

0
2(q0q1 + q2q3), 1 − 2

0
q²

1 + q²
2

11

asin (2 (q0q2 − q3q1))

atan 2

0
2(q0q3 + q1q2), 1 − 2

0
q²

2 + q²
3

11

(70)

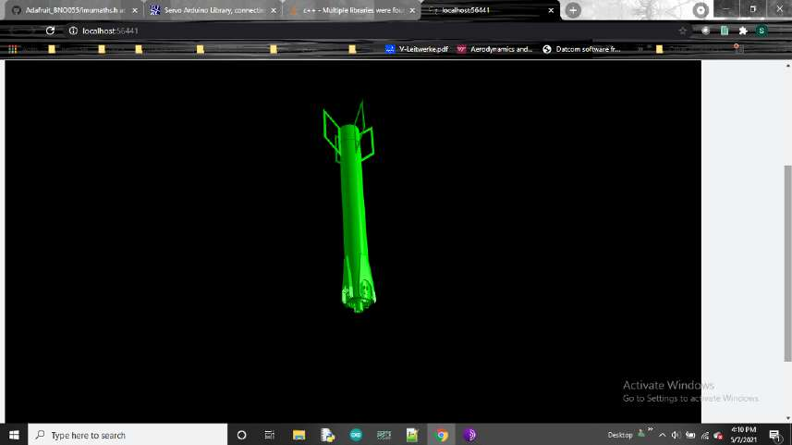
[picture p80: figure]

Figure 87: Processing via Python

## 11 Manufacturing

To develop some of the components required for the model rocket, we employed a 3D-printing process. Fused

Deposition Modelling (FDM) also commonly known as Fused Filament Fabrication (FFF), is an additive

manufacturing process wherein a 3D-printing material (mostly thermoplastics) are melted by the means of an

extrusion process. The melted printing material is then moved in a predetermined direction as obtained from

sliced CAD data. FDM is the most common type of 3D printing technology. An FDM printer is shown in Figure

88.

Department of Mechanical Engineering | 75 | Dayananda Sagar College of Engineering

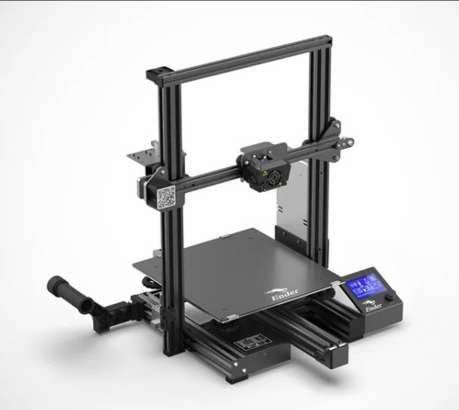
[picture p81: figure]

Figure 88: FDM Printer: Ender 3

Process of working:

- Once the nozzle of the 3D printer has reached its desired temperature, the printing filament is fed to the

extrusion head.

- A 3-directional system which is attached to the extrusion head allows for movement in the X,Y,Z directions.

To fill an area, multiple passes are required.

- Cooling of the melted 3D printing material is can be accelerated by the usage of a fan.
- To fill an area, multiple passes are required and the process is repeated until the part is complete.

We used this process for the fabrication of the Thrust Vector Control (TVC), passive fins, landing legs and

bulkheads. The 3D printing material chosen was Polylactic Acid (PLA). PLA was a good choice as opposed to

other materials such as Acrylonitrile Butadiene Styrene (ABS), Polyethylene Terephthalate (PET), Polyethylene

Terephthalate Glycol (PETG), Thermoplastic Polyurethane (TPU), mainly due to the reason that PLA is made of

lactic acid and is biodegradable.

Department of Mechanical Engineering | 76 | Dayananda Sagar College of Engineering

### 11.1 Manufactured Parts

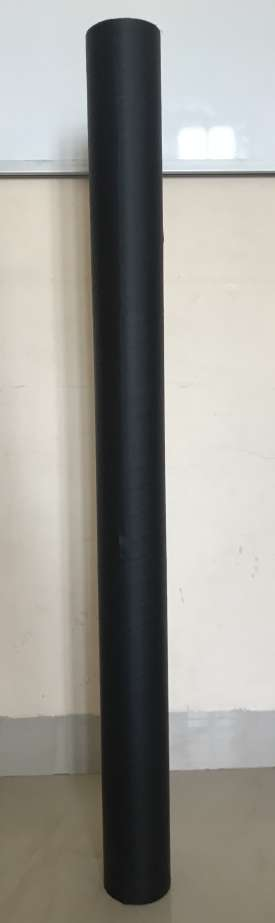
[picture p82: figure]

Figure 89: Airframe

Department of Mechanical Engineering | 77 | Dayananda Sagar College of Engineering

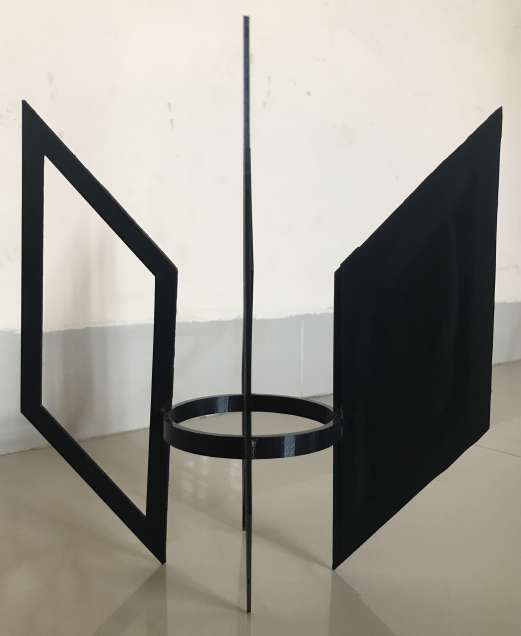
[picture p83: figure]

Figure 90: Fins

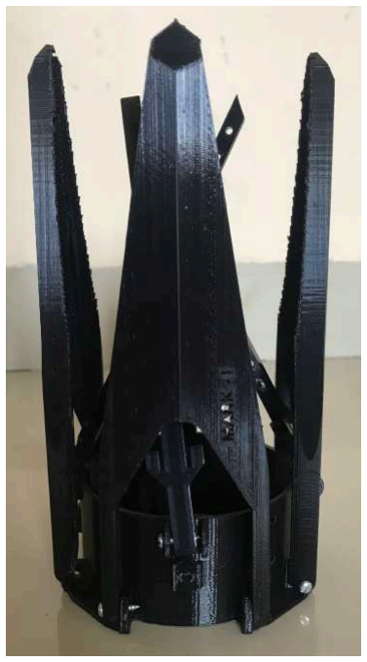
[picture p84: figure]

Figure 91: Landing Leg Assembly Closed Form

Department of Mechanical Engineering | 78 | Dayananda Sagar College of Engineering

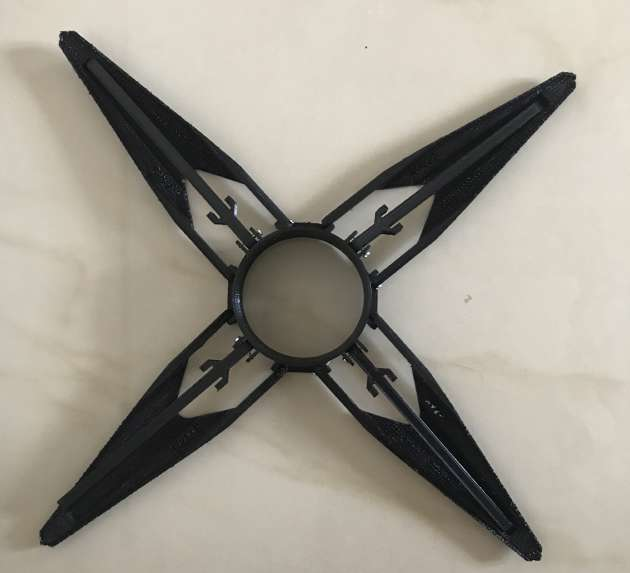
[picture p85: figure]

Figure 92: Landing Leg Assembly Open Form

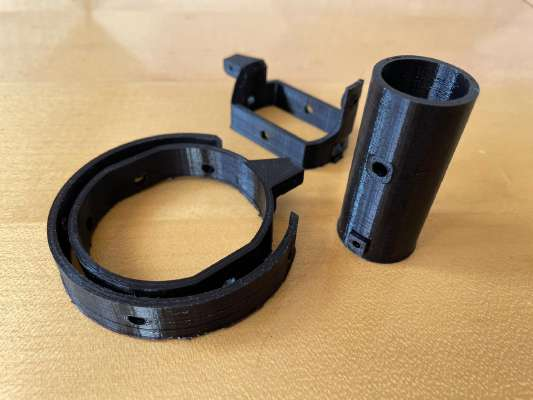
[picture p86: figure]

Figure 93: Thrust Vector Control

## 12 Conclusions

The design and sizing of the rocket was mainly dictated by the solid rocket motor’s average thrust. Since the

average thrust was just adequate and just sufficed the requirements set by the objectives, so the team

predominantly focused on optimizing the weight and hence optimization of design was prioritized. Design

streamlining was assisted by conducting an array of analysis including static structural analysis, modal frequency

analysis and Computational Fluid Dynamics (CFD).

Thrust Vector Control was an integral part of the model rocket, which allowed effective attitude control. We

Department of Mechanical Engineering | 79 | Dayananda Sagar College of Engineering

used a gimballed thrust vectoring mechanism and to do so, two designs were developed through optimised

iterations. The three parts of the TVC namely motor mount, inner gimbal and outer gimbal were used to house

the motor and provide movement in the pitch and yaw axes.

We first understood the dynamics behind the 6 DOF and 3 DOF blocks to ensure that the simulations were

not a blackbox.The use of Euler angles and Quaternions to represent attitudes was also discussed. The equations

for the flat earth six degrees of freedom were derived and reduced to three degrees of freedom. MATLAB and

Simulink were used to create the basic flight simulation that ensured the rocket touched the ground at a nearzero

velocity. The mass of the solid rocket motor was also determined using this simulation, which took into account

the thrust generated by the solid rocket motor. We were able to finetune the PID gains which ensured the rocket

remained vertical using the 3 DOF flight simulation.

As with all the parts of the rocket, the flight computer auto corrects the error in the inclinations with respect

to the vertical caused due to uncertain parameters such as wind and manufacturing error leading to CG

imbalances. The correction brought about by the flight computer was essentially a controlled output produced by

the PID controller in response to the error between actual and the set point readings of inclinations. However,

due to it being dependent on a PID controller, the tuning of the gains was almost always an experimental

problem. The simulations performed in MATLAB served as a sufficient approximation to obtain the gains

needed by the flight computer. The realtime knowledge of orientation gives an insight of how well the whole

system responds in an experimental environment. Therefore, the model rocket comprising of all the subsystems

discussed, does hold true promise in the understanding of autonomous landings for similar vehicles in its class.

This report comprises an overall structure and workflow to understand the fundamentals and working behind

low and medium powered model rockets. Due to the COVID-19 crisis, the testing phase could not be completed.

### 12.1 Scope for future work

If there was no time barrier present, the team wanted to indulge in other methods for achieving these objectives.

To begin with, PID tuning using neural networks (NN) and using reinforcement learning (RL) to land a model

rocket. Apart from this, using computer vision for orientation data, the control system can be designed such that

precise landing can be obtained with high accuracy too and for this method we would use convolutional neural

networks (CNN). But this approach would require expensive electric ducted fans so as to repeat the tests

frequently and for larger duration. Advanced control algorithm such as Linear Quadratic Regulator (LQR) or

Model Predictive Control (MPC) can be implemented. LQR provides the control engineer with two knobs to

directly penalize states and controls respectively and tries to synthesize a controller which respects the cost

function.

Department of Mechanical Engineering | 80 | Dayananda Sagar College of Engineering

## 13 References

[1] S. Niskanen, “Openrocket technical documentation,” Development of an Open Source model rocket

simulation software, pp. 11–13, 2013.

[2] G. K. Mandell, G. J. Caporaso, and W. P. Bengen, Topics in advanced model rocketry. MIT Press, 1973.
[3] M. Canepa, Modern highpower rocketry. Trafford Publishing, 2005, vol. 2.
[4] “F-15 motor specifications,” https://www.grc.nasa.gov/www/k-12/rocket/rktcp.html, (https://www.grc.nasa.gov/www/k-12/rocket/rktcp.html) accessed:2021/05/1.
[5] “F-15 motor thrust curve,” https://www.thrustcurve.org/motors/Estes/F15/, accessed:2021/05/1.
[6] “Determining | centre | of | gravity,” | https://www.grc.nasa.gov/www/k-12/rocket/rktcg.html, (https://www.grc.nasa.gov/www/k-12/rocket/rktcg.html)

accessed:2021/05/1.

[7] “Determining | centre | of | pressure,” | https://www.grc.nasa.gov/www/k-12/rocket/rktcp.html, (https://www.grc.nasa.gov/www/k-12/rocket/rktcp.html)

accessed:2021/05/1.

[8] N. Tun, M. Thuri, Z. Li et al., “Aerodynamic coefficients prediction for 122 mm rocket by using

computational fluid dynamics,” in IOP Conference Series: Materials Science and Engineering, vol. 816,

no. 1. IOP Publishing, 2020, p. 012010.

[9] “Basics of dynamic flight analysis, part 2, the corrective moment coefficient,” https://www.apogeerockets.

com/education/downloads/Newsletter193.pdf, (https://www.apogeerockets.com/education/downloads/Newsletter193.pdf) accessed:2021/05/1.

[10] “Basics of dynamic flight analysis, part 3, the damping moment coefficient,” https://www.apogeerockets.

com/education/downloads/Newsletter195.pdf, (https://www.apogeerockets.com/education/downloads/Newsletter195.pdf) accessed:2021/05/1.

[11] “Basics of dynamic flight analysis, part 5, the damping ratio,” https://apogeerockets.com/education/

downloads/Newsletter197.pdf, (https://apogeerockets.com/education/downloads/Newsletter197.pdf) accessed:2021/05/1.

[12] J. S. Barrowman, “The practical calculation of the aerodynamic characteristics of slender finned vehicles,”

1967.

[13] “Openfoam tutorial guide,” https://www.openfoam.com/documentation/tutorialguide.
[14] “Gimbaled thrust,” https://www.grc.nasa.gov/WWW/K-12/rocket/gimbaled.html. (https://www.grc.nasa.gov/WWW/K-12/rocket/gimbaled.html)
[15] “The vector product,” https://www.mathcentre.ac.uk/resources/uploaded/mctyvectorprod-2009-1.pdf.
[16] J. Vandiver, and David Gossard. 2.003SC Engineering Dynamics. Fall 2011. Massachusetts Institute of

Technology: MIT OpenCourseWare, https://ocw.mit.edu. License: Creative Commons BY-NC-SA.

[17] “6 dof (euler angles),” https://in.mathworks.com/help/aeroblks/6dofeulerangles.html, accessed:2021/05/1.
[18] B. Stevens and F. Lewis, Aircraft Control and Simulation. Wiley, 2003.
[19] “3 dof (body axes),” https://in.mathworks.com/help/aeroblks/3dofbodyaxes.html, accessed:2021/05/1.
Department of Mechanical Engineering | 81 | Dayananda Sagar College of Engineering

[20] “Flight | mechanics,” | https://faculty.washington.edu/lum/EducationalVideos.htm#FlightMechanics,

accessed:2021/05/1.

[21] “Mpu6050 | module | | data | sheet,” | https://invensense.tdk.com/wpcontent/uploads/2015/02/

MPU-6000-Datasheet1.pdf, (https://invensense.tdk.com/wp-content/uploads/2015/02/MPU-6000-Datasheet1.pdf) accessed:2021/05/1.

[22] “Bmp280 module data sheet,” https://www.boschsensortec.com/media/boschsensortec/downloads/

datasheets/bstbmp280-ds001.pdf, (https://www.bosch-sensortec.com/media/boschsensortec/downloads/datasheets/bst-bmp280-ds001.pdf) accessed:2021/05/1.

[23] “nrf24l01+ transceiver data sheet,” https://www.sparkfun.com/datasheets/Components/SMD/

nRF24L01Pluss_Preliminary_Product_Specification_v1_0.pdf, (https://www.sparkfun.com/datasheets/Components/SMD/nRF24L01Pluss_Preliminary_Product_Specification_v1_0.pdf) accessed:2021/05/1.

[24] “Teensy 3.2 data sheet and schematics,” https://www.pjrc.com/store/teensy32.html, accessed:2021/05/1.
[25] “Sg90 servo motor specifications,” https://www.towerpro.com.tw/product/sg90-7/, (https://www.towerpro.com.tw/product/sg90-7/) accessed:2021/05/1.
Department of Mechanical Engineering | 82 | Dayananda Sagar College of Engineering

## 14 Appendix

### 14.1 Appendix A: Aerodynamic Modelling Functions and Description

Symbol | Description | Function

Constants

L | Reference length, Diameter of body tube |
AT | Planform area of one fin; area of fin when viewed from above |
Ar | Reference area; crosssectional area of body tube |
S | Exposed fin semispan; measured from root chord |
rL | Leading edge sweep angle | rL =1.1019 t² r cr
ABf | Base area of one fin at root |
cr | Fin root chord |
hr | Root fin trailing edge thickness |
tr | Root fin thickness |
fb | Body fineness ratio | fb = Length of rocket W idth of rocket
AWB | Total body wetted area |
AB | Base area at tail |
ABN | Nose base area |
AWN | Nose wetted area |
AW | Total wetted area |
AR | Aspect Ratio of exposed fin | AR = S² Ar
Af | Total area of one fin |

User inputs

u | Velocity |
M | Mach Number | M = V usound
ρ | Air density |
µ | Air Viscosity |
α | Angle of Attack |
N | Number of fins; 3 or 4 |
Re | Reynolds Number | ρuL µ
Department of Mechanical Engineering | 83 | Dayananda Sagar College of Engineering

CD | Total Drag Coefficient | CD = CDTT + CDBT
CDTT | Tail Drag Coefficient | CDTT = CDfT + CDBT + CDLT + CDTT
CDfT | Tail skin friction drag coefficient | 2NCfC AT Ar
CDLT | Tail leading edge drag coefficient | " SrL # CDLT =2N cos² ΓL (∆CD) Ar
CDBT | Tail trailing edge drag coefficient | ! ABf " CDBT = 0.135N Ar √3 CfB √K−M² cos² Γc
CDTT | Tail thickness drag | -AT . *- tr . CDTT =4NCfc cos² Γc AT cr 30 "tr #4 cos² Γc cr + 0√K − M² cos² Γc 13
CDTB | Body component of drag | CDTB = CDP + CDBB
CDP | Body pressure drag | CDP = 6AWB Cfc f³ RAr(K−M²)⁰.6
CDBB | Body base drag | CDBB = 0.29# AB $ Ar % # AWAB $ Cfc (K−M²)

Other Calculations

Cf | Incompressible Skin coefficient drag | Cf = 1 √.328 Re
CfC | Compressible Skin coefficient drag | CfC = Cf (1 − 0.12M²)
∆CD | Drag coefficient of leading edge | ∆CD = 0 1 − M²1−0.417 − 1
Cfb | Incompressible Skin friction coefficient drag | Cfb = 2Cf cr hr
K1 | Trailing edge drag correction constant | K1 = -. ! AEf " 0.135N 1+ 18Cfc( tr hr ) 2 Ar N(1−0.52)# AEf $ 1 C 3 Ar fe + cos² Γc
Kcone | Body pressure drag correction constant | Kcone =1+ * + 5 6.82AWB Cfc (fN +0.7)¹.29 3 (f³ BAr)
K2 | Body base drag correction constant | K2 =1+ 1 # AWAB $ [6.38+39.7( hr cr )]Cfc
B | Compressibility Factor | √ B = 1 − M²
XTB | Longitudinal Tail center of pressure |
XCG | Location of CG from tip |
∆x | Distance between aerodynamic center of tail and center of gravity | ∆x = XTB XCG
Department of Mechanical Engineering | 84 | Dayananda Sagar College of Engineering

### 14.2 Appendix B: OpenFOAM blockMeshDict Code

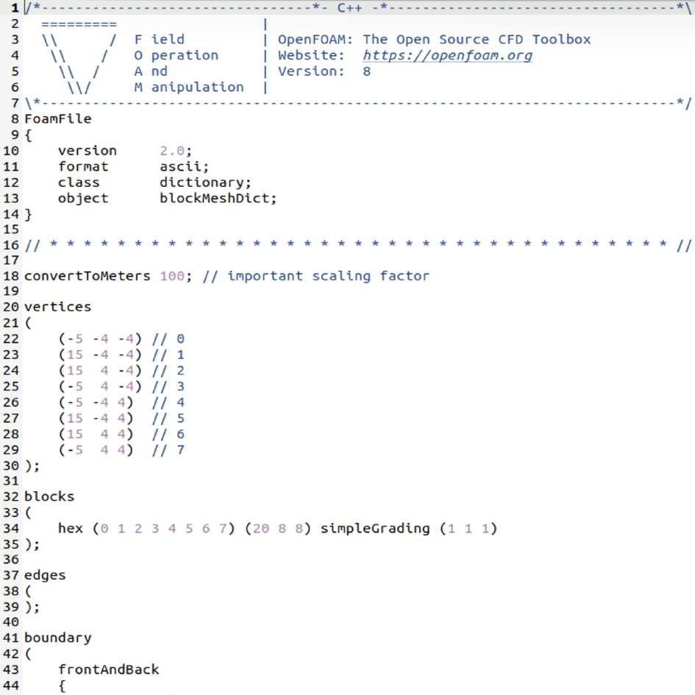
[picture p87: figure]

Department of Mechanical Engineering | 85 | Dayananda Sagar College of Engineering

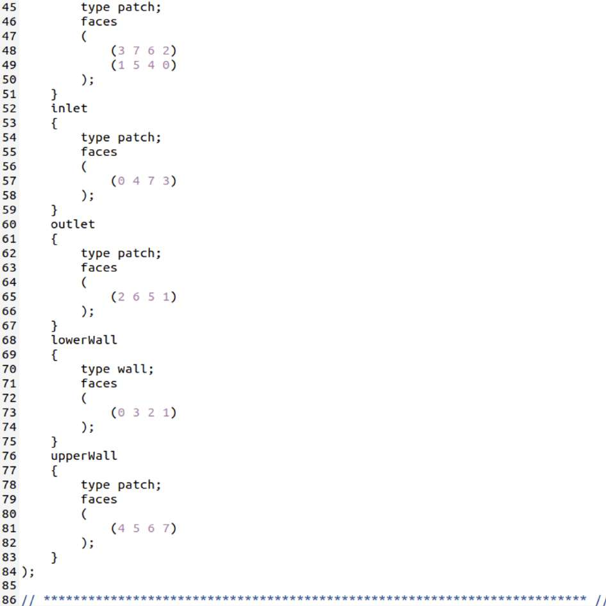
[picture p88: figure]

s

Department of Mechanical Engineering | 86 | Dayananda Sagar College of Engineering

### 14.3 Appendix C: OpenFOAM snappyHexMesh Code

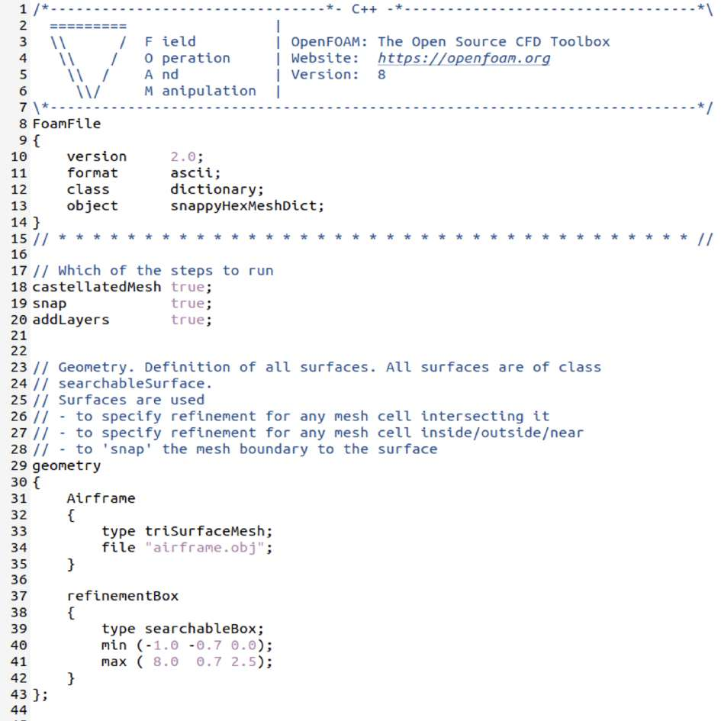
[picture p89: figure]

Department of Mechanical Engineering | 87 | Dayananda Sagar College of Engineering

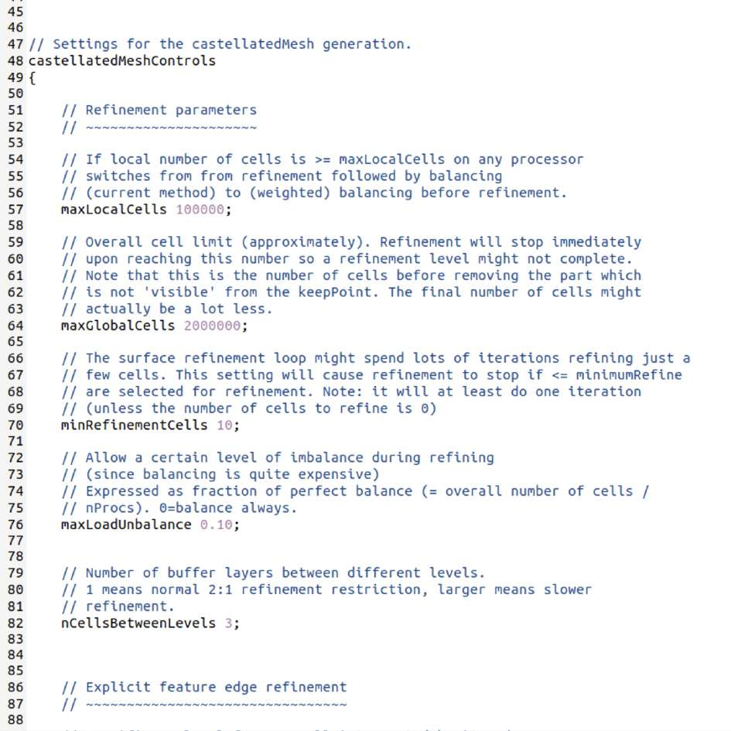
[picture p90: figure]

Department of Mechanical Engineering | 88 | Dayananda Sagar College of Engineering

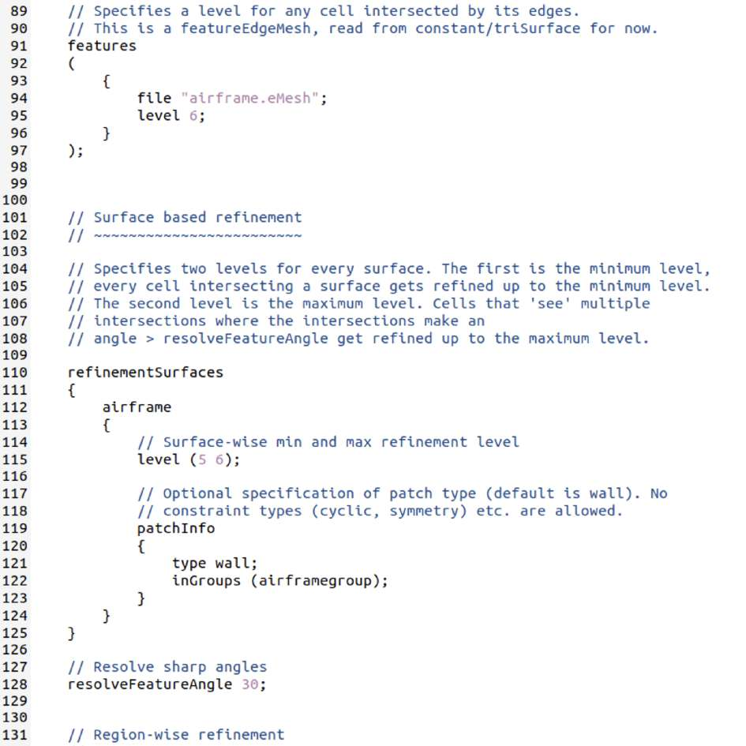
[picture p91: figure]

Department of Mechanical Engineering | 89 | Dayananda Sagar College of Engineering

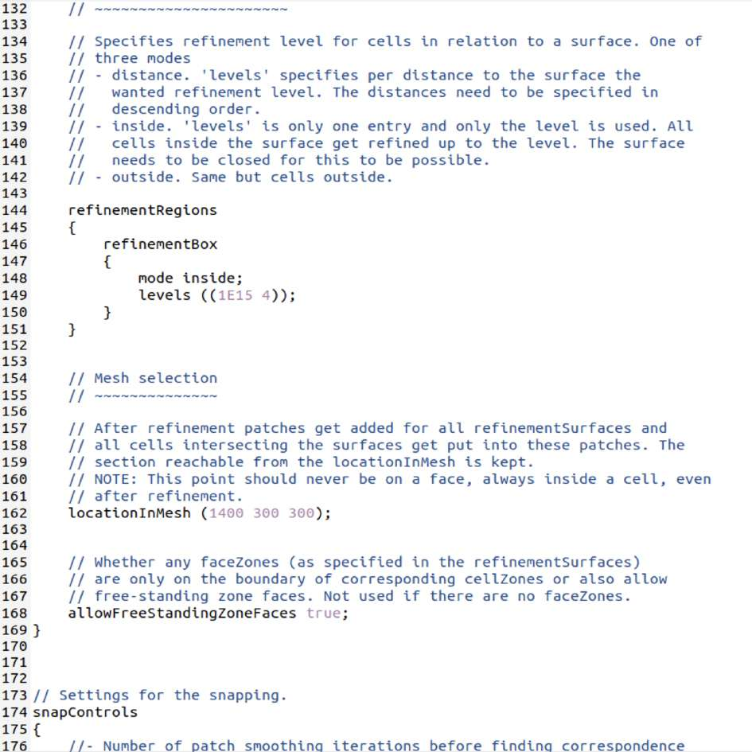
[picture p92: figure]

Department of Mechanical Engineering | 90 | Dayananda Sagar College of Engineering

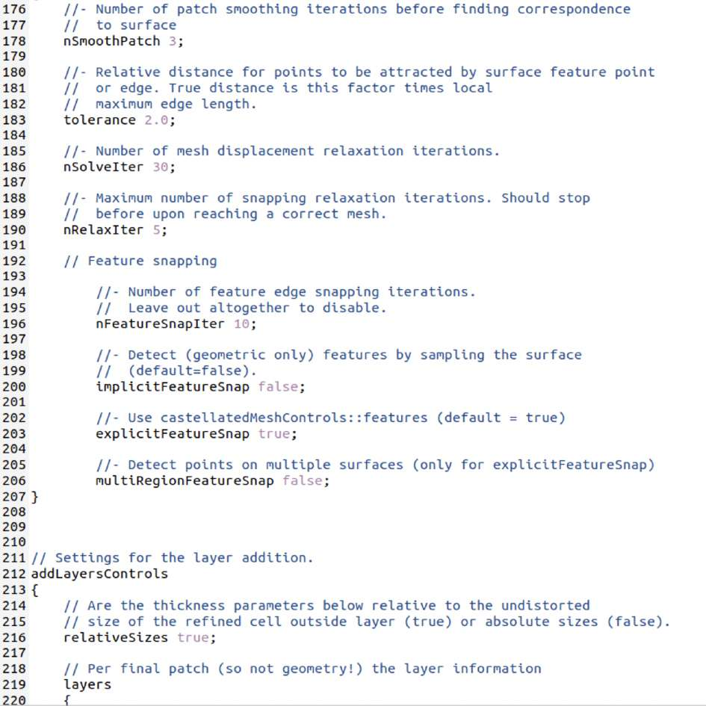
[picture p93: figure]

Department of Mechanical Engineering | 91 | Dayananda Sagar College of Engineering

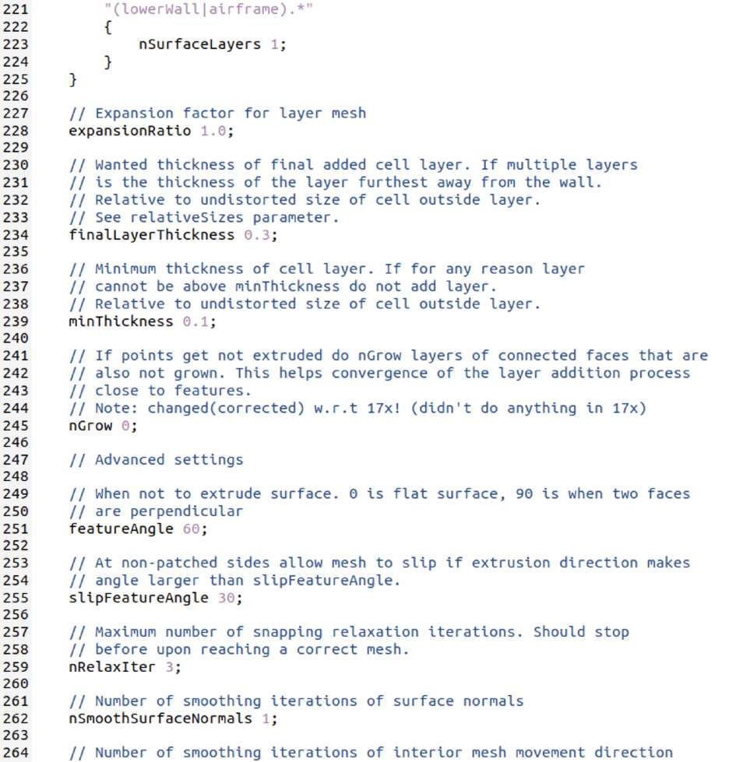
[picture p94: figure]

Department of Mechanical Engineering | 92 | Dayananda Sagar College of Engineering

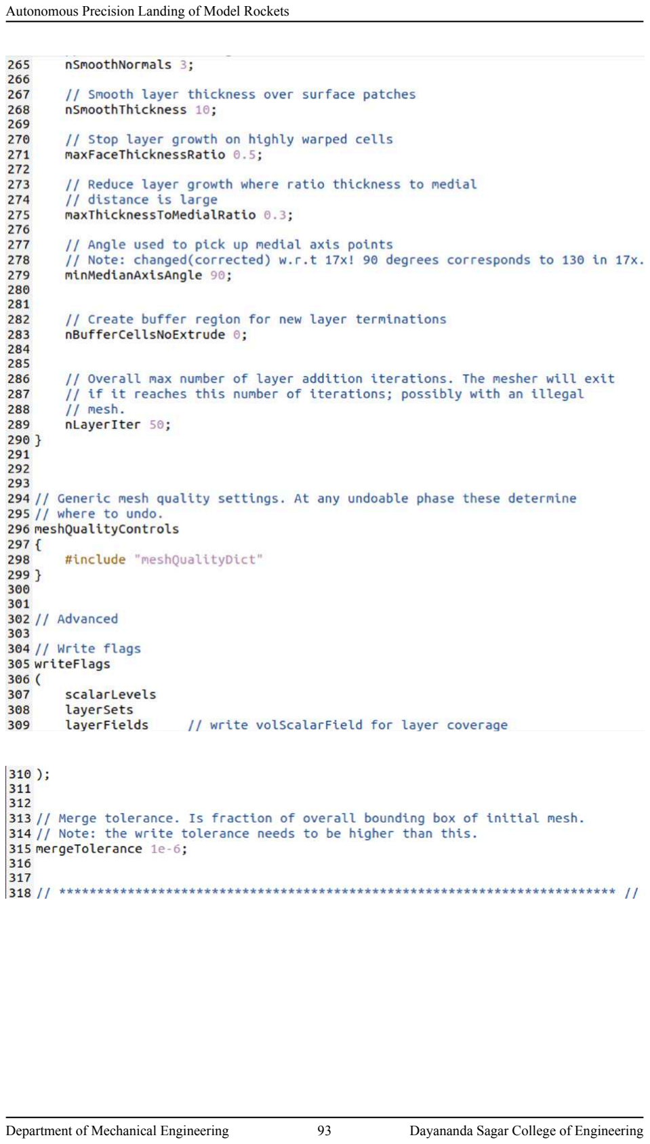
[picture p95: page 107]

Department of Mechanical Engineering | 93 | Dayananda Sagar College of Engineering

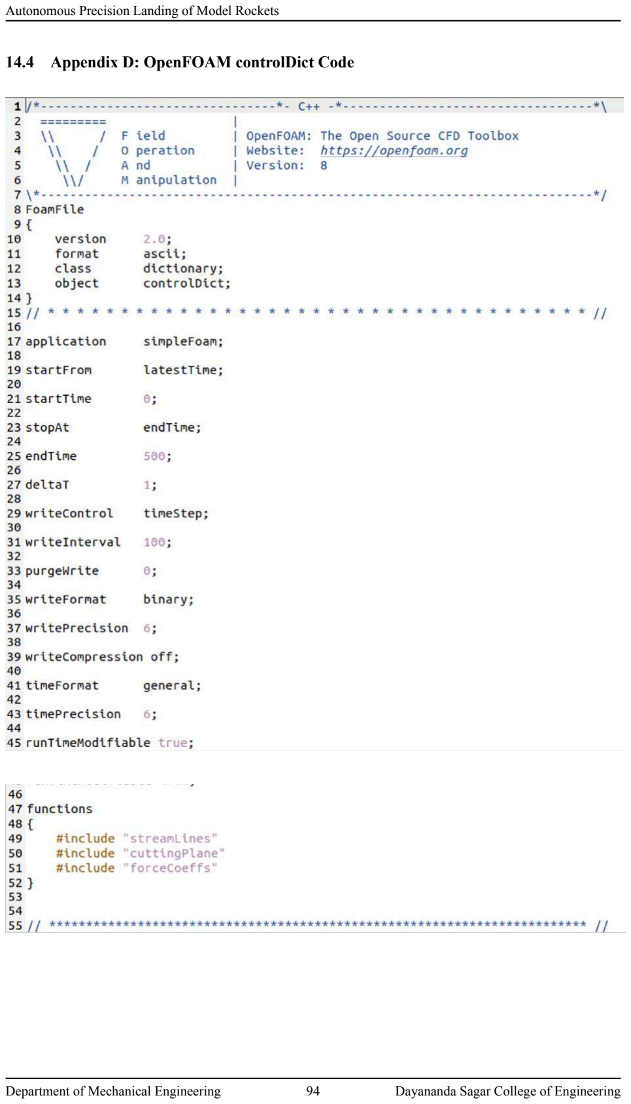
[picture p96: page 108]

### 14.4 Appendix D: OpenFOAM controlDict Code

Department of Mechanical Engineering | 94 | Dayananda Sagar College of Engineering

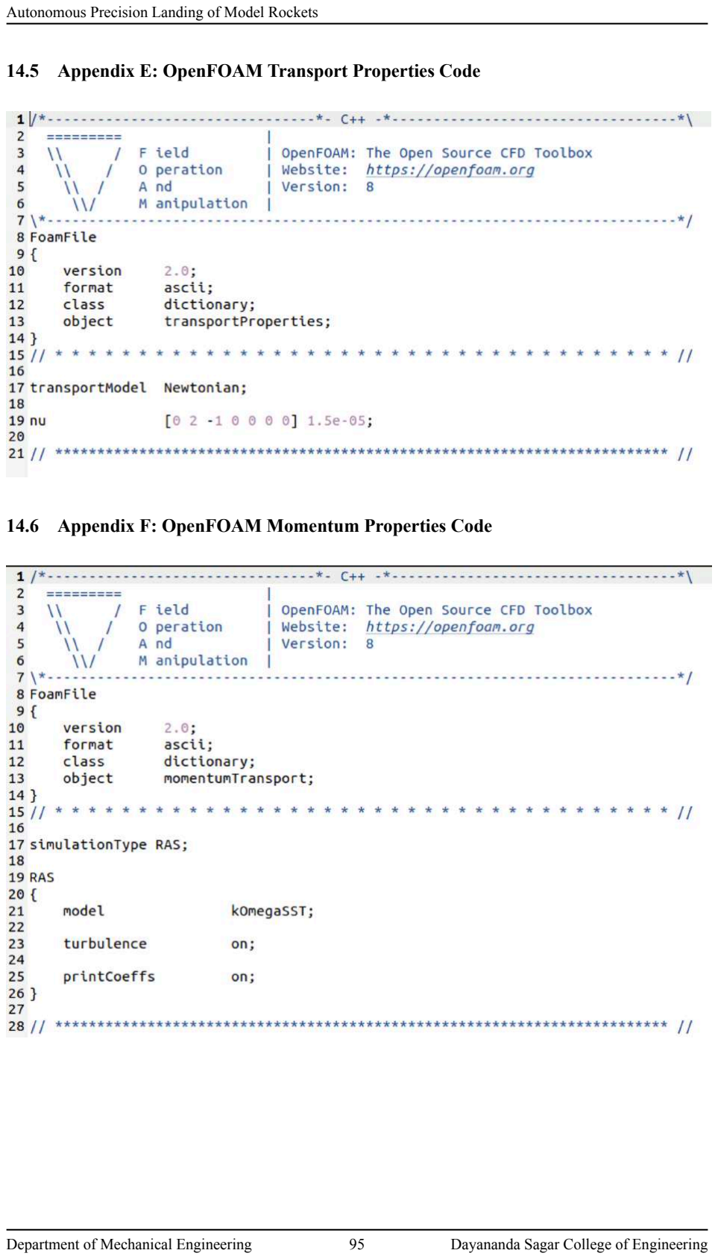
[picture p97: page 109]

### 14.5 Appendix E: OpenFOAM Transport Properties Code

### 14.6 Appendix F: OpenFOAM Momentum Properties Code

Department of Mechanical Engineering | 95 | Dayananda Sagar College of Engineering

### 14.7 Appendix G: Transport Theorem / Equation of Coriolis Derivation

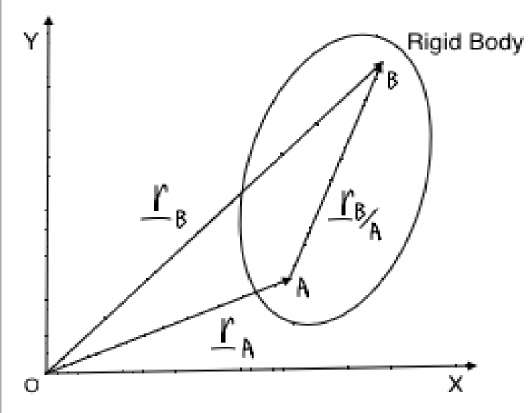
[picture p98: figure]

rB = rA + rB/A | (71)

Differentiating r with respect to time,

rḂ =ṙA +ṙB/A | (72)

We know that,

rḂ/A = ω × rB/A | (73)

Substituting equation 73 in equation 72,

rḂ =ṙA + ω × rB/A

VB = VA + ω × rB/A

(74)

### 14.8 Appendix H: Cross-Product Matrix Derivation [r×]

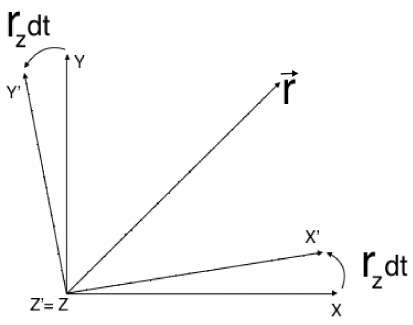
[picture p99: figure]

Department of Mechanical Engineering | 96 | Dayananda Sagar College of Engineering

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

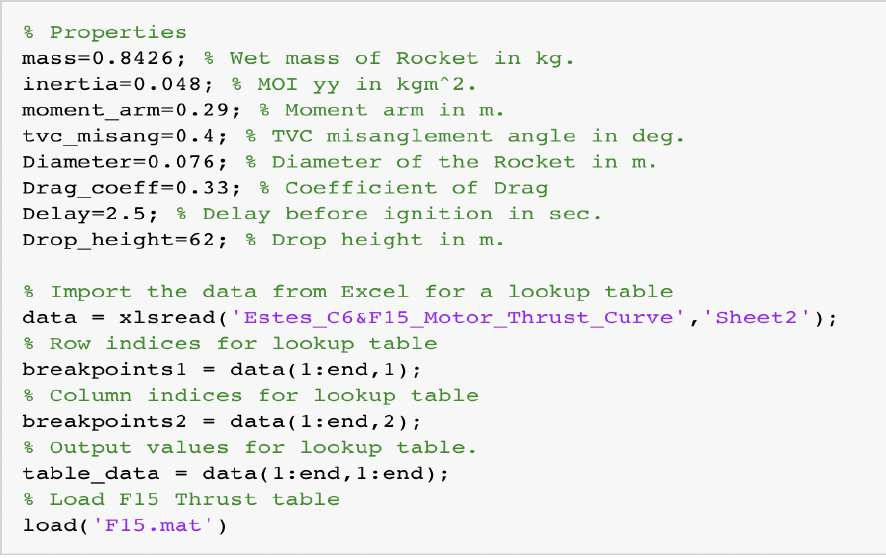
[picture p100: figure]

### 14.10 Appendix J: Arduino Flight Computer Code

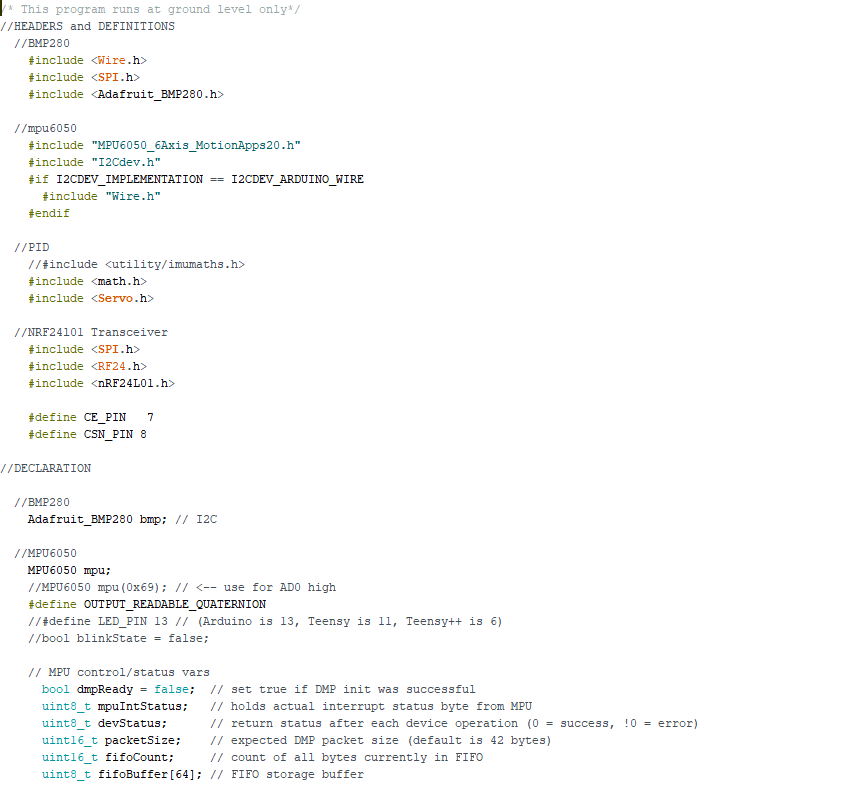
[picture p101: figure]

Department of Mechanical Engineering | 99 | Dayananda Sagar College of Engineering

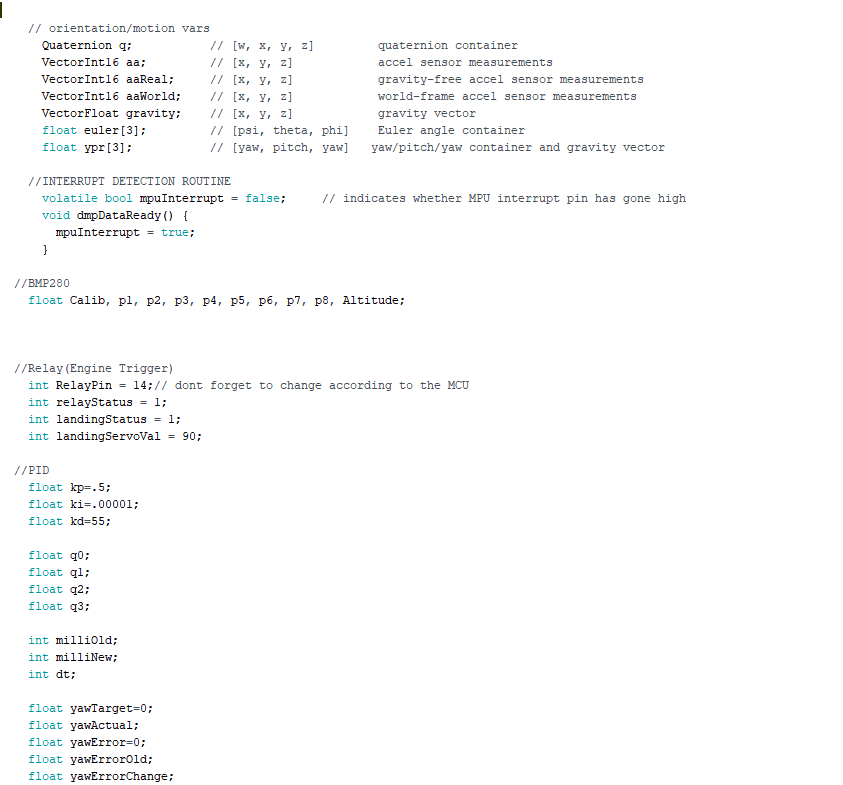
[picture p102: figure]

Department of Mechanical Engineering | 100 | Dayananda Sagar College of Engineering

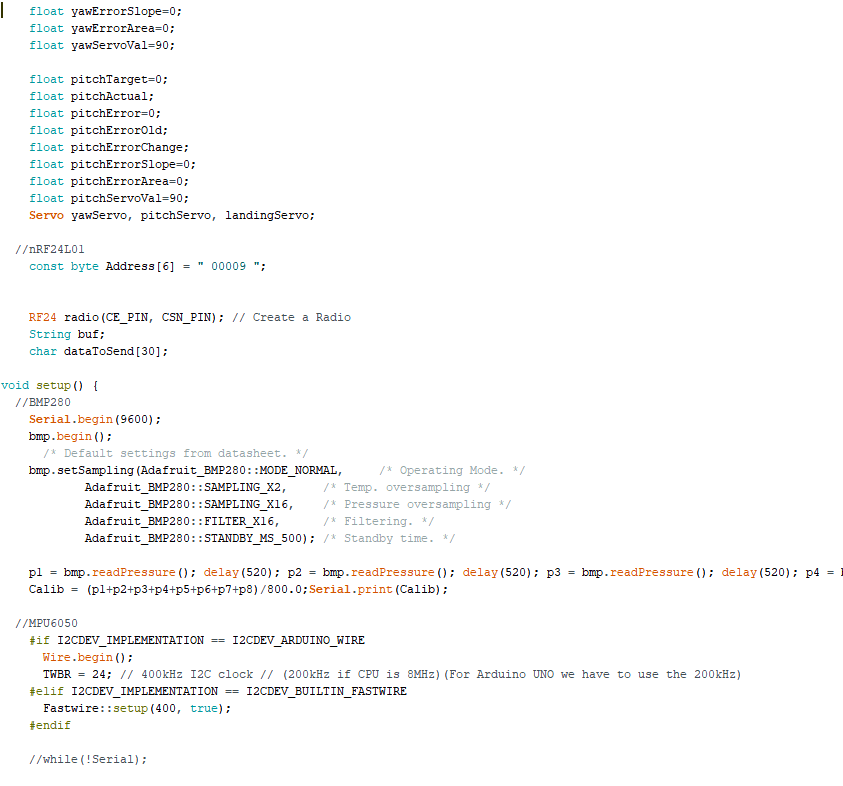
[picture p103: figure]

Department of Mechanical Engineering | 101 | Dayananda Sagar College of Engineering

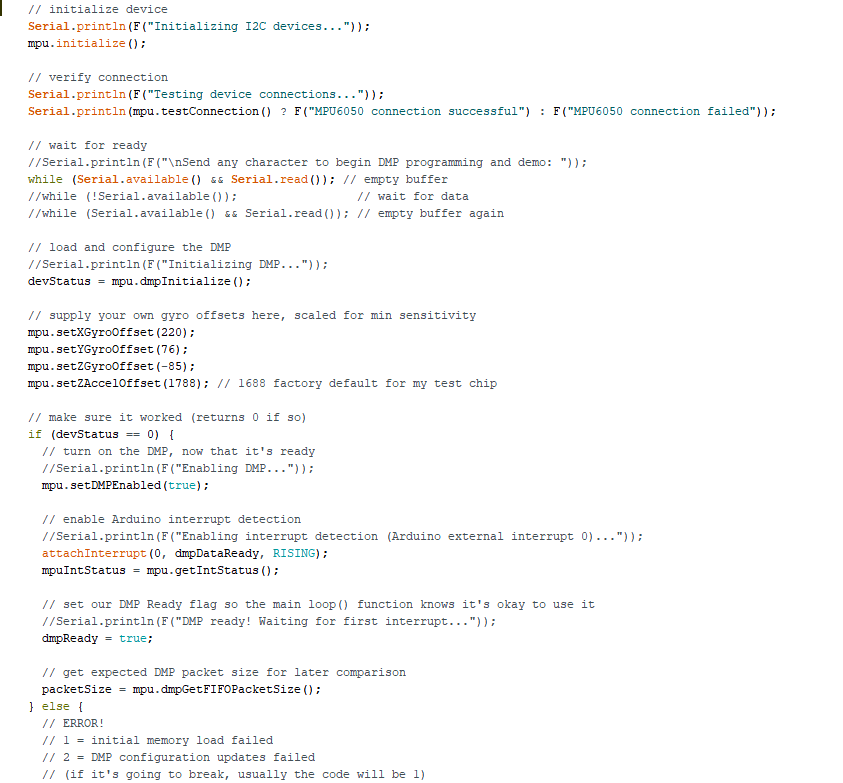
[picture p104: figure]

Department of Mechanical Engineering | 102 | Dayananda Sagar College of Engineering

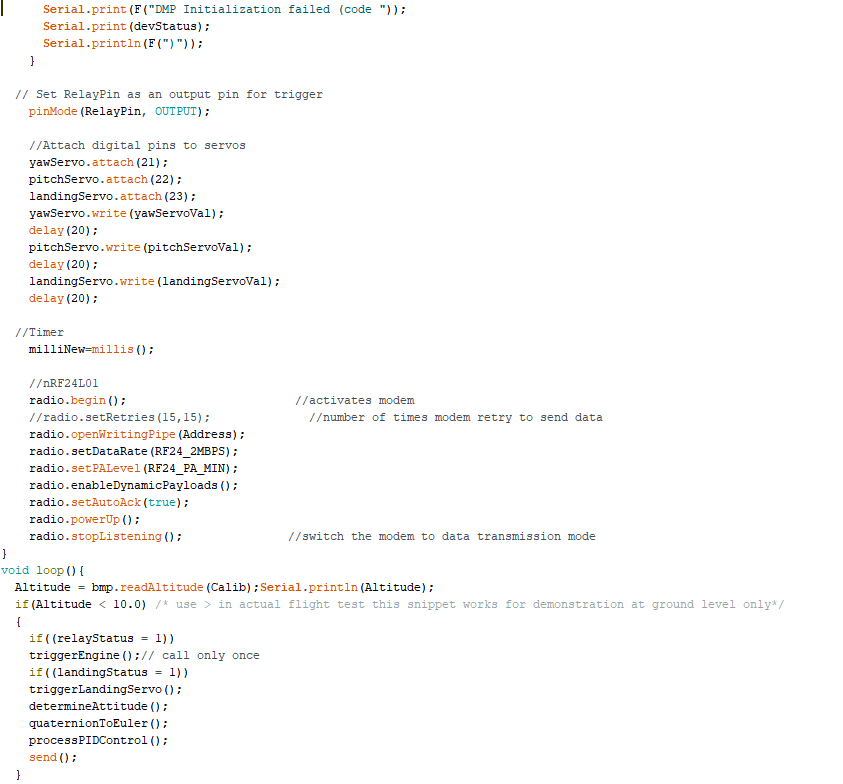
[picture p105: figure]

Department of Mechanical Engineering | 103 | Dayananda Sagar College of Engineering

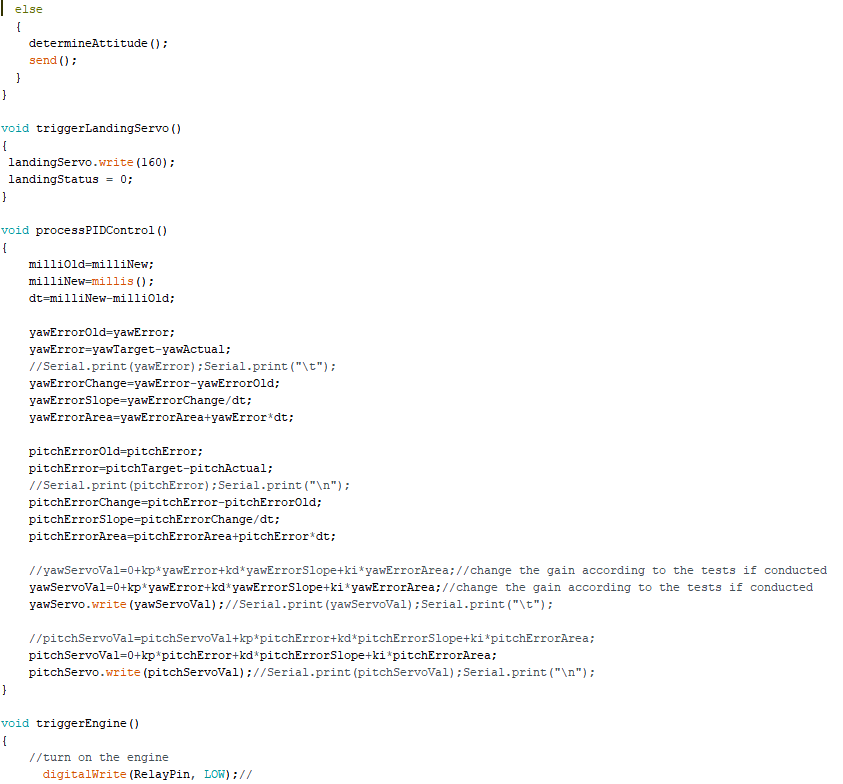
[picture p106: figure]

Department of Mechanical Engineering | 104 | Dayananda Sagar College of Engineering

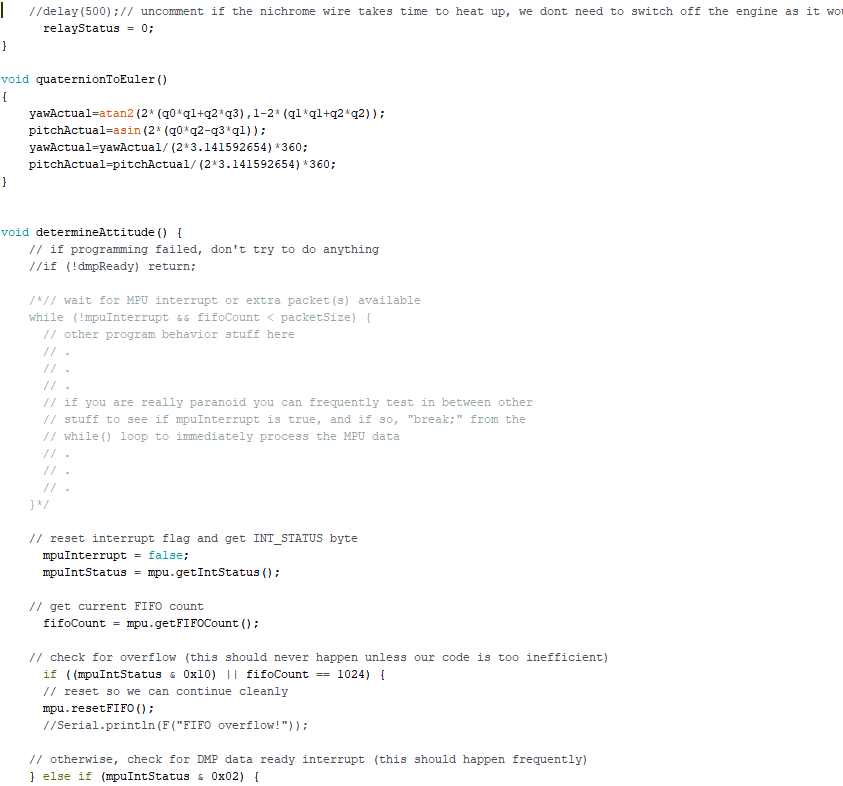
[picture p107: figure]

Department of Mechanical Engineering | 105 | Dayananda Sagar College of Engineering

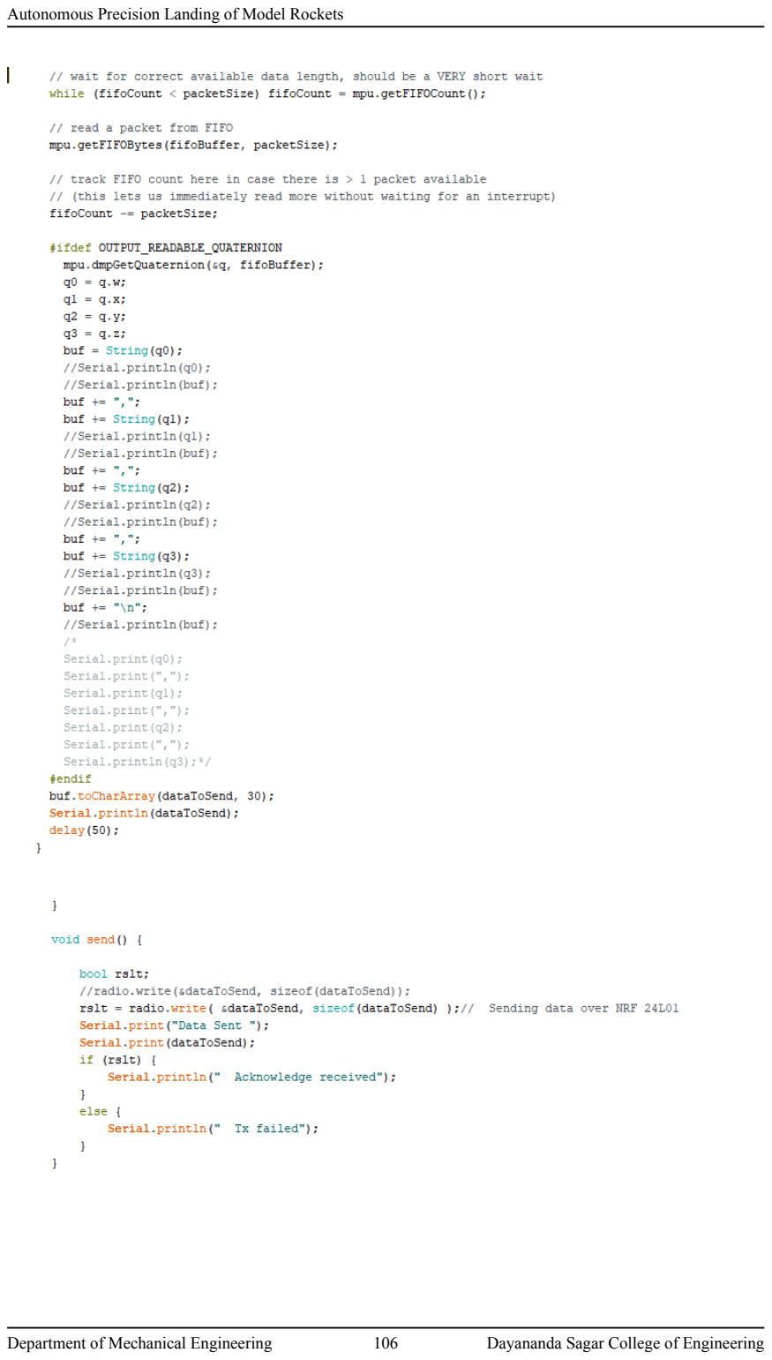
[picture p108: page 120]

Department of Mechanical Engineering | 106 | Dayananda Sagar College of Engineering

### 14.11 Appendix K: Python Animation Processing Code

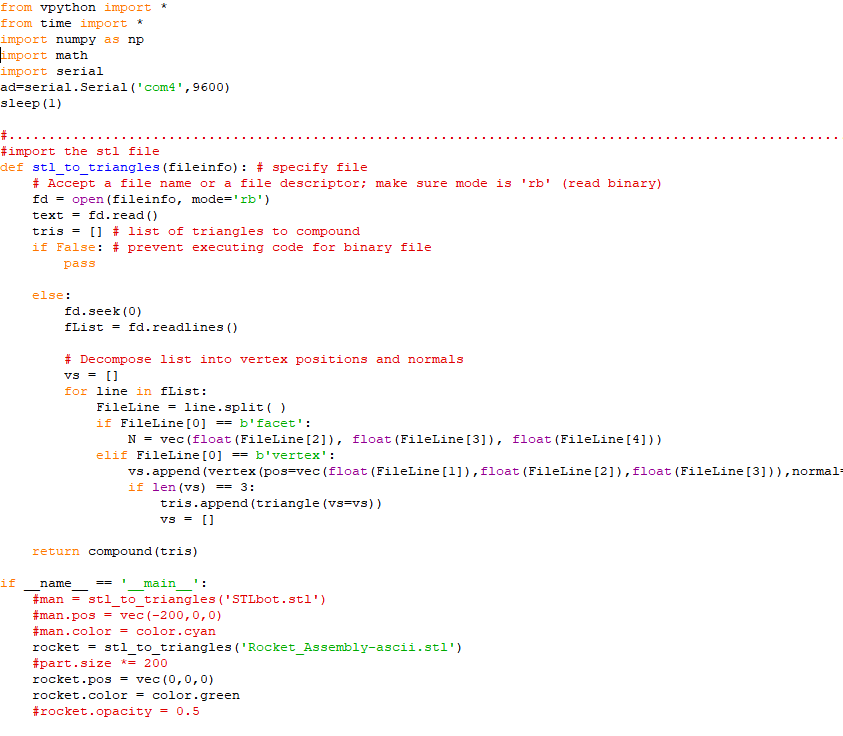
[picture p109: figure]

Department of Mechanical Engineering | 107 | Dayananda Sagar College of Engineering

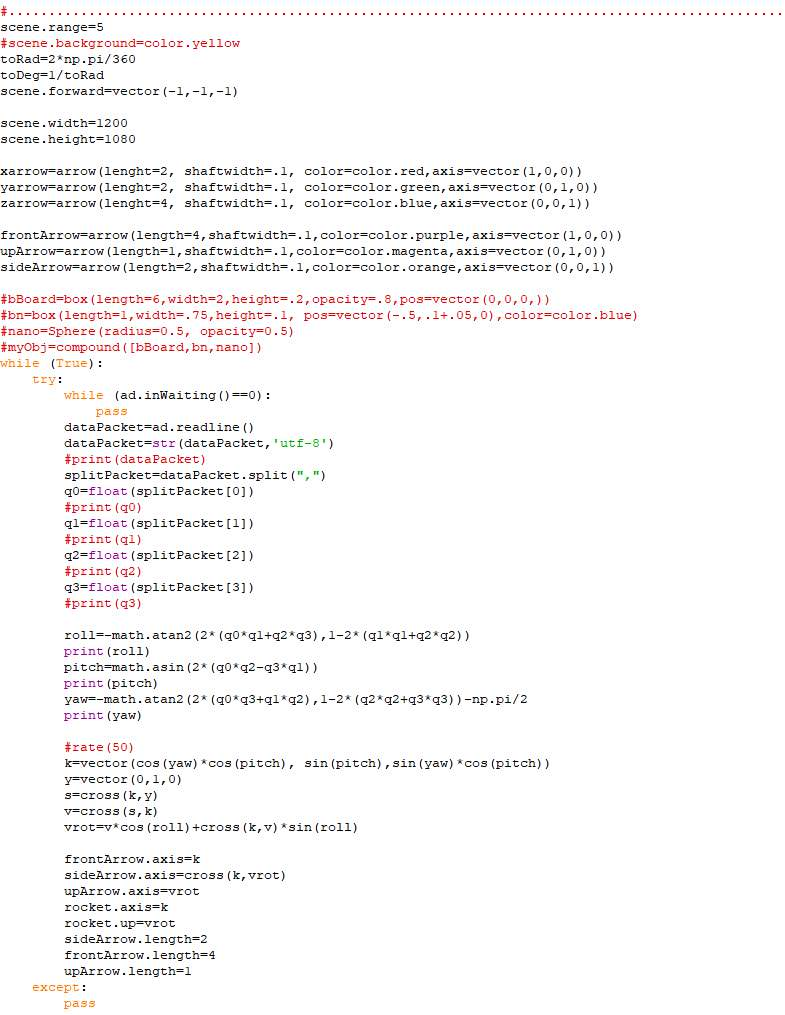
[picture p110: figure]

Department of Mechanical Engineering | 108 | Dayananda Sagar College of Engineering

## 15 ANNEXURE

# Anti-Plagiarism Report

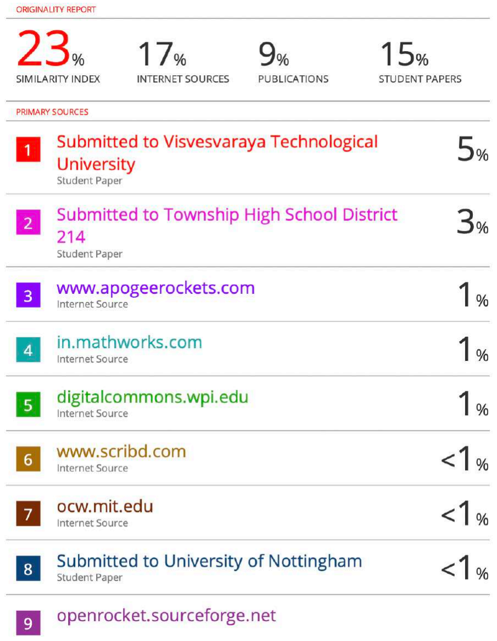
[picture p111: figure]

Department of Mechanical Engineering | 109 | Dayananda Sagar College of Engineering
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
