raghavvs/Autonomous-Landing-of-Model-Rockets/Rocket Design/Airframe Specifications.xlsx

Rocket - Airframe Specifications
Length to Diameter Range of Ratios - 10:1 to 20:1 |  |  |  |  | Root Fin to Diameter - 2:1
 | Length | Diameter | Ratio |  | Root Fin | Diameter | Ratio
1 | 30 | 3 | 10 | 1 | 6 | 3 | 2
2 | 36 | 3 | 12 | 2 | 8 | 4 | 2
3 | 42 | 3 | 14
4 | 48 | 3 | 16 |  | Chord to Diameter - 1:1
5 | 60 | 3 | 20
6 | 40 | 4 | 10 |  | Chord | Diameter | Ratio
7 | 48 | 4 | 12 | 1 | 3 | 3 | 1
8 | 56 | 4 | 14 | 2 | 4 | 4 | 1
9 | 60 | 4 | 15
10 | 72 | 4 | 18
