raghavvs/Autonomous-Landing-of-Model-Rockets/Rocket Design/Rocket_Assembly_New_1 v6.stl

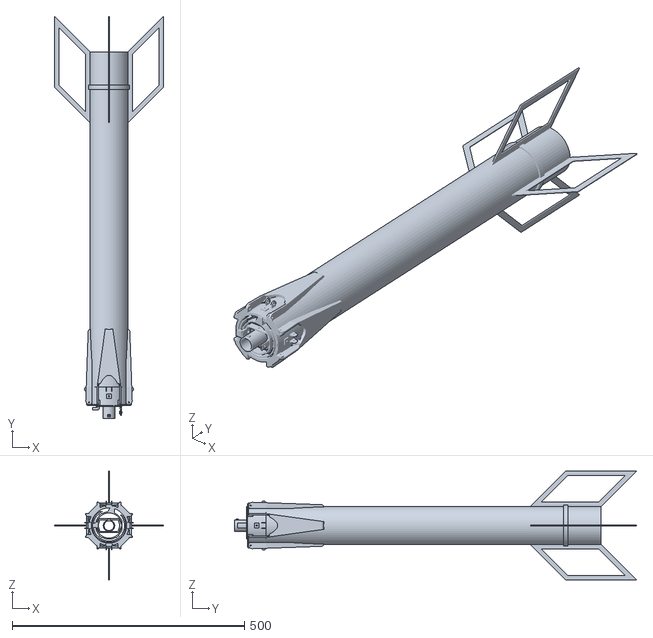
[picture p112: CAD file, 2021-11-15]
Rocket Design/Rocket_Assembly_New_1 v6.stl
234.6 x 866.2 x 234.6
