raghavvs/Autonomous-Landing-of-Model-Rockets/Rocket Design/Rocket_Assembly_New_April_1.stl

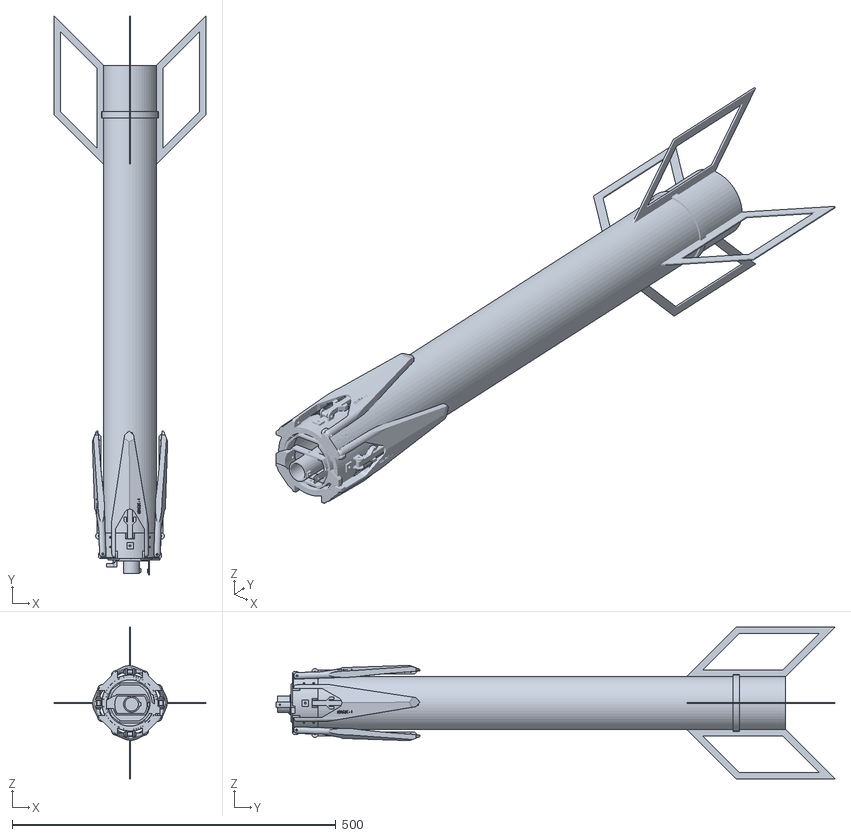
[picture p113: CAD file, 2021-11-15]
Rocket Design/Rocket_Assembly_New_April_1.stl
234.6 x 863.9 x 234.6
