raghavvs/Autonomous-Landing-of-Model-Rockets/Rocket Design/Rocket_Assembly_New_3 v9.stl

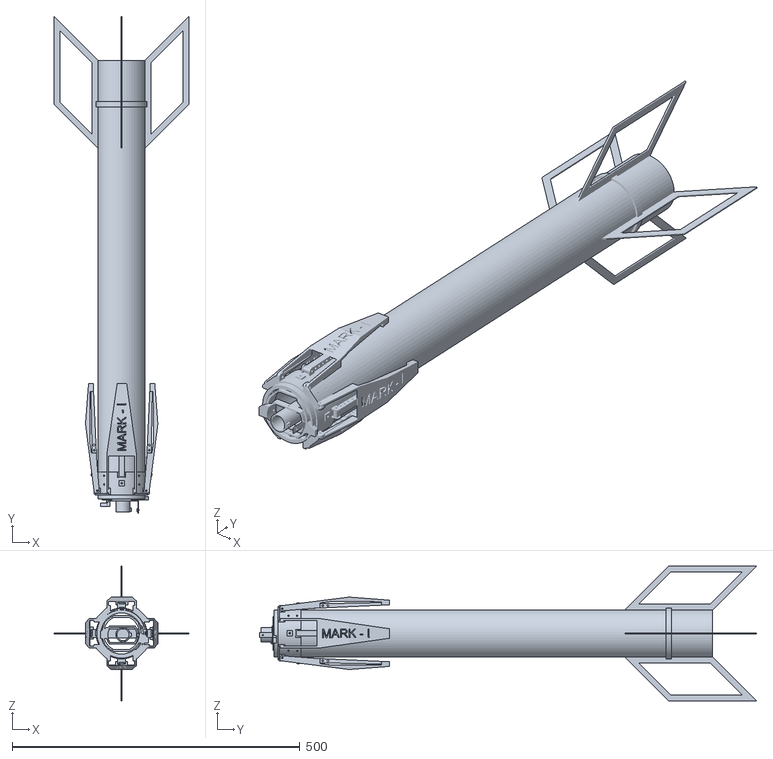
[picture p114: CAD file, 2021-11-15]
Rocket Design/Rocket_Assembly_New_3 v9.stl
234.6 x 863.9 x 234.6
