raghavvs/Autonomous-Landing-of-Model-Rockets/Rocket Design/FYP_Rocket_1 v11.iges

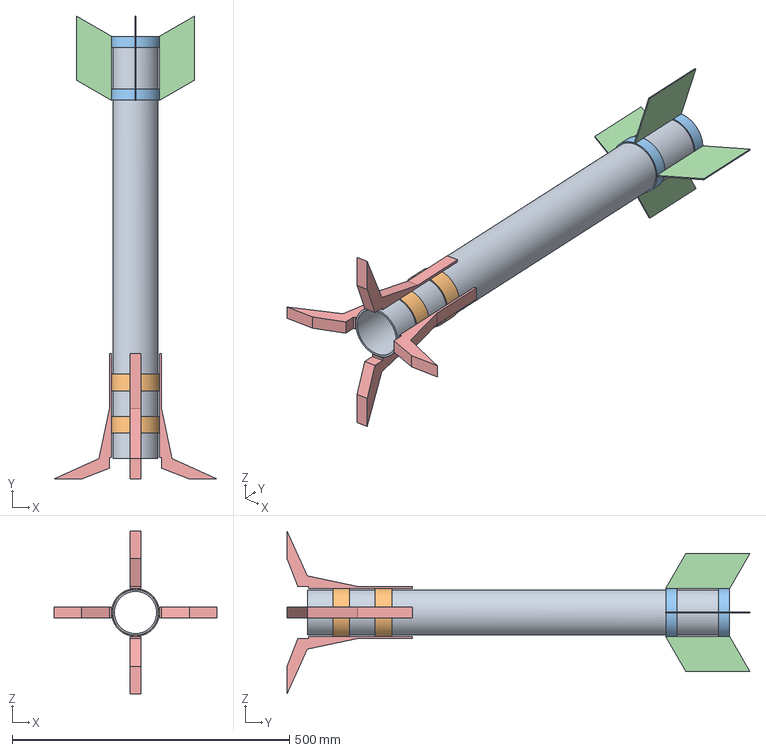
[picture p115: CAD file, 2021-11-15]
Rocket Design/FYP_Rocket_1 v11.iges
294.2 x 835.5 x 294.2 mm
