raghavvs/Autonomous-Landing-of-Model-Rockets/Rocket Design/Rocket_Airframe_Tube v7.stl

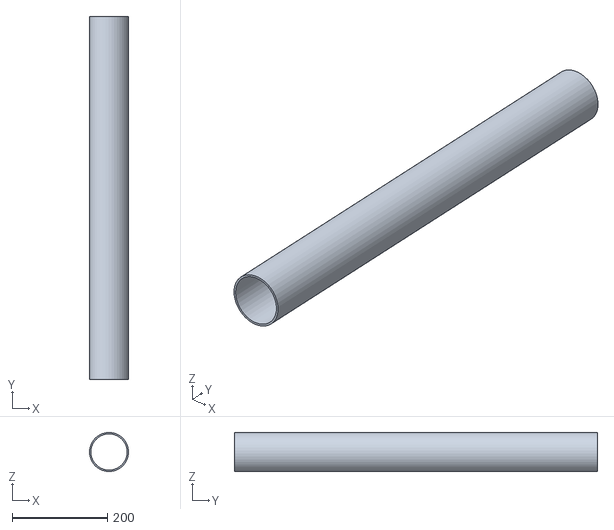
[picture p116: CAD file, 2021-11-15]
Rocket Design/Rocket_Airframe_Tube v7.stl
81.9 x 762.0 x 81.9
