raghavvs/Autonomous-Landing-of-Model-Rockets/Rocket Design/Bulkhead v3.stl

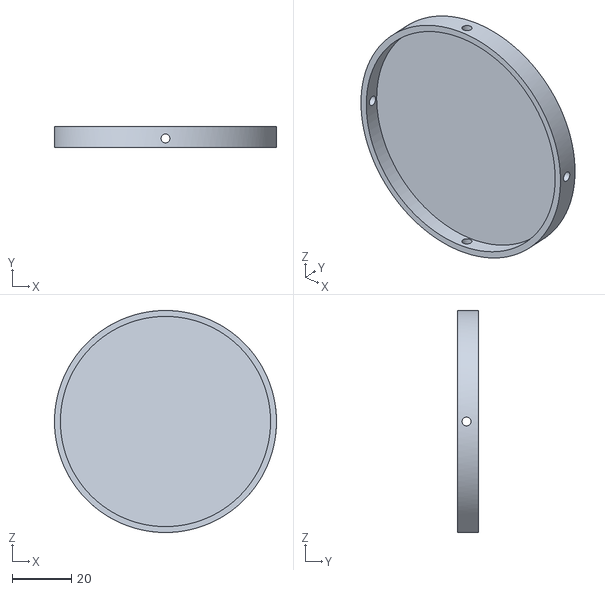
[picture p117: CAD file, 2021-11-15]
Rocket Design/Bulkhead v3.stl
75.0 x 7.00 x 75.0
