raghavvs/Autonomous-Landing-of-Model-Rockets/Rocket Design/Rocket Stand.stl

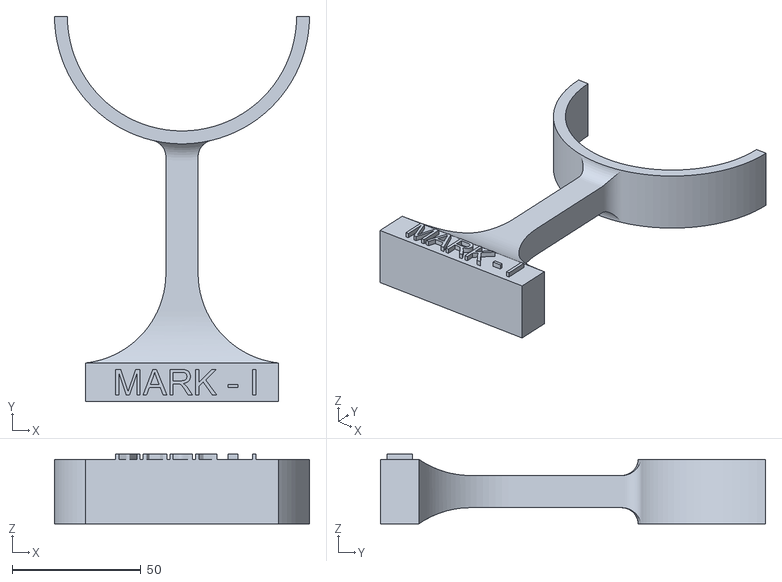
[picture p118: CAD file, 2021-11-15]
Rocket Design/Rocket Stand.stl
98.9 x 149.4 x 27.0
