raghavvs/Autonomous-Landing-of-Model-Rockets/Rocket Design/Rocket_Airframe_Tube_OpenFOAM.stl

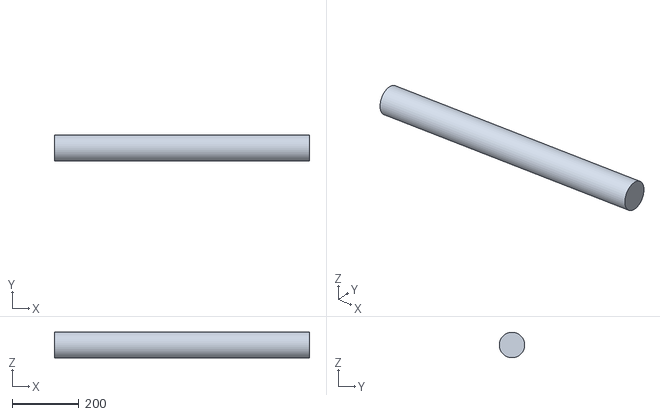
[picture p119: CAD file, 2021-11-15]
Rocket Design/Rocket_Airframe_Tube_OpenFOAM.stl
762.0 x 76.2 x 76.2
