raghavvs/Autonomous-Landing-of-Model-Rockets/Rocket Design/Rocket_Airframe_Fins_LL v3.stl

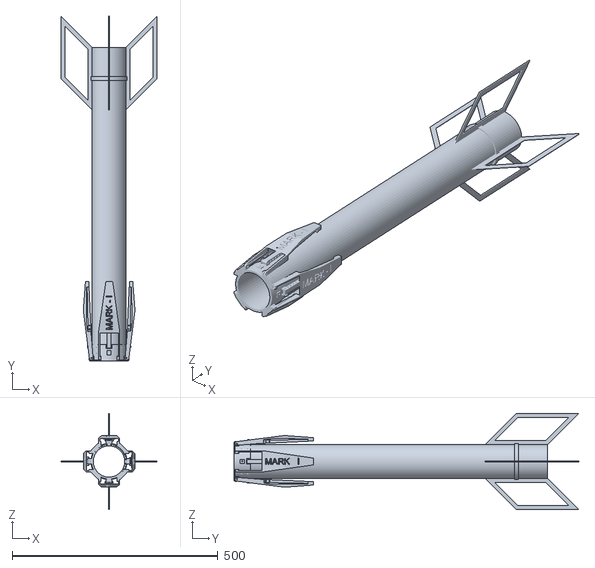
[picture p120: CAD file, 2021-11-15]
Rocket Design/Rocket_Airframe_Fins_LL v3.stl
234.6 x 839.3 x 234.6
