raghavvs/Autonomous-Landing-of-Model-Rockets/(list of files, cad)

Other CAD files:
Rocket Design/Rocket_Airframe_Fins_LL v3.f3z
Rocket Design/Rocket_Airframe_Tube v7.f3d
Rocket Design/Rocket_Airframe_Tube_OpenFOAM.obj
Rocket Design/Rocket_Assembly_New_1 v6.f3z
