raghavvs/Autonomous-Landing-of-Model-Rockets/Drag Analysis/Performance1.xlsx

Micro Class Performance
 |  |  | Velocity (in m/s) | Velocity (in ft/s) | Reynolds number (Re) | Skin Friction Drag coefficient (Cf) | Mach number (M) | FFm | Swet/S | CDmin | CD0 | CL | CDi | CD | Thrust
Specifications: |  |  | 1 | 3.281 | 0.2031910039 | 0.1017772763 | 0.002915451895 | 0.9999957501 | 2.043841336 | 0.02600207556 | 0.05497754972 | 179.866887 | 1413.298707 | 1413.353684 | 40.18812321
 | in inches | in feet | 2 | 6.562 | 0.4063820078 | 0.08860226524 | 0.00583090379 | 0.9999830001 | 2.043841336 | 0.02263612152 | 0.0452784388 | 44.96672175 | 88.33116917 | 88.37644761 | 10.05178988
Wing span (b) | 46 | 3.83 | 3 | 9.843 | 0.6095730117 | 0.08170084976 | 0.008746355685 | 0.9999617499 | 2.043841336 | 0.02087294674 | 0.0404181715 | 19.98520967 | 17.44813218 | 17.48855035 | 4.475516792
MAC (c) | 6 | 0.5 | 4 | 13.124 | 0.8127640156 | 0.07713275192 | 0.01166180758 | 0.9999319988 | 2.043841336 | 0.01970588834 | 0.03728901355 | 11.24168044 | 5.520698073 | 5.557987087 | 2.528624758
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
